pesantsi/CustomPcbs/TooManyKeys/Diagrams/Bonjour.docx

Bonjour,

Je me fais un petit projet d'un keyboard et j'aimerais faire couper la plaque du dessus qui contient les touches, avez-vous différents métaux?

J'aimerais bien hot rolled steel 1.5mm ou un équivalent pour son poids et sa solidité.

Merci beaucoup

Hi,

I've created a custom keyboard prototype.

I would like the key plate to be laser cut from hot rolled mild steel of 1.5mm thickness or any other dark, heavy strong metal.

This is a prototype; it could end up having more orders.

Thanks
