pesantsi/CustomPcbs/TooManyKeys/Diagrams/Led Layout routing.png

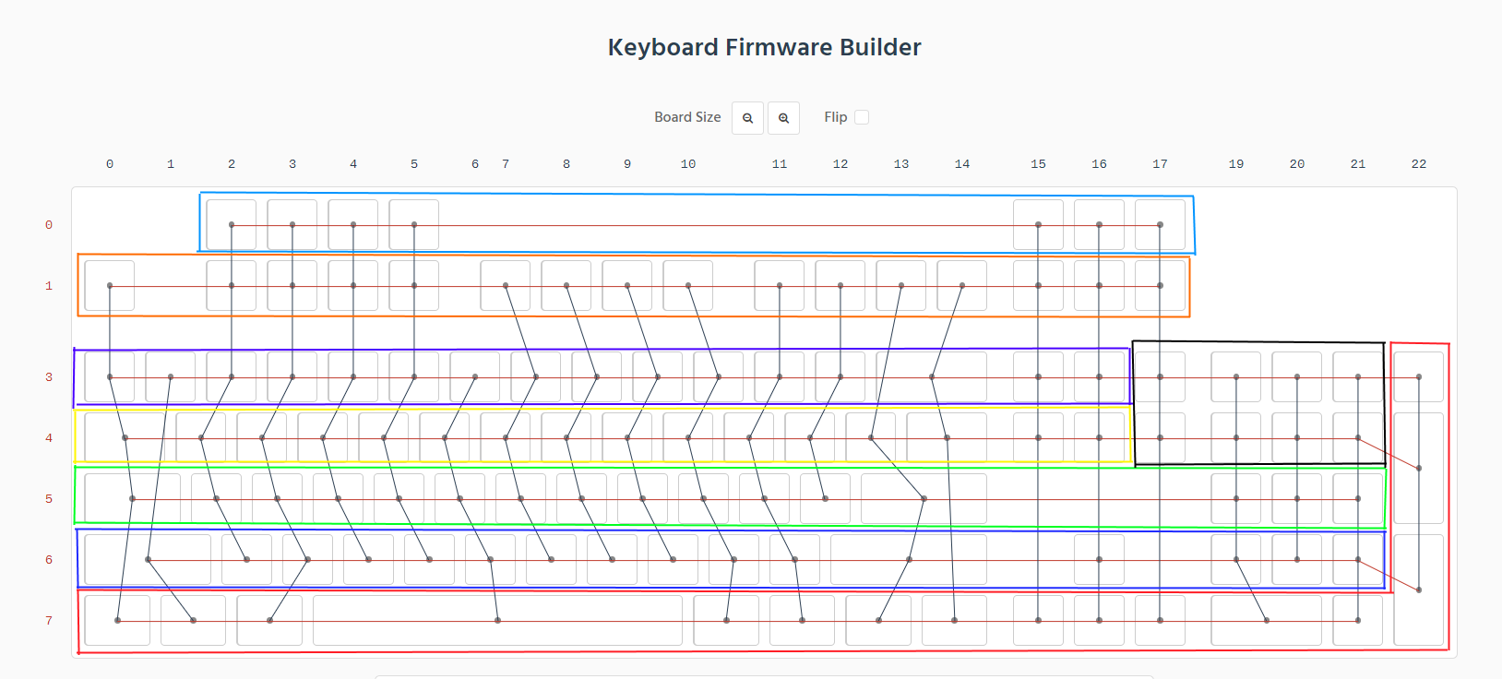
TooManyKeys/Diagrams/Led Layout routing.png
