pesantsi/CustomPcbs/TooManyKeys/KiCad/Resources/Pics/1054418752008t.jpg

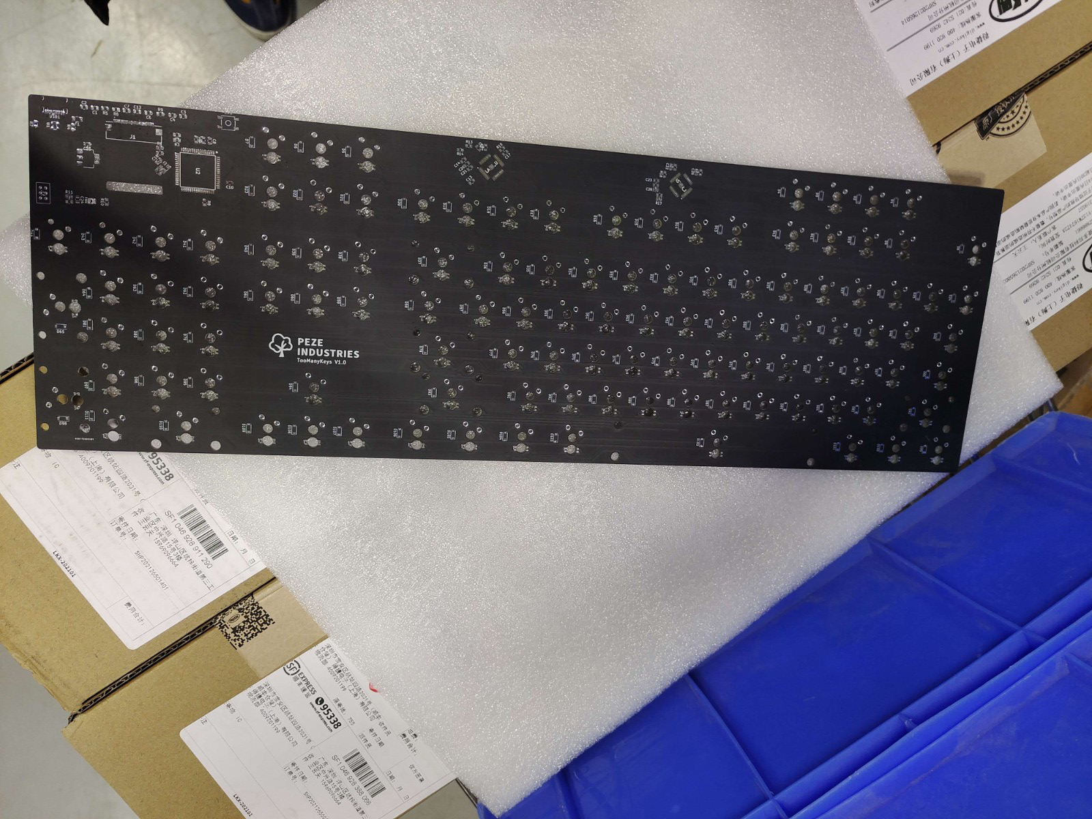
TooManyKeys/KiCad/Resources/Pics/1054418752008t.jpg
