pesantsi/CustomPcbs/TooManyKeys/KiCad/Resources/Pics/1054459162442t.jpg

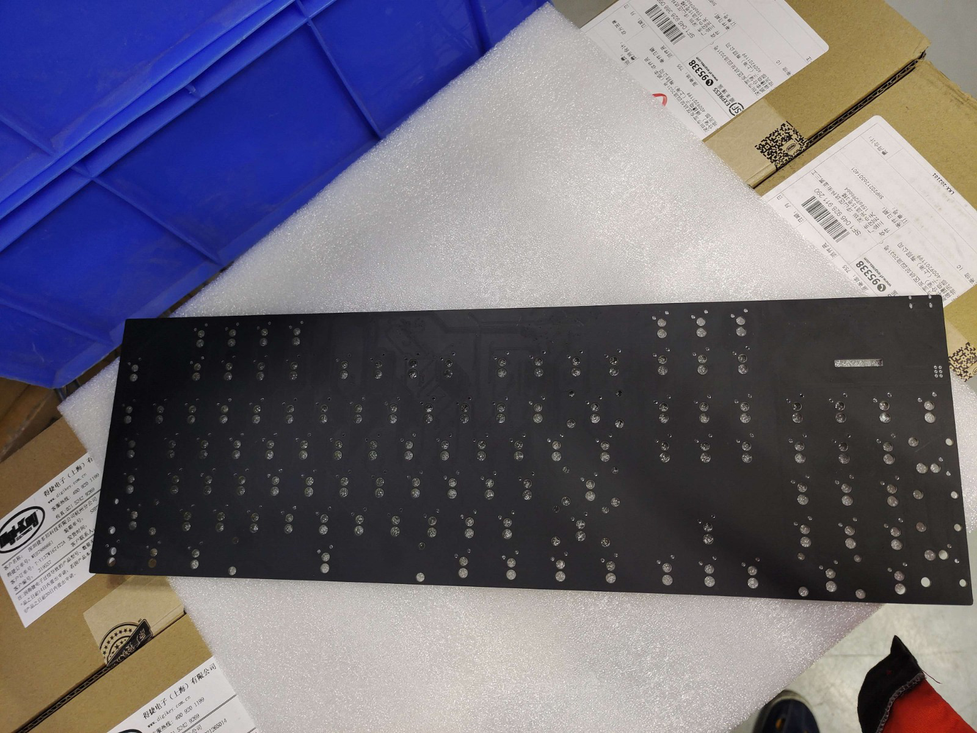
TooManyKeys/KiCad/Resources/Pics/1054459162442t.jpg
