pesantsi/CustomPcbs/TooManyKeys/KiCad/Resources/duckypad_v2_bom.xlsx

Qty | Value | Device | Parts
4 | 1uF | 0805 Capacitor | C3, C4, C6, C28
3 | 2.2uF | 0805 Capacitor | C5, C7, C8
4 | 5.1K | 0805 Resistor | R1, R7, R8, R9
4 | 10K | 0805 Resistor | R2, R4, R5, R17
1 | 47uF | 1210 Tantalum Capacitor | C27
1 |  | 74LVC1G08 | IC3
20 | 100nF | 0805 Capacitor | C1, C2, C9, C10, C11, C12, C13, C14, C15, C16, C17, C18, C19, C20, C21, C22, C23, C24, C25, C29
4 |  | Tactile Switch | SW1, SW2, SW3, SW4
1 | 560K | 0805 Resistor | R3
15 |  | CherryMX-style Key Switch | S1, S2, S3, S4, S5, S6, S7, S8, S9, S10, S11, S12, S13, S14, S15
1 | 3.3V | 1117 Regulator | IC2
1 |  | STM32F072C8T6 | IC1
1 |  | MicroSD Sard Holder | SD1
1 |  | 30 pin FPC Connecter for OLED, Upper Contact | U1
1 |  | USB-C Connector 16Pin | U2
15 |  | SK6812 RGB LED | LED1, LED2, LED3, LED4, LED5, LED6, LED7, LED8, LED9, LED10, LED11, LED12, LED13, LED14, LED15
