pesantsi/CustomPcbs/TooManyKeys/Diagrams/Updated T-1N2W367723A-W367723AS1N1-1sets-TooManyKeys2.html 2021-2-5.xlsx

C:\Git\CustomPcbs\TooManyKeys\KiCad\TooManyKeys.sch
2021-02-01 09:52
Eeschema (5.1.9)-1
Component Count:281
Ref | Qnty | Value | Part | Footprint | Description | Vendor | Unit Price 5sets | Total Price | PCBWay Comments
C1, C2, C3, C5, C8, C12 | 6 | 1uF | Device:C_Small | Capacitor_SMD:C_0805_2012Metric | Unpolarized capacitor, small symbol |  | $0.052 | $1.575 | 1UF 50V 0805
C4, C6, C7 | 3 | 2.2uF | Device:C_Small | Capacitor_SMD:C_0805_2012Metric | Unpolarized capacitor, small symbol |  | $0.105 | $1.575 | 2.2UF 6.3V 0805
C9, C10, C11, C13, C16, C20, C22, C26, C29 | 9 | 0.1uF | Device:C_Small | Capacitor_SMD:C_0805_2012Metric | Unpolarized capacitor, small symbol |  | $0.052 | $2.363 | 0.1UF 50V 0805
C14, C17, C19, C21, C23, C27, C28, C30 | 8 | 0.47uF | Device:C_Small | Capacitor_SMD:C_0805_2012Metric | Unpolarized capacitor, small symbol |  | $0.105 | $4.200 | 0.47UF 16V 0805
C15, C18 | 2 | 22pF | Device:C_Small | Capacitor_SMD:C_0805_2012Metric | Unpolarized capacitor, small symbol |  | $0.052 | $0.525 | 22PF 50V 0805
C24 | 1 | 10uF | Device:C_Small | Capacitor_SMD:C_0805_2012Metric | Unpolarized capacitor, small symbol |  | $0.210 | $1.050 | 10UF 6.3V 0805
C25 | 1 | 22uF | Device:C_Small | Capacitor_SMD:C_0805_2012Metric | Unpolarized capacitor, small symbol |  | $0.210 | $1.050 | 22UF 6.3V 0805
D1, D2, D3, D4, D5, D6, D7, D8, D9, D10, D11, D12, D13, D14, D15, D16, D17, D18, D19, D20, D21, D22, D23, D24, D25, D26, D27, D28, D29, D30, D31, D32, D33, D34, D35, D36, D37, D38, D39, D40, D41, D42, D43, D44, D45, D46, D47, D48, D49, D50, D51, D52, D53, D54, D55, D56, D57, D58, D59, D60, D61, D62, D63, D64, D65, D66, D67, D68, D69, D70, D71, D72, D73, D74, D75, D76, D77, D78, D79, D80, D81, D82, D83, D84, D85, D86, D87, D88, D89, D90, D91, D92, D93, D94, D95, D96, D97, D98, D99, D100, D101, D102, D103, D104, D105, D106, D107, D108, D109, D110, D111 | 111 | SOD-123 | Device:D_Small | Diode_SMD:D_SOD-123 | Diode, small symbol |  | $0.105 | $58.275 | 1N4148W SOD123 | 1N4148W-TP | https://www.mccsemi.com/pdf/Products/1N4148W(SOD123).pdf
F1 | 1 | 1A | Device:Polyfuse | Fuse:Fuse_1206_3216Metric | Resettable fuse, polymeric positive temperature coefficient |  | $0.420 | $2.100 | 0ZCJ0100FF2E 7-10WORK DAYS | 0ZCJ0100FF2E | https://www.mouser.ca/datasheet/2/643/ds_CP_0zcj_series-1664160.pdf
J1 | 1 | 54104-3031 | SamacSys_Parts:505110-3091 | SamacSys_Parts:0541043033 | CONN FFC TOP 30POS 0.50MM R/A | https://www.molex.com/pdm_docs/sd/541043031_sd.pdf | $2.940 | $14.700 | 5-7work days
LED1, LED2, LED3, LED4, LED5, LED6, LED7, LED8, LED9, LED10, LED11, LED12, LED13, LED14, LED15, LED16, LED17, LED18, LED19, LED20, LED21, LED22, LED23, LED24, LED25, LED26, LED27, LED28, LED29, LED30, LED31, LED32, LED33, LED34, LED35, LED36, LED37, LED38, LED39, LED40, LED41, LED42, LED43, LED44, LED45, LED46, LED47, LED48, LED49, LED50, LED51, LED52, LED53, LED54, LED55, LED56, LED57, LED58, LED59, LED60, LED61, LED62, LED63, LED64, LED65, LED66, LED67, LED68, LED69, LED70, LED71, LED72, LED73, LED74, LED75, LED76, LED77, LED78, LED79, LED80, LED81, LED82, LED83, LED84, LED85, LED86, LED87, LED88, LED89, LED90, LED91, LED92, LED93, LED94, LED95, LED96, LED97, LED98, LED99, LED100, LED101, LED102, LED103, LED104, LED105, LED106, LED107, LED108, LED109, LED110, LED111 | 111 | QBLP677R-RGB | SamacSys_Parts:QBLP677R-RGB | SamacSys_Parts:QBLP677R-RGB |  | http://www.qt-brightek.com/datasheet/QBLP677R-RGB.pdf | $0.578 | $320.513 | 5-7work days
MASTER_U1, SLAVE_U1 | 2 | IS31FL3733-TQ | Driver_LED:IS31FL3733-TQ | SamacSys_Parts:QFP50P900X900X120-49N | 12x16 LED matrix driver with 8-bit PWM and breathing, TQFP-48 | http://www.issi.com/WW/pdf/IS31FL3733.pdf | $3.675 | $36.750 | We will supply IS31FL3733-TQLS4 5-7work days | OK
R1, R8, R13, R16 | 4 | 10k | Device:R_Small | Resistor_SMD:R_0805_2012Metric | Resistor, small symbol |  | $0.052 | $1.050
R2, R3 | 2 | 22 | Device:R_Small | Resistor_SMD:R_0805_2012Metric | Resistor, small symbol |  | $0.052 | $0.525 | 22R
R4, R7 | 2 | 5.1k | Device:R_Small | Resistor_SMD:R_0805_2012Metric | Resistor, small symbol |  | $0.052 | $0.525
R5, R6 | 2 | 2.2k | Device:R_Small | Resistor_SMD:R_0805_2012Metric | Resistor, small symbol |  | $0.052 | $0.525
R9 | 1 | 560K | Device:R_Small | Resistor_SMD:R_0805_2012Metric | Resistor, small symbol |  | $0.052 | $0.263
R10 | 1 | 200k | Device:R_Small | Resistor_SMD:R_0805_2012Metric | Resistor, small symbol |  | $0.052 | $0.263
R11, R12 | 2 | 4.7k | Device:R_Small | Resistor_SMD:R_0805_2012Metric | Resistor, small symbol |  | $0.052 | $0.525
R14, R17 | 2 | 100k | Device:R_Small | Resistor_SMD:R_0805_2012Metric | Resistor, small symbol |  | $0.052 | $0.525
R15, R18 | 2 | 20k | Device:R_Small | Resistor_SMD:R_0805_2012Metric | Resistor, small symbol |  | $0.052 | $0.525
SW1 | 1 | SW_Push | Switch:SW_Push | random-keyboard-parts:SKQG-1155865 | Push button switch, generic, two pins | https://media.digikey.com/pdf/Data%20Sheets/C&K/RS-187R05-DS%20MT_RT.pdf | $0.840 | $4.200 | We will supply RS-187R05A2-DSMTRT ok? | OK
U1 | 1 | PRTR5V0U2X | random-keyboard-parts:PRTR5V0U2X | random-keyboard-parts:SOT143B |  | https://assets.nexperia.com/documents/data-sheet/PRTR5V0U2X.pdf | $0.315 | $1.575
U2 | 1 | AT90USB1286-AU | MCU_Microchip_AVR:AT90USB1286-AU | SamacSys_Parts:QFP80P1600X1600X120-64N | 16MHz, 128kB Flash, 8kB SRAM, 4kB EEPROM, USB 2.0, TQFP-64 | http://ww1.microchip.com/downloads/en/DeviceDoc/7593S.pdf | $10.185 | $50.925 | 5-7work days
U3 | 1 | PCA9306 | Interface:PCA9306 (PCA9306DQER) | SamacSys_Parts:SOP50P310X90-8N | Dual bidirectional I2C Bus and SMBus voltage level translator | https://www.ti.com/lit/ds/symlink/pca9306.pdf?HQS=dis-dk-null-digikeymode-dsf-pf-null-wwe&ts=1612196481852 | $0.840 | $4.200 | We will supply PCA9306DQER | OK | PCA9306TDCURQ1
U4 | 1 | AZ1117CH-3.3TRG1 | Regulator_Linear:AP1117-33 | Package_TO_SOT_SMD:SOT-223-3_TabPin2 | 1A Low Dropout regulator, positive, 3.3V fixed output, SOT-223 | https://www.diodes.com/assets/Datasheets/AZ1117C.pdf | $0.315 | $1.575
USB1 | 1 | HRO-TYPE-C-31-M-12 | TooManyKeys-rescue:HRO-TYPE-C-31-M-12-Type-C | Type-C:HRO-TYPE-C-31-M-12 |  | https://datasheet.lcsc.com/szlcsc/1811131825_Korean-Hroparts-Elec-TYPE-C-31-M-12_C165948.pdf | $1.050 | $5.250 | We will supply TYPE-C-31-M-12 | OK
Y1 | 1 | 16MHz | Device:Crystal_GND24_Small | Crystal:Crystal_SMD_3225-4Pin_3.2x2.5mm | Four pin crystal, GND on pins 2 and 4, small symbol | https://media.digikey.com/pdf/Data%20Sheets/AVX%20PDFs/CX3225SB16000D0GZJC1_Spec.pdf | $1.050 | $5.250 | NX3225SA-16.000M-STD-CSR-1 5-7WORK DAYS | NX3225SA-16.000M-STD-CSR-1 | https://media.digikey.com/pdf/Data%20Sheets/NDK%20PDFs/NX3225SA.pdf
 |  |  |  |  |  |  |  | $522.375
