pesantsi/CustomPcbs/TooManyKeys/4840ab9af1085f85478faeb8f759408f03c61fd2_switch.dxf

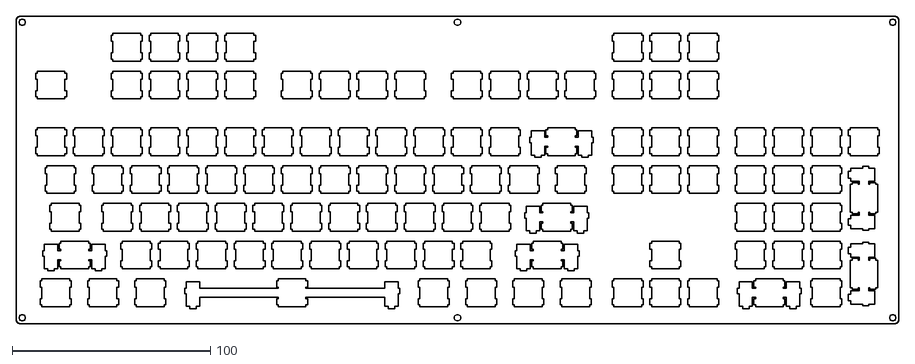
[picture p11: CAD file, 2021-01-27]
TooManyKeys/4840ab9af1085f85478faeb8f759408f03c61fd2_switch.dxf
444.6 x 154.9
