pesantsi/CustomPcbs/TooManyKeys/Diagrams/board_switch_v3.dxf

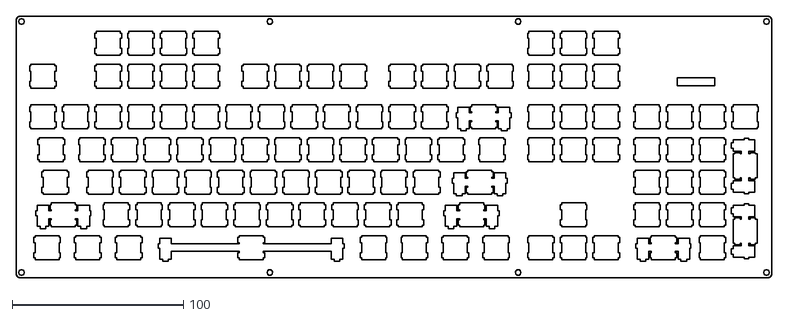
[picture p12: CAD file, 2021-02-05]
TooManyKeys/Diagrams/board_switch_v3.dxf
440.6 x 152.4
