pesantsi/CustomPcbs/TooManyKeys/Diagrams/4840ab9af1085f85478faeb8f759408f03c61fd2_switch_V2.dxf

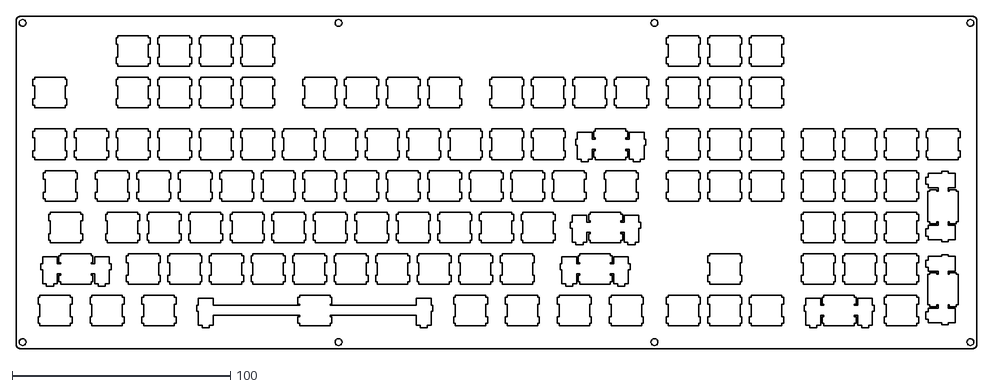
[picture p13: CAD file, 2021-02-05]
TooManyKeys/Diagrams/4840ab9af1085f85478faeb8f759408f03c61fd2_switch_V2.dxf
440.6 x 152.4
