pesantsi/CustomPcbs/TooManyKeys/Diagrams/board_switch_R14.dxf

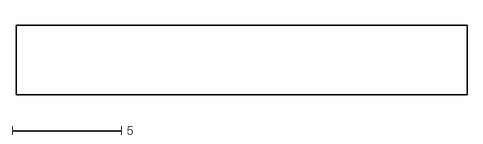
[picture p14: CAD file, 2021-02-01]
TooManyKeys/Diagrams/board_switch_R14.dxf
20.6 x 3.17
