pesantsi/CustomPcbs/TooManyKeys/Diagrams/board_switch_v2.dxf

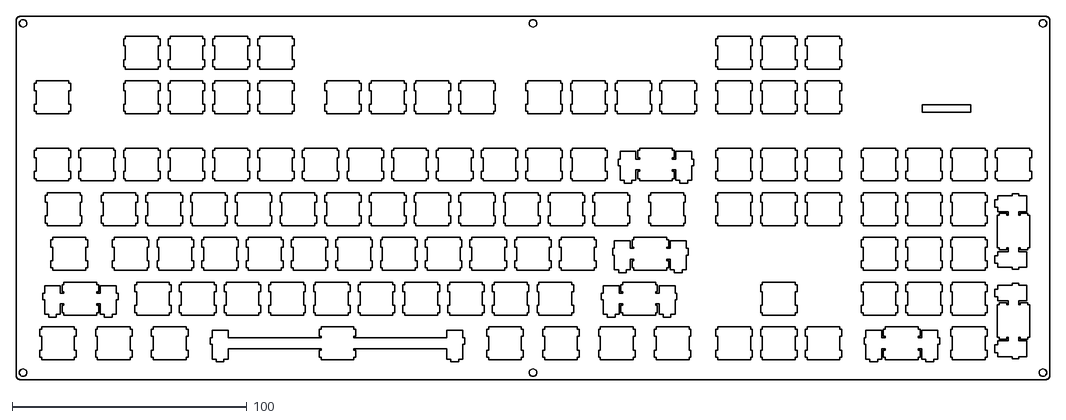
[picture p15: CAD file, 2021-02-02, an earlier design]
TooManyKeys/Diagrams/board_switch_v2.dxf
440.6 x 154.9
