pesantsi/CustomPcbs/TooManyKeys/Diagrams/4840ab9af1085f85478faeb8f759408f03c61fd2_switch.dxf

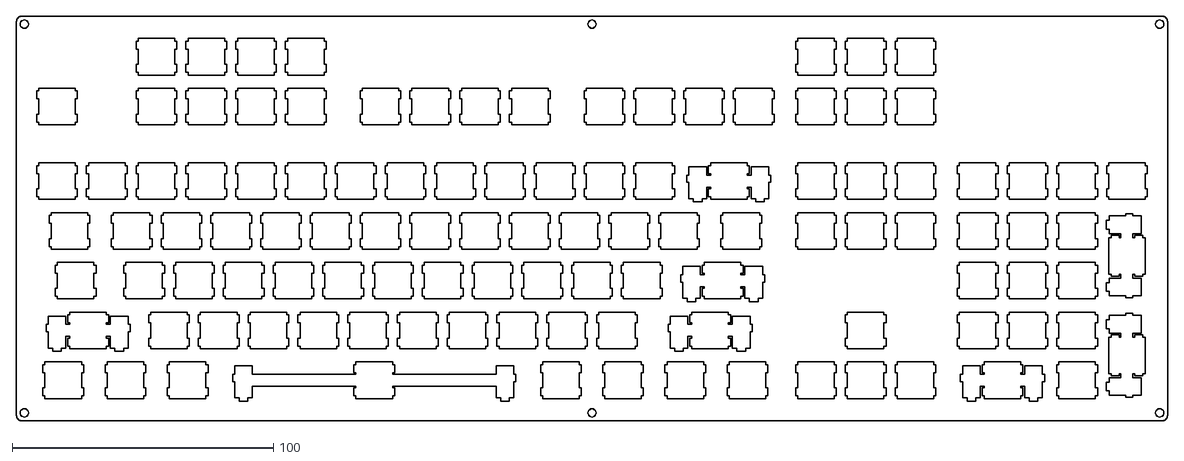
[picture p16: CAD file, 2021-01-28, an earlier design]
TooManyKeys/Diagrams/4840ab9af1085f85478faeb8f759408f03c61fd2_switch.dxf
440.6 x 154.9
