pesantsi/CustomPcbs/TooManyKeys/Diagrams/board_switch.dxf

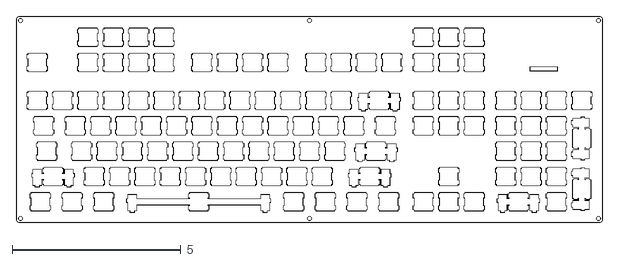
[picture p17: CAD file, 2021-01-28, an earlier design]
TooManyKeys/Diagrams/board_switch.dxf
17.4 x 6.10
