pesantsi/CustomPcbs/TooManyKeys/KiCad/Resources/Schematic Review to Micropcb repair.docx

# Master_U1 LED Driver

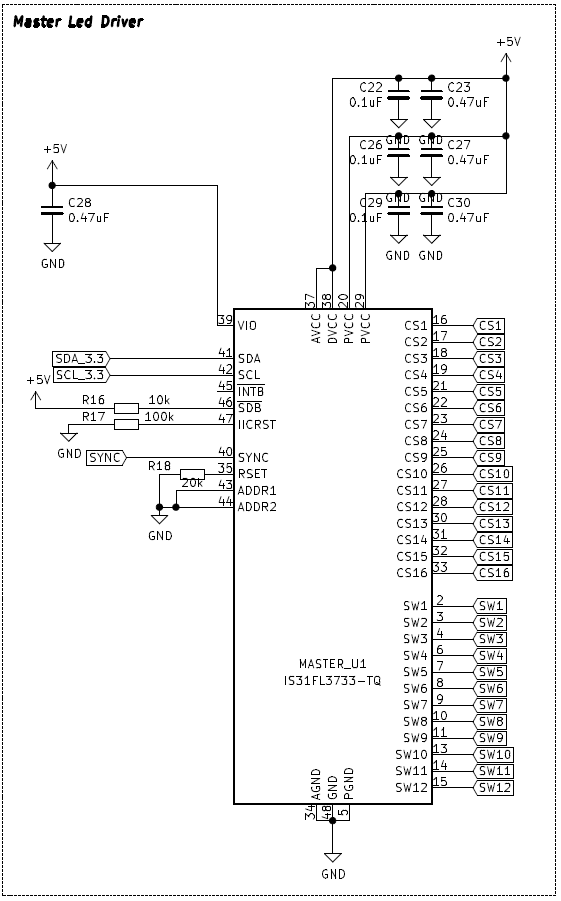
[picture p19: figure]

R16 should be 100k

# Slave_U1 LED Driver

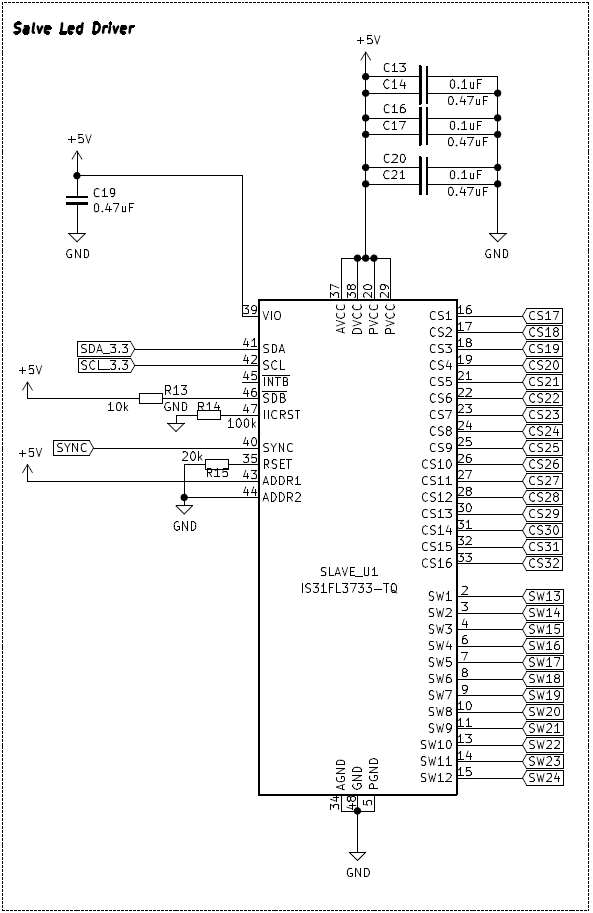
[picture p20: figure]

R13 should be 100k

# OLED Driver

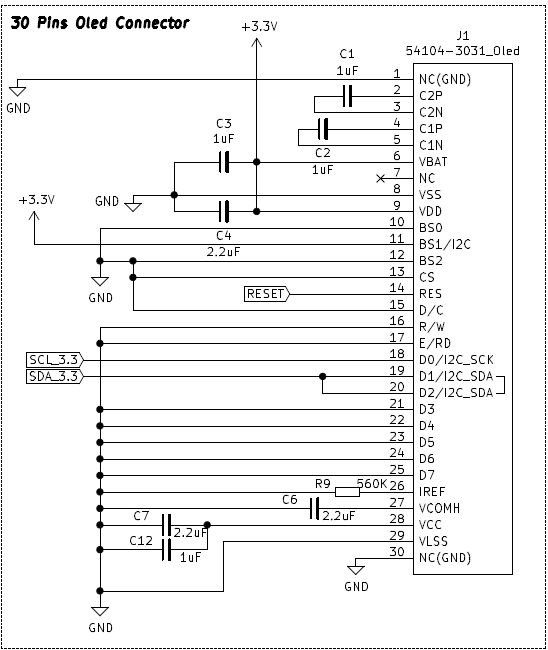
[picture p21: figure]

Connect the NC (pin 7) to GND

# I2C Level Shifter

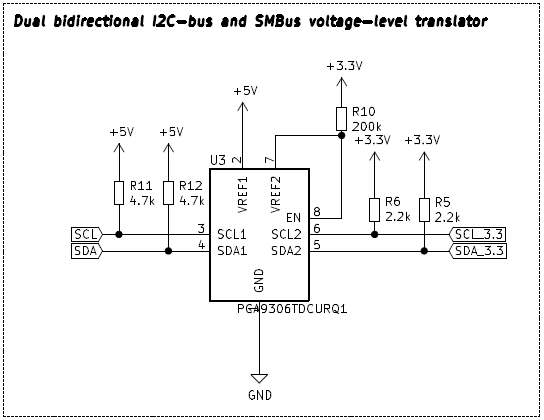
[picture p22: figure]

Swap +5V and +3.3V for all signals, this may be on breadboard.

Should look like this

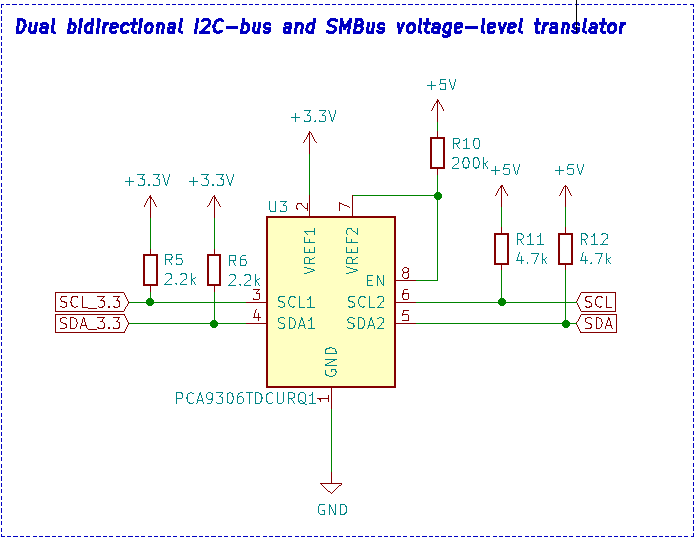
[picture p23: figure]

# I2C Connections

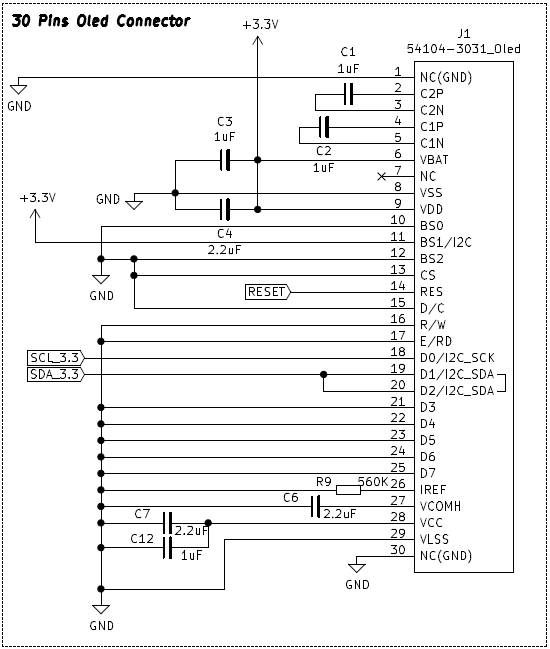
[picture p24: figure]

Connect pin 18 to new voltage-level translator SCL_3.3.
Connect pin 19 and pin 20 to new voltage-level translator SDA_3.3.

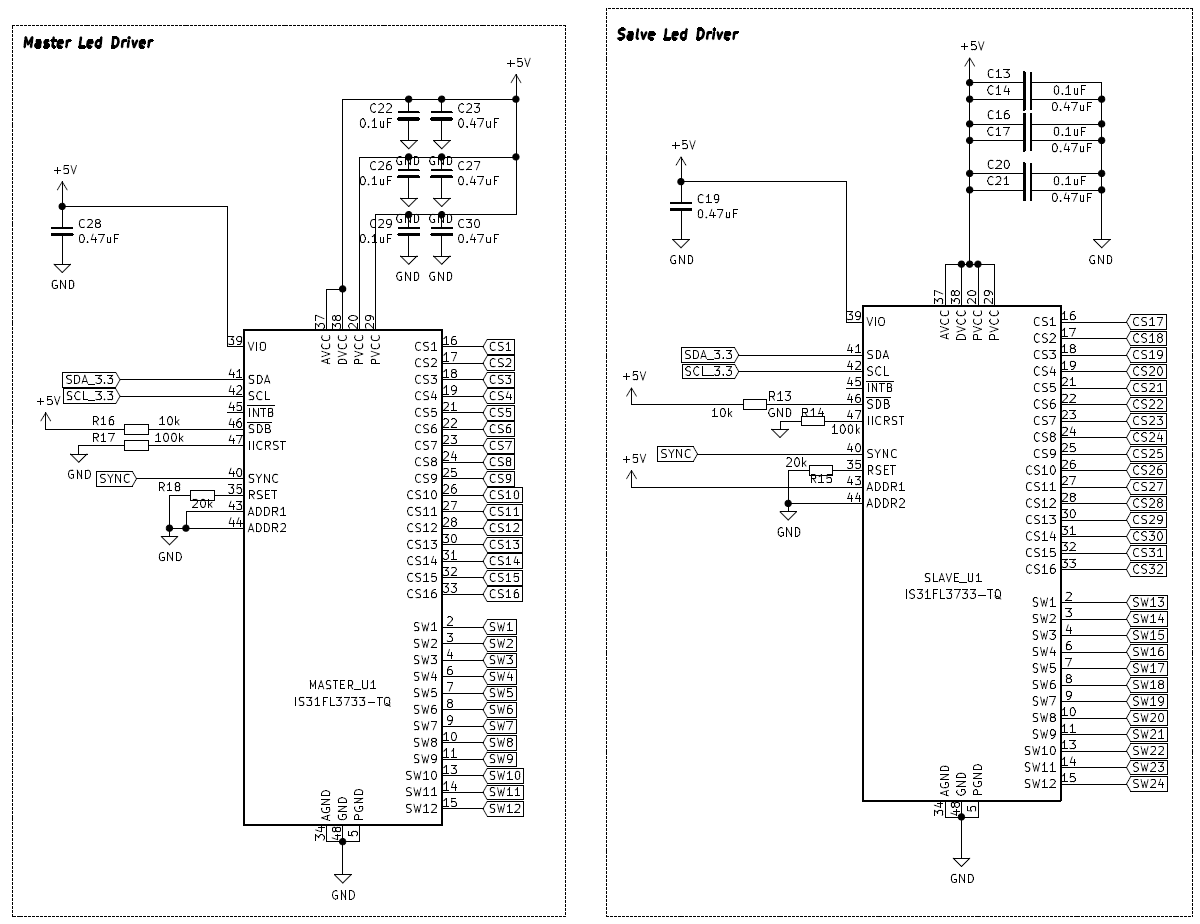
[picture p25: figure]

Connect pin 41 on both Master and Slave together to new voltage-level translator SDA.
Connect pin 42 on both Master and Slave together to new voltage-level translator SCL.
