pesantsi/CustomPcbs/ProtoTooManyKeys/schematic.pdf

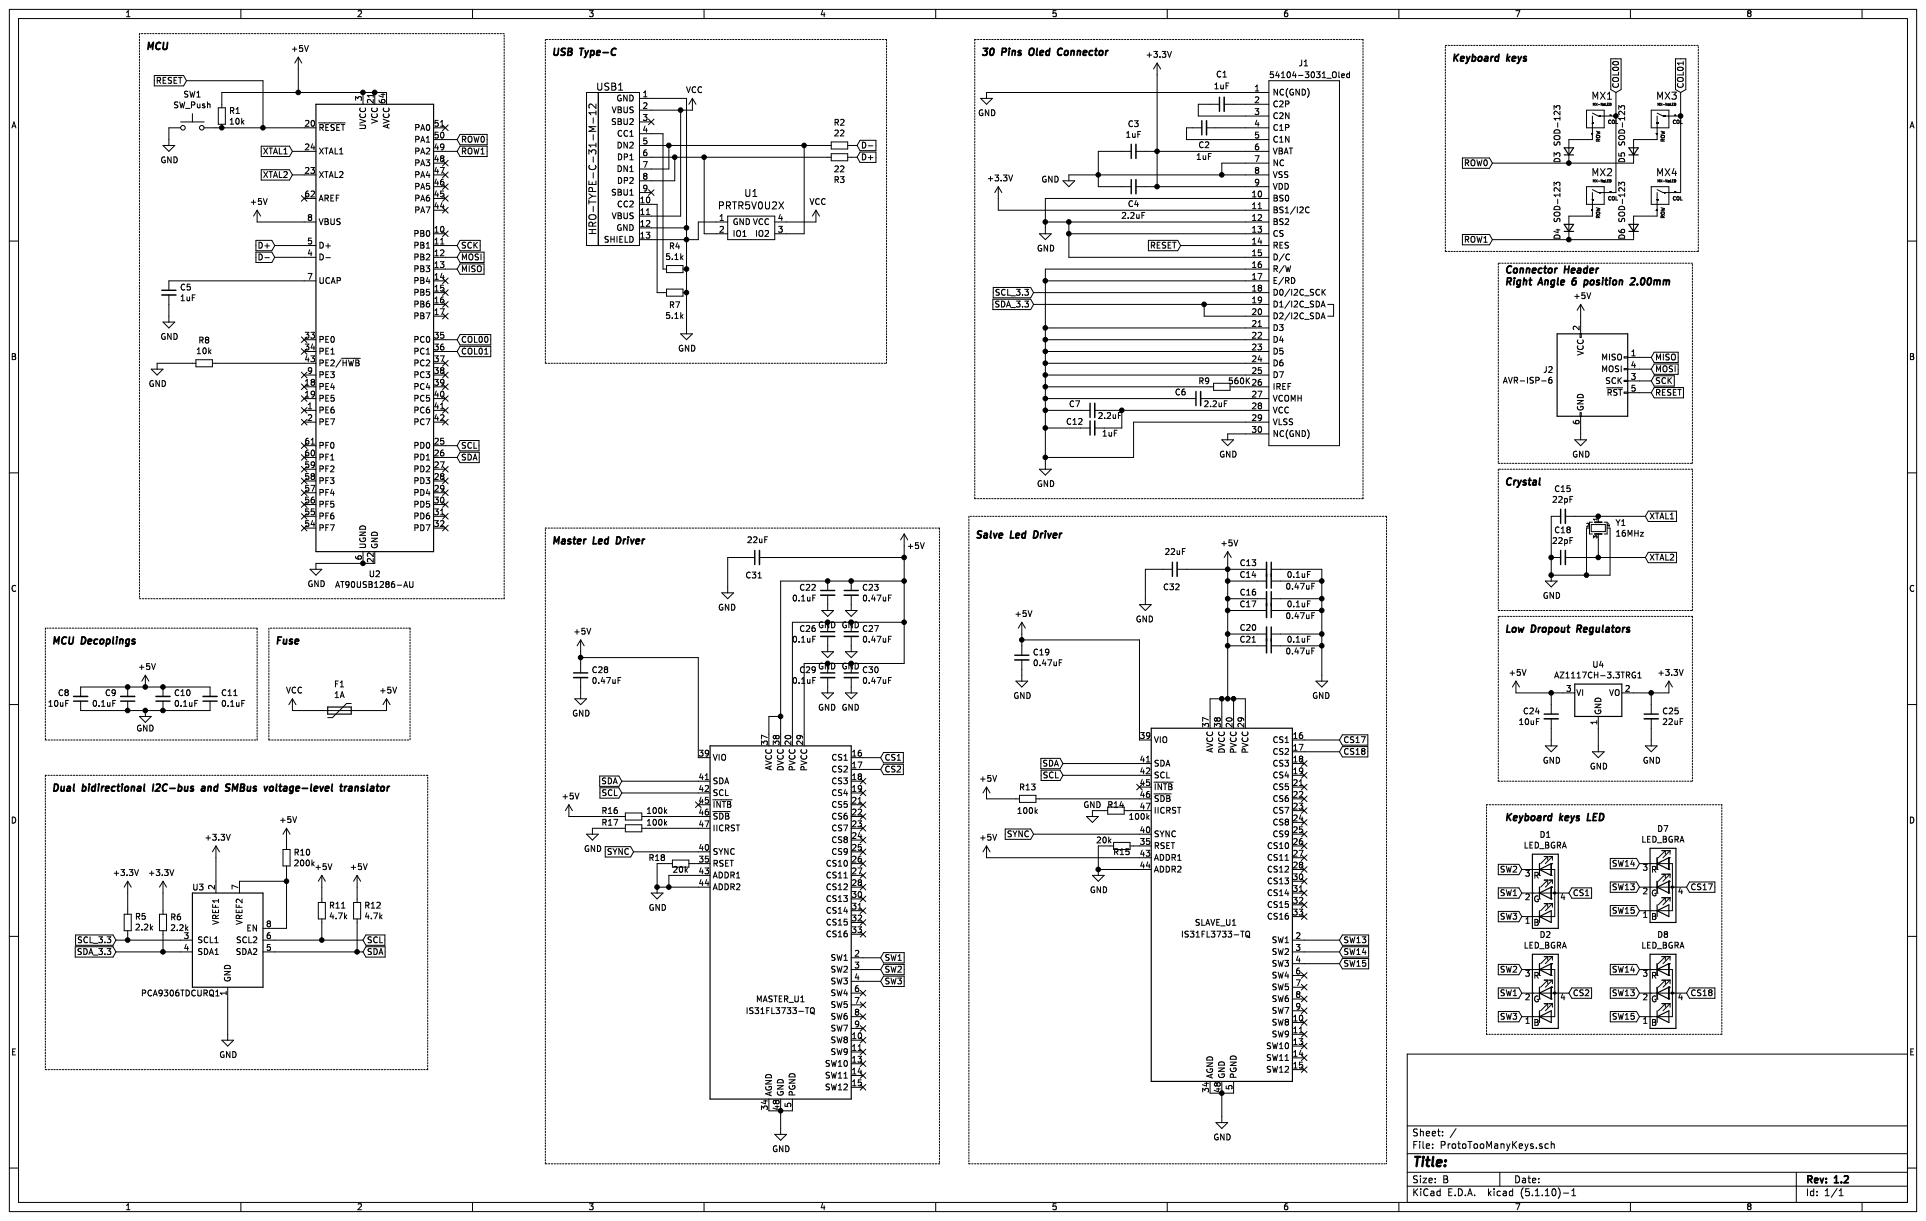
[picture p26: page 1]
