pesantsi/CustomPcbs/ProtoTooManyKeys/ProtoTooManyKeys.kicad_pcb

## KiCad design ProtoTooManyKeys/ProtoTooManyKeys.kicad_pcb (2021-07-22)

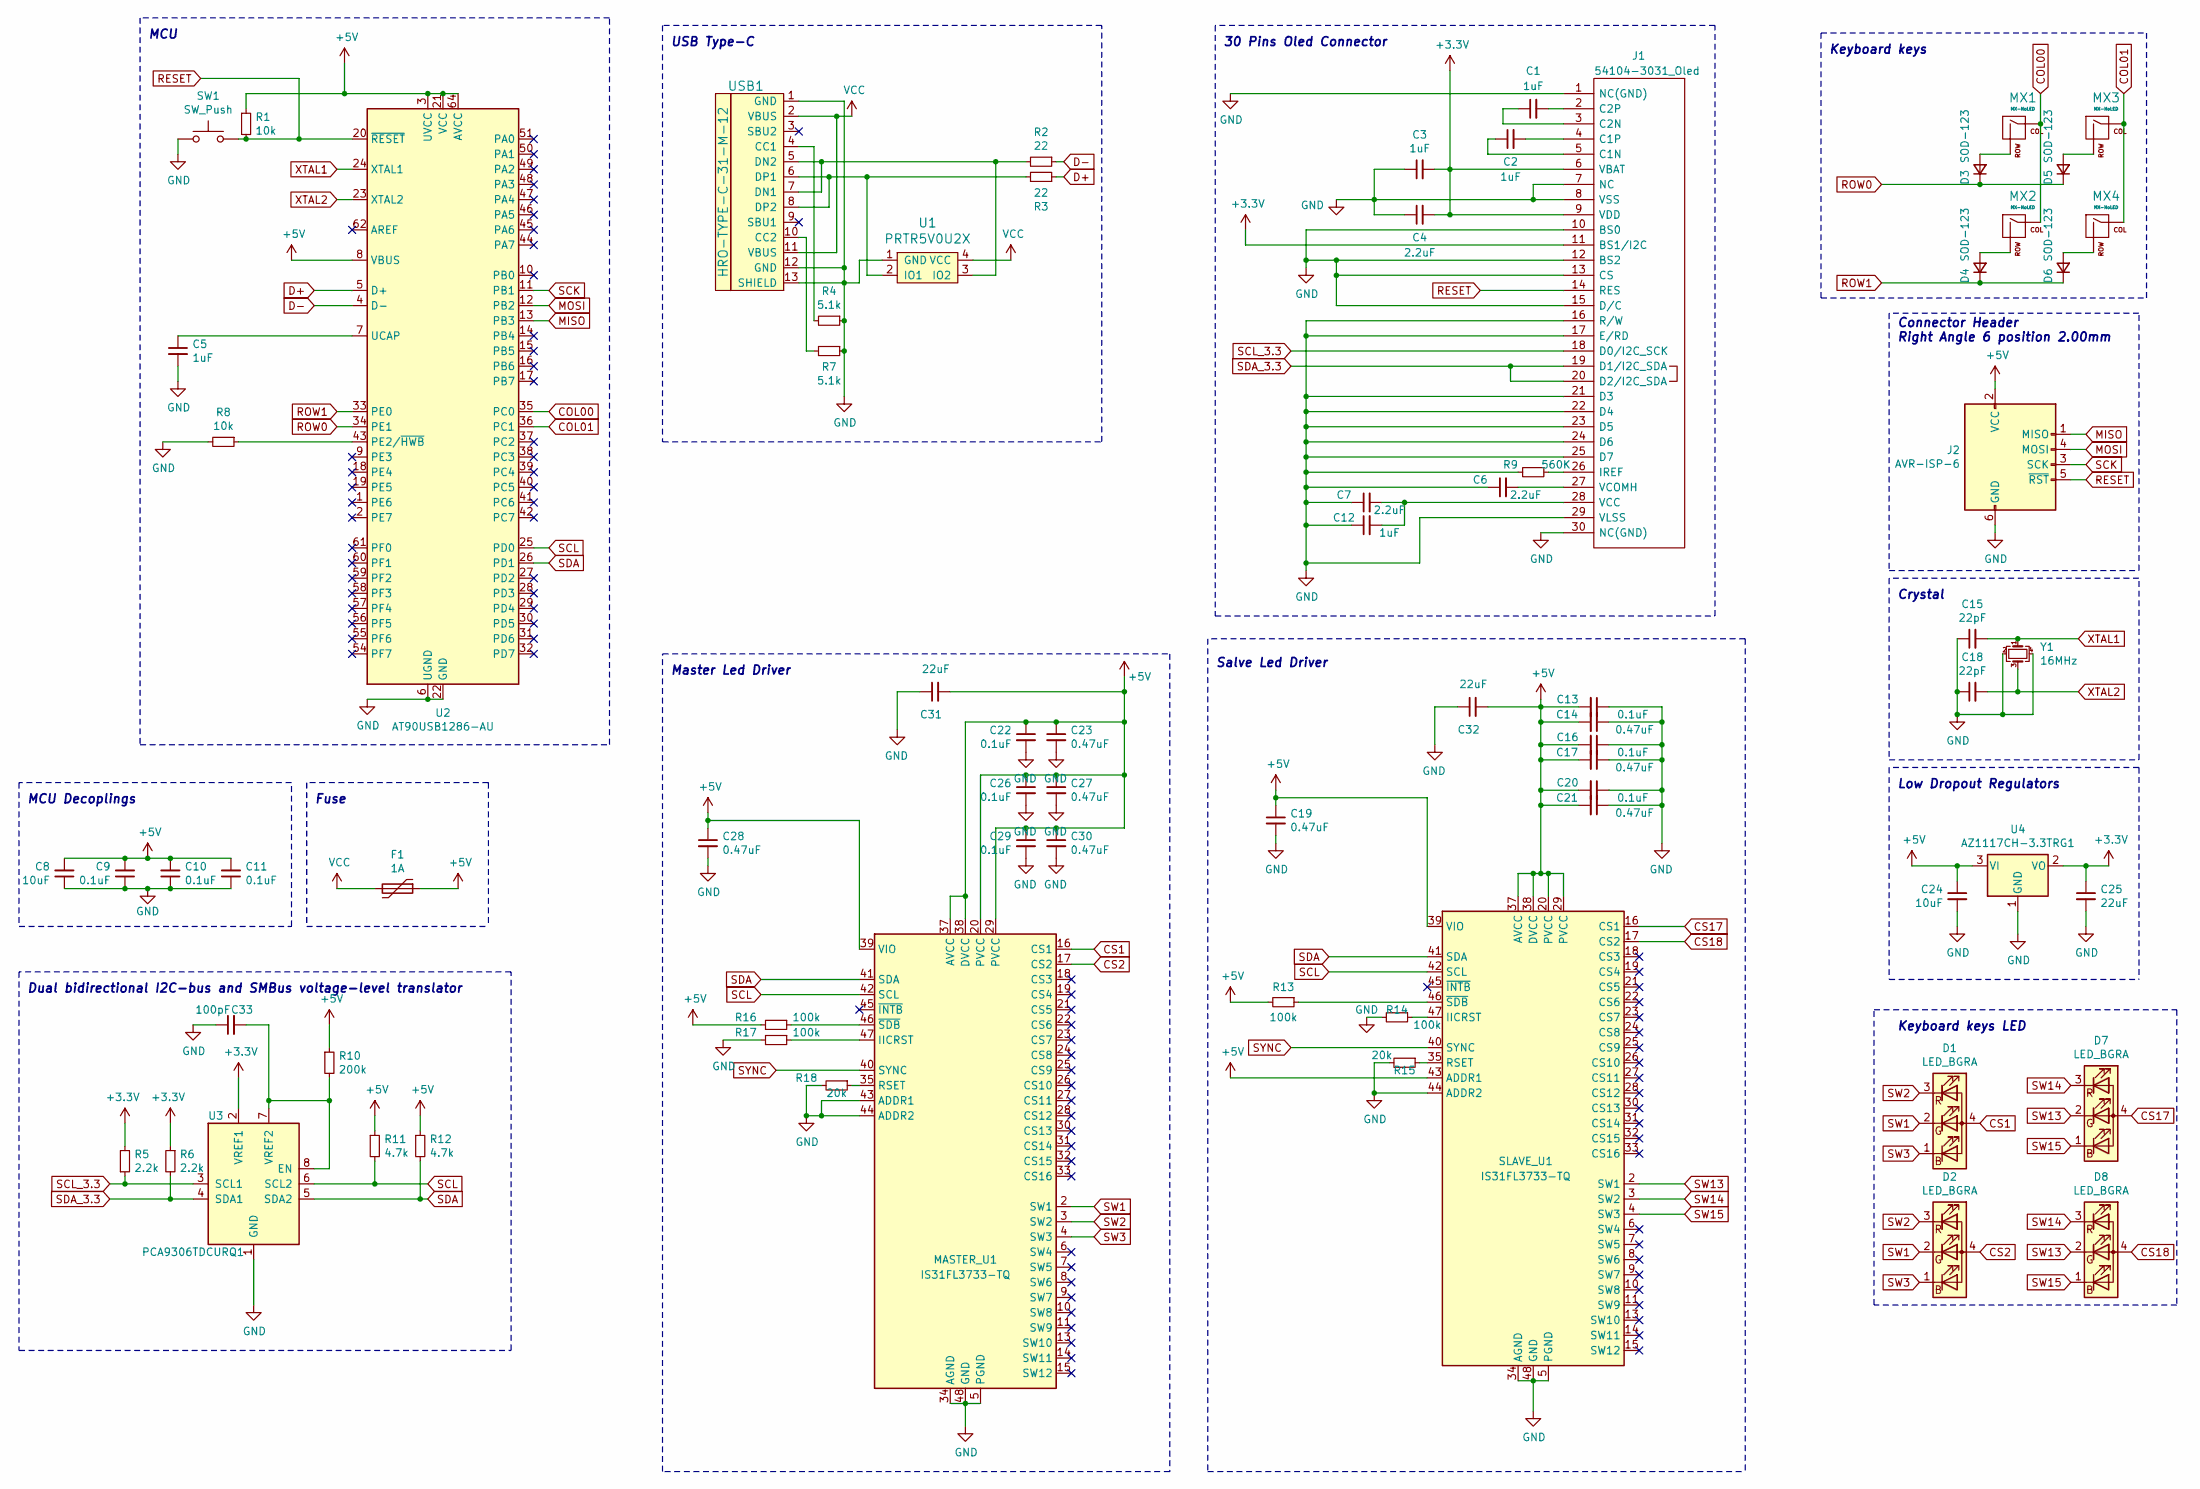
[picture p27: schematic ProtoTooManyKeys.sch]

Parts:
C1, C2, C3, C5, C12: 1uF; C_0805_2012Metric
C4, C6, C7: 2.2uF; C_0805_2012Metric
C8, C24: 10uF; C_0805_2012Metric
C9, C10, C11, C13, C16, C20, C22, C26, C29: 0.1uF; C_0805_2012Metric
C14, C17, C19, C21, C23, C27, C28, C30: 0.47uF; C_0805_2012Metric
C15, C18: 22pF; C_0805_2012Metric
C25, C31, C32: 22uF; C_0805_2012Metric
C33: 100pF; C_0805_2012Metric
D1, D2, D7, D8: LED_BGRA; QBLP677R-RGB
D3, D4, D5, D6: SOD-123; D_SOD-123
F1: 1A; Fuse_1206_3216Metric
J1: 54104-3031_Oled; 5051103091; Mouser Part Number 538-505110-3091
J2: AVR-ISP-6; SWR204NRTND03STGA
MASTER_U1: IS31FL3733-TQ; IS31FL3733-TQLS4
MX1, MX2, MX3, MX4: MX-NoLED; MXOnly-1U-NoLED_3Pins
R1, R8: 10k; R_0805_2012Metric
R2, R3: 22; R_0805_2012Metric
R4, R7: 5.1k; R_0805_2012Metric
R5, R6: 2.2k; R_0805_2012Metric
R9: 560K; R_0805_2012Metric
R10: 200k; R_0805_2012Metric
R11, R12: 4.7k; R_0805_2012Metric
R13, R14, R16, R17: 100k; R_0805_2012Metric
R15, R18: 20k; R_0805_2012Metric
SLAVE_U1: IS31FL3733-TQ; IS31FL3733-TQLS4
SW1: SW_Push; SKQG-1155865
U1: PRTR5V0U2X; SOT143B
U2: AT90USB1286-AU
U3: PCA9306TDCURQ1
U4: AZ1117CH-3.3TRG1; SOT-223-3_TabPin2
USB1: HRO-TYPE-C-31-M-12
Y1: 16MHz; Crystal_SMD_3225-4Pin_3.2x2.5mm

Connections:
+3V3: C3.2, C4.2, C25.1, J1.6 (VBAT), J1.9 (VDD), J1.11 (BS1/I2C), R5.2, R6.1, U3.2 (VREF1), U4.2 (VO)
+5V: C8.2, C9.2, C10.2, C11.2, C13.2, C14.2, C16.2, C17.2, C19.1, C20.2, C21.2, C22.1, C23.1, C24.1, C26.1, C27.1, C28.1, C29.1, C30.1, C31.2, C32.2, F1.1, J2.2 (VCC), MASTER_U1.20 (PVCC), MASTER_U1.29 (PVCC), MASTER_U1.37 (AVCC), MASTER_U1.38 (DVCC), MASTER_U1.39 (VIO), R1.1, R10.1, R11.1, R12.1, R13.2, R16.2, SLAVE_U1.20 (PVCC), SLAVE_U1.29 (PVCC), SLAVE_U1.37 (AVCC), SLAVE_U1.38 (DVCC), SLAVE_U1.39 (VIO), SLAVE_U1.43 (ADDR1), U2.3 (UVCC), U2.8 (VBUS), U2.21 (VCC), U2.52 (VCC), U2.64 (AVCC), U4.3 (VI)
COL00: MX1.1 (COL), MX2.1 (COL), U2.35 (PC0)
COL01: MX3.1 (COL), MX4.1 (COL), U2.36 (PC1)
CS1: D1.4 (A), MASTER_U1.16 (CS1)
CS2: D2.4 (A), MASTER_U1.17 (CS2)
CS17: D7.4 (A), SLAVE_U1.16 (CS1)
CS18: D8.4 (A), SLAVE_U1.17 (CS2)
D+: R3.1, U2.5 (D+)
D-: R2.1, U2.4 (D-)
GND: C3.1, C4.1, C5.2, C6.1, C7.1, C8.1, C9.1, C10.1, C11.1, C12.1, C13.1, C14.1, C15.1, C16.1, C17.1, C18.1, C19.2, C20.1, C21.1, C22.2, C23.2, C24.2, C25.2, C26.2, C27.2, C28.2, C29.2, C30.2, C31.1, C32.1, C33.1, J1.1 (NC(GND)), J1.7 (NC), J1.8 (VSS), J1.10 (BS0), J1.12 (BS2), J1.13 (CS), J1.15 (D/C), J1.16 (R/W), J1.17 (E/RD), J1.21 (D3), J1.22 (D4), J1.23 (D5), J1.24 (D6), J1.25 (D7), J1.29 (VLSS), J1.30 (NC(GND)), J2.6 (GND), MASTER_U1.5 (PGND), MASTER_U1.12 (PGND), MASTER_U1.34 (AGND), MASTER_U1.43 (ADDR1), MASTER_U1.44 (ADDR2), MASTER_U1.48 (GND), MASTER_U1.49 (GND), R4.1, R7.1, R8.2, R9.2, R14.2, R15.2, R17.2, R18.2, SLAVE_U1.5 (PGND), SLAVE_U1.12 (PGND), SLAVE_U1.34 (AGND), SLAVE_U1.44 (ADDR2), SLAVE_U1.48 (GND), SLAVE_U1.49 (GND), SW1.1, U1.1 (GND), U2.6 (UGND), U2.22 (GND), U2.53 (GND), U2.63 (GND), U3.1 (GND), U4.1 (GND), USB1.1 (GND), USB1.12 (GND), USB1.13 (SHIELD), Y1.2, Y1.4
MISO: J2.1 (MISO), U2.13 (PB3)
MOSI: J2.4 (MOSI), U2.12 (PB2)
unnamed: C1.1, J1.3 (C2N)
unnamed: C1.2, J1.2 (C2P)
unnamed: C2.1, J1.5 (C1N)
unnamed: C2.2, J1.4 (C1P)
unnamed: C5.1, U2.7 (UCAP)
unnamed: C6.2, J1.27 (VCOMH)
unnamed: C7.2, C12.2, J1.28 (VCC)
unnamed: C33.2, R10.2, U3.7 (VREF2), U3.8 (EN)
unnamed: D3.2 (A), MX1.2 (ROW)
unnamed: D4.2 (A), MX2.2 (ROW)
unnamed: D5.2 (A), MX3.2 (ROW)
unnamed: D6.2 (A), MX4.2 (ROW)
unnamed: J1.26 (IREF), R9.1
unnamed: MASTER_U1.35 (RSET), R18.1
unnamed: MASTER_U1.46 (~SDB), R16.1
unnamed: MASTER_U1.47 (IICRST), R17.1
unnamed: R2.2, U1.3 (IO2), USB1.5 (DN2), USB1.7 (DN1)
unnamed: R3.2, U1.2 (IO1), USB1.6 (DP1), USB1.8 (DP2)
unnamed: R4.2, USB1.4 (CC1)
unnamed: R7.2, USB1.10 (CC2)
unnamed: R8.1, U2.43 (PE2/~HWB)
unnamed: R13.1, SLAVE_U1.46 (~SDB)
unnamed: R14.1, SLAVE_U1.47 (IICRST)
unnamed: R15.1, SLAVE_U1.35 (RSET)
RESET: J1.14 (RES), J2.5 (~RST), R1.2, SW1.2, U2.20 (~RESET)
ROW0: D3.1 (K), D5.1 (K), U2.34 (PE1)
ROW1: D4.1 (K), D6.1 (K), U2.33 (PE0)
SCK: J2.3 (SCK), U2.11 (PB1)
SCL: MASTER_U1.42 (SCL), R11.2, SLAVE_U1.42 (SCL), U2.25 (PD0), U3.6 (SCL2)
SCL_3.3: J1.18 (D0/I2C_SCK), R5.1, U3.3 (SCL1)
SDA: MASTER_U1.41 (SDA), R12.2, SLAVE_U1.41 (SDA), U2.26 (PD1), U3.5 (SDA2)
SDA_3.3: J1.19 (D1/I2C_SDA), J1.20 (D2/I2C_SDA), R6.2, U3.4 (SDA1)
SW1: D1.2 (GK), D2.2 (GK), MASTER_U1.2 (SW1)
SW2: D1.3 (RK), D2.3 (RK), MASTER_U1.3 (SW2)
SW3: D1.1 (BK), D2.1 (BK), MASTER_U1.4 (SW3)
SW13: D7.2 (GK), D8.2 (GK), SLAVE_U1.2 (SW1)
SW14: D7.3 (RK), D8.3 (RK), SLAVE_U1.3 (SW2)
SW15: D7.1 (BK), D8.1 (BK), SLAVE_U1.4 (SW3)
SYNC: MASTER_U1.40 (SYNC), SLAVE_U1.40 (SYNC)
VCC: F1.2, U1.4 (VCC), USB1.2 (VBUS), USB1.11 (VBUS)
XTAL1: C15.2, U2.24 (XTAL1), Y1.1
XTAL2: C18.2, U2.23 (XTAL2), Y1.3

Notes on the sheet:
Dual bidirectional I2C-bus and SMBus voltage-level translator
Low Dropout Regulators
Crystal
MCU Decoplings
Fuse
Connector Header Right Angle 6 position 2.00mm
Master Led Driver
Salve Led Driver
30 Pins Oled Connector
USB Type-C
MCU
Keyboard keys
Keyboard keys LED

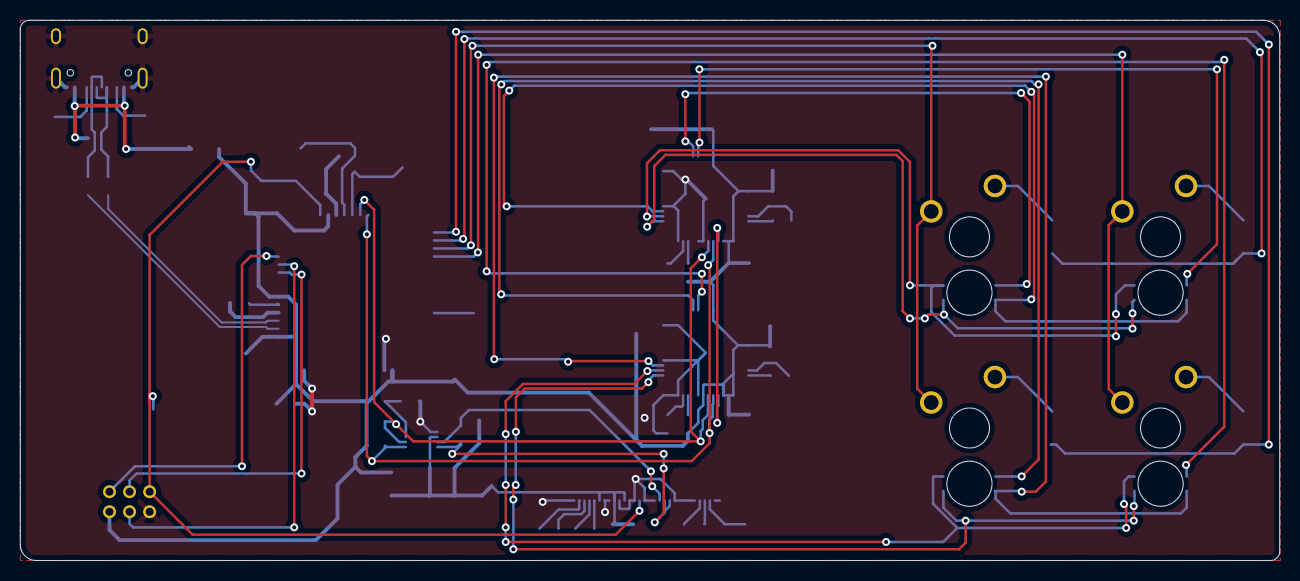
[picture p28: board ProtoTooManyKeys.kicad_pcb from above]

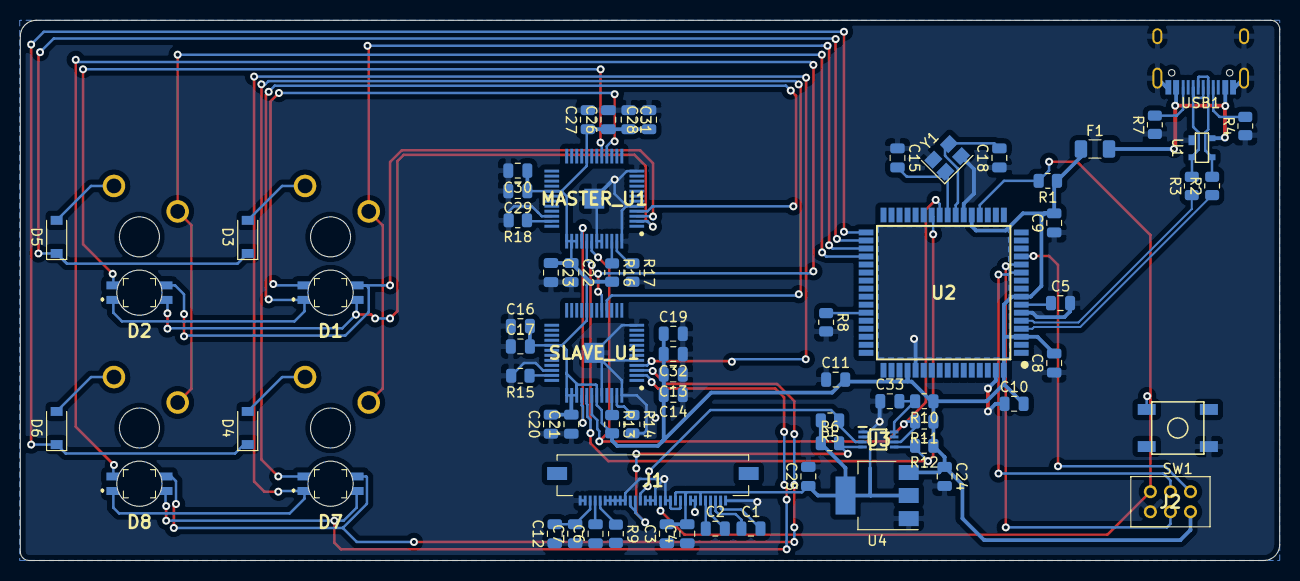
[picture p29: board ProtoTooManyKeys.kicad_pcb from below]

Board: 2 copper layers, 125.5 x 53.8 mm, 75 parts (71 on the bottom side), 55 nets.
