pesantsi/CustomPcbs/TooManyKeys/KiCad/TooManyKeys.kicad_pcb

## KiCad design TooManyKeys/KiCad/TooManyKeys.kicad_pcb (2021-05-20)

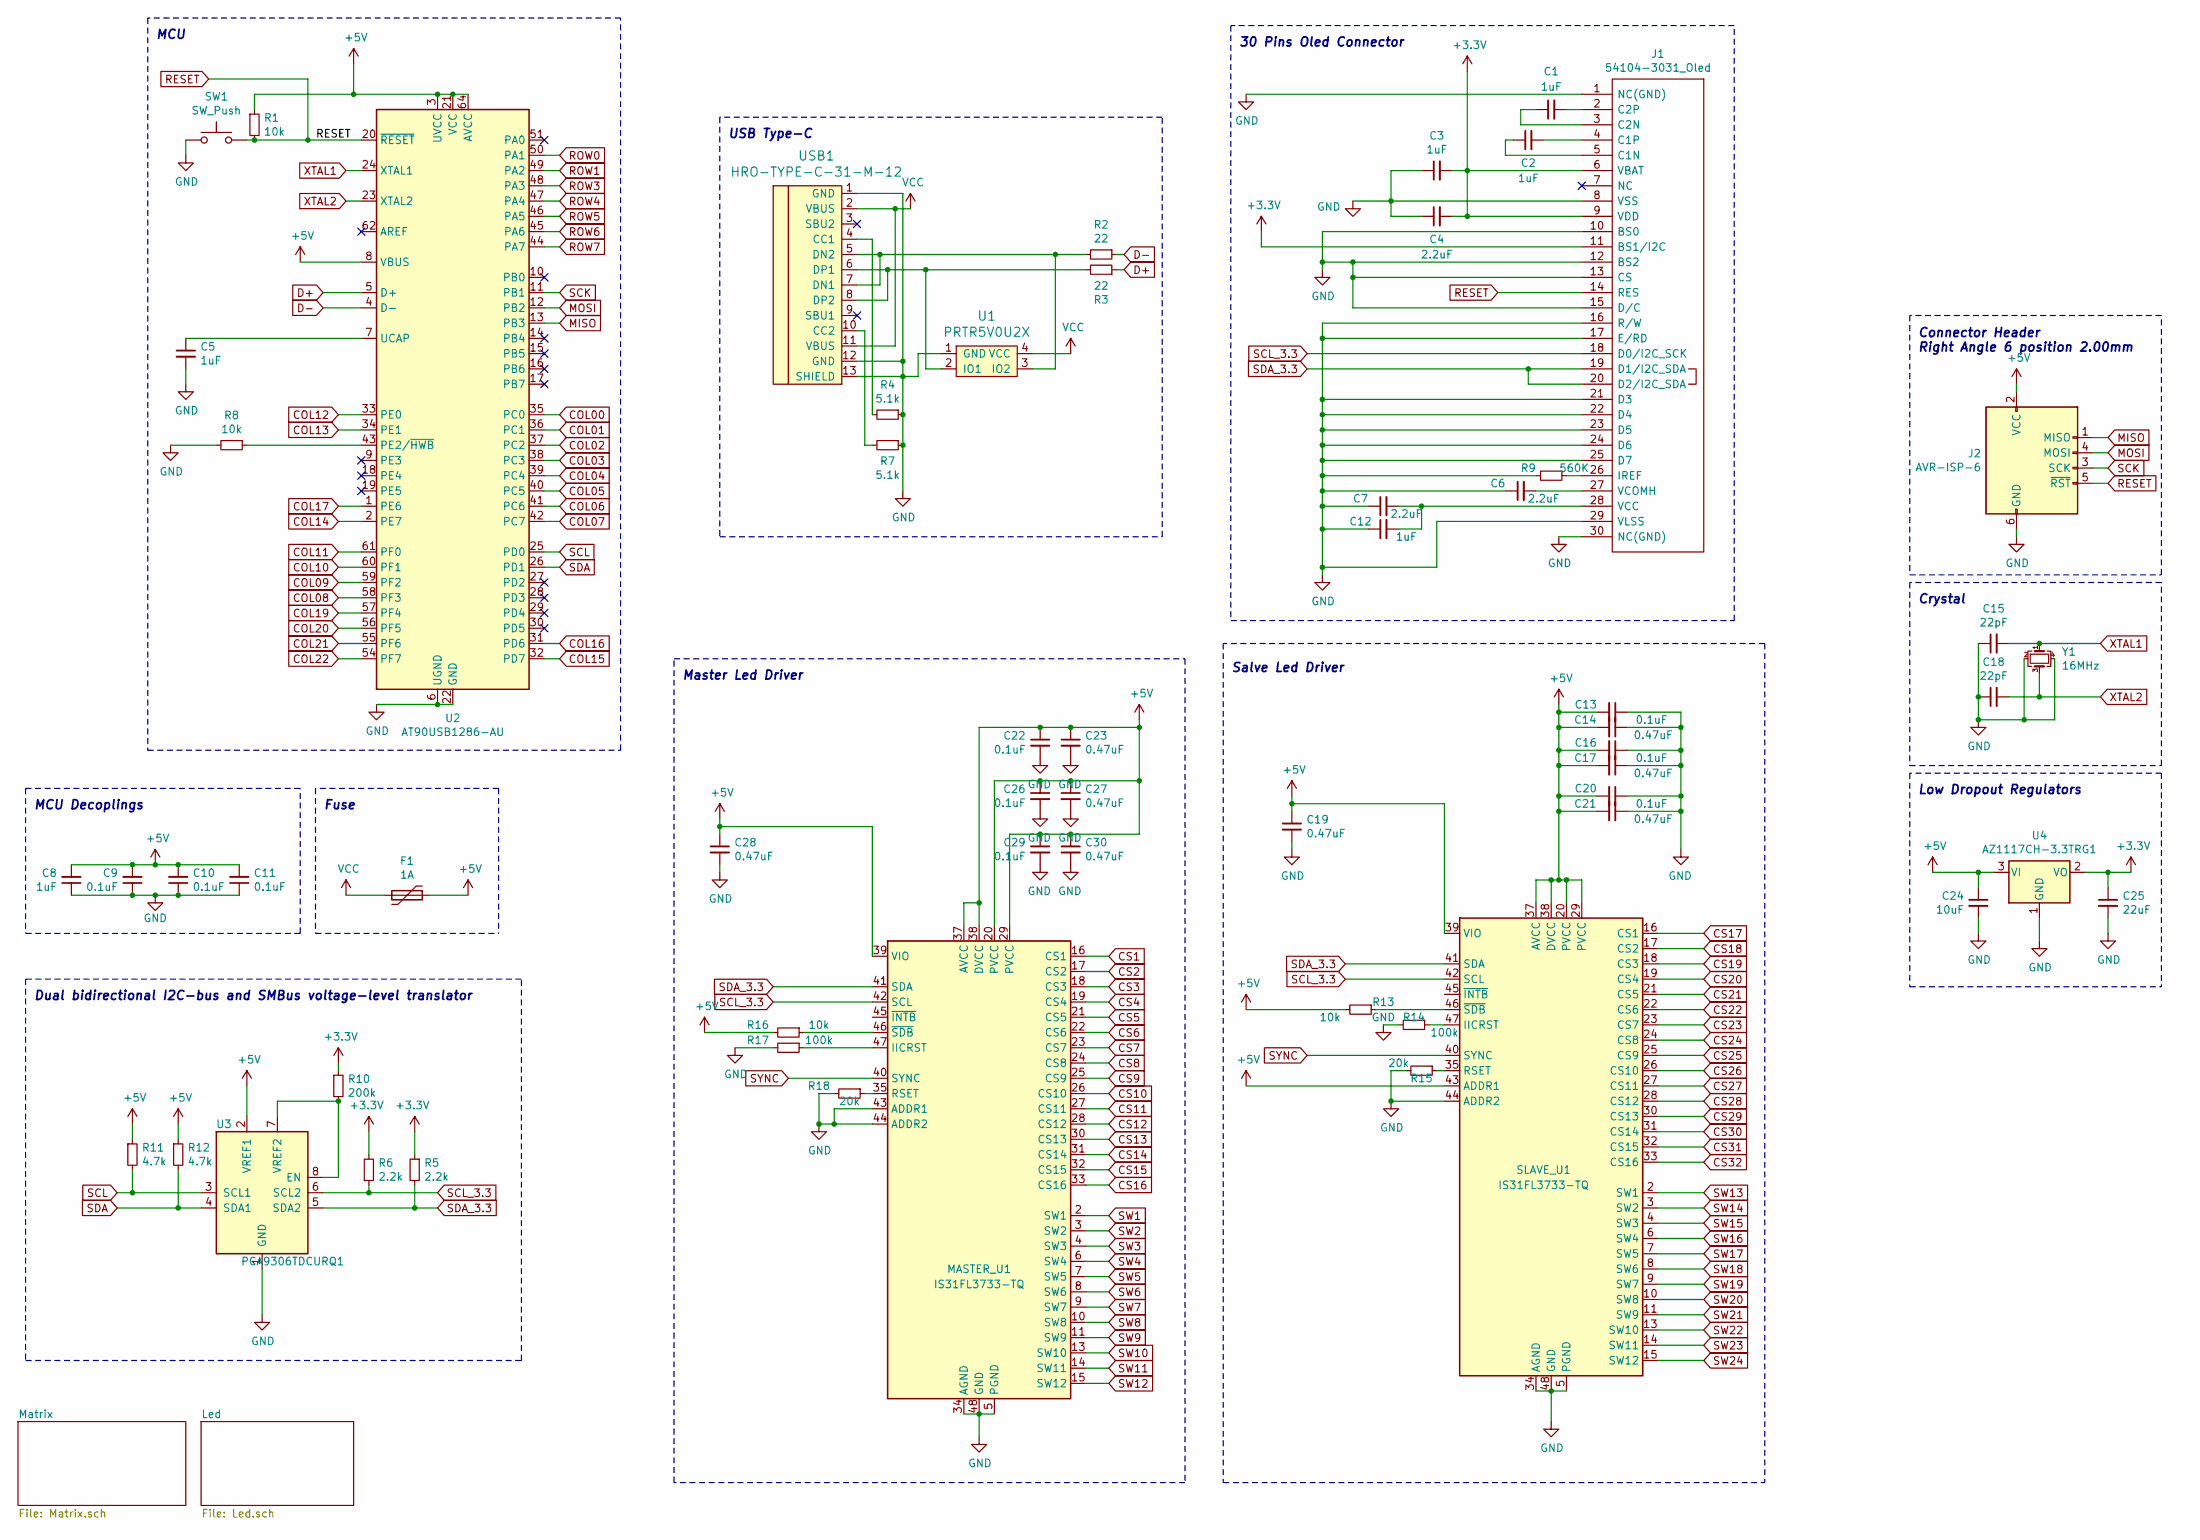
[picture p30: schematic TooManyKeys.sch]

Parts:
C1, C2, C3, C5, C8, C12: 1uF; C_0805_2012Metric
C4, C6, C7: 2.2uF; C_0805_2012Metric
C9, C10, C11, C13, C16, C20, C22, C26, C29: 0.1uF; C_0805_2012Metric
C14, C17, C19, C21, C23, C27, C28, C30: 0.47uF; C_0805_2012Metric
C15, C18: 22pF; C_0805_2012Metric
C24: 10uF; C_0805_2012Metric
C25: 22uF; C_0805_2012Metric
F1: 1A; Fuse_1206_3216Metric
J1: 54104-3031_Oled; 0541043033; Mouser Part Number 538-505110-3091
J2: AVR-ISP-6; SWR204NRTND03STGA
MASTER_U1: IS31FL3733-TQ; QFP50P900X900X120-49N
R1, R8, R13, R16: 10k; R_0805_2012Metric
R2, R3: 22; R_0805_2012Metric
R4, R7: 5.1k; R_0805_2012Metric
R5, R6: 2.2k; R_0805_2012Metric
R9: 560K; R_0805_2012Metric
R10: 200k; R_0805_2012Metric
R11, R12: 4.7k; R_0805_2012Metric
R14, R17: 100k; R_0805_2012Metric
R15, R18: 20k; R_0805_2012Metric
SLAVE_U1: IS31FL3733-TQ; QFP50P900X900X120-49N
SW1: SW_Push; SKQG-1155865
U1: PRTR5V0U2X; SOT143B
U2: AT90USB1286-AU; QFP80P1600X1600X120-64N
U3: PCA9306TDCURQ1; SOP50P310X90-8N
U4: AZ1117CH-3.3TRG1; SOT-223-3_TabPin2
USB1: HRO-TYPE-C-31-M-12
Y1: 16MHz; Crystal_SMD_3225-4Pin_3.2x2.5mm

Connections:
+3V3: C3.2, C4.2, C25.1, J1.6 (VBAT), J1.9 (VDD), J1.11 (BS1/I2C), R5.1, R6.2, R10.1, U4.2 (VO)
+5V: C8.2, C9.2, C10.2, C11.2, C13.2, C14.2, C16.2, C17.2, C19.1, C20.2, C21.2, C22.1, C23.1, C24.1, C26.1, C27.1, C28.1, C29.1, C30.1, F1.1, J2.2 (VCC), MASTER_U1.20 (PVCC), MASTER_U1.29 (PVCC), MASTER_U1.37 (AVCC), MASTER_U1.38 (DVCC), MASTER_U1.39 (VIO), R1.1, R11.1, R12.1, R13.2, R16.2, SLAVE_U1.20 (PVCC), SLAVE_U1.29 (PVCC), SLAVE_U1.37 (AVCC), SLAVE_U1.38 (DVCC), SLAVE_U1.39 (VIO), SLAVE_U1.43 (ADDR1), U2.3 (UVCC), U2.8 (VBUS), U2.21 (VCC), U2.52 (VCC), U2.64 (AVCC), U3.2 (VREF1), U4.3 (VI)
COL00: U2.35 (PC0); also elsewhere on the board
COL01: U2.36 (PC1); also elsewhere on the board
COL02: U2.37 (PC2); also elsewhere on the board
COL03: U2.38 (PC3); also elsewhere on the board
COL04: U2.39 (PC4); also elsewhere on the board
COL05: U2.40 (PC5); also elsewhere on the board
COL06: U2.41 (PC6); also elsewhere on the board
COL07: U2.42 (PC7); also elsewhere on the board
COL08: U2.58 (PF3); also elsewhere on the board
COL09: U2.59 (PF2); also elsewhere on the board
COL10: U2.60 (PF1); also elsewhere on the board
COL11: U2.61 (PF0); also elsewhere on the board
COL12: U2.33 (PE0); also elsewhere on the board
COL13: U2.34 (PE1); also elsewhere on the board
COL14: U2.2 (PE7); also elsewhere on the board
COL15: U2.32 (PD7); also elsewhere on the board
COL16: U2.31 (PD6); also elsewhere on the board
COL17: U2.1 (PE6); also elsewhere on the board
COL19: U2.57 (PF4); also elsewhere on the board
COL20: U2.56 (PF5); also elsewhere on the board
COL21: U2.55 (PF6); also elsewhere on the board
COL22: U2.54 (PF7); also elsewhere on the board
CS1: MASTER_U1.16 (CS1); also elsewhere on the board
CS2: MASTER_U1.17 (CS2); also elsewhere on the board
CS3: MASTER_U1.18 (CS3); also elsewhere on the board
CS4: MASTER_U1.19 (CS4); also elsewhere on the board
CS5: MASTER_U1.21 (CS5); also elsewhere on the board
CS6: MASTER_U1.22 (CS6); also elsewhere on the board
CS7: MASTER_U1.23 (CS7); also elsewhere on the board
CS8: MASTER_U1.24 (CS8); also elsewhere on the board
CS9: MASTER_U1.25 (CS9); also elsewhere on the board
CS10: MASTER_U1.26 (CS10); also elsewhere on the board
CS11: MASTER_U1.27 (CS11); also elsewhere on the board
CS12: MASTER_U1.28 (CS12); also elsewhere on the board
CS13: MASTER_U1.30 (CS13); also elsewhere on the board
CS14: MASTER_U1.31 (CS14); also elsewhere on the board
CS15: MASTER_U1.32 (CS15); also elsewhere on the board
CS16: MASTER_U1.33 (CS16); also elsewhere on the board
CS17: SLAVE_U1.16 (CS1); also elsewhere on the board
CS18: SLAVE_U1.17 (CS2); also elsewhere on the board
CS19: SLAVE_U1.18 (CS3); also elsewhere on the board
CS20: SLAVE_U1.19 (CS4); also elsewhere on the board
CS21: SLAVE_U1.21 (CS5); also elsewhere on the board
CS22: SLAVE_U1.22 (CS6); also elsewhere on the board
CS23: SLAVE_U1.23 (CS7); also elsewhere on the board
CS24: SLAVE_U1.24 (CS8); also elsewhere on the board
CS25: SLAVE_U1.25 (CS9); also elsewhere on the board
CS26: SLAVE_U1.26 (CS10); also elsewhere on the board
CS27: SLAVE_U1.27 (CS11); also elsewhere on the board
CS28: SLAVE_U1.28 (CS12); also elsewhere on the board
CS29: SLAVE_U1.30 (CS13); also elsewhere on the board
CS30: SLAVE_U1.31 (CS14); also elsewhere on the board
CS31: SLAVE_U1.32 (CS15); also elsewhere on the board
CS32: SLAVE_U1.33 (CS16); also elsewhere on the board
D+: R3.1, U2.5 (D+)
D-: R2.1, U2.4 (D-)
GND: C3.1, C4.1, C5.2, C6.1, C7.1, C8.1, C9.1, C10.1, C11.1, C12.1, C13.1, C14.1, C15.1, C16.1, C17.1, C18.1, C19.2, C20.1, C21.1, C22.2, C23.2, C24.2, C25.2, C26.2, C27.2, C28.2, C29.2, C30.2, J1.1 (NC(GND)), J1.8 (VSS), J1.10 (BS0), J1.12 (BS2), J1.13 (CS), J1.15 (D/C), J1.16 (R/W), J1.17 (E/RD), J1.21 (D3), J1.22 (D4), J1.23 (D5), J1.24 (D6), J1.25 (D7), J1.29 (VLSS), J1.30 (NC(GND)), J2.6 (GND), MASTER_U1.5 (PGND), MASTER_U1.12 (PGND), MASTER_U1.34 (AGND), MASTER_U1.43 (ADDR1), MASTER_U1.44 (ADDR2), MASTER_U1.48 (GND), MASTER_U1.49 (GND), R4.1, R7.1, R8.2, R9.2, R14.2, R15.2, R17.2, R18.2, SLAVE_U1.5 (PGND), SLAVE_U1.12 (PGND), SLAVE_U1.34 (AGND), SLAVE_U1.44 (ADDR2), SLAVE_U1.48 (GND), SLAVE_U1.49 (GND), SW1.1, U1.1 (GND), U2.6 (UGND), U2.22 (GND), U2.53 (GND), U2.63 (GND), U3.1 (GND), U4.1 (GND), USB1.1 (GND), USB1.12 (GND), USB1.13 (SHIELD), Y1.2, Y1.4
MISO: J2.1 (MISO), U2.13 (PB3)
MOSI: J2.4 (MOSI), U2.12 (PB2)
unnamed: C1.1, J1.3 (C2N)
unnamed: C1.2, J1.2 (C2P)
unnamed: C2.1, J1.5 (C1N)
unnamed: C2.2, J1.4 (C1P)
unnamed: C5.1, U2.7 (UCAP)
unnamed: C6.2, J1.27 (VCOMH)
unnamed: C7.2, C12.2, J1.28 (VCC)
unnamed: J1.26 (IREF), R9.1
unnamed: MASTER_U1.35 (RSET), R18.1
unnamed: MASTER_U1.46 (~SDB), R16.1
unnamed: MASTER_U1.47 (IICRST), R17.1
unnamed: R2.2, U1.3 (IO2), USB1.5 (DN2), USB1.7 (DN1)
unnamed: R3.2, U1.2 (IO1), USB1.6 (DP1), USB1.8 (DP2)
unnamed: R4.2, USB1.4 (CC1)
unnamed: R7.2, USB1.10 (CC2)
unnamed: R8.1, U2.43 (PE2/~HWB)
unnamed: R10.2, U3.7 (VREF2), U3.8 (EN)
unnamed: R13.1, SLAVE_U1.46 (~SDB)
unnamed: R14.1, SLAVE_U1.47 (IICRST)
unnamed: R15.1, SLAVE_U1.35 (RSET)
RESET: J1.14 (RES), J2.5 (~RST), R1.2, SW1.2, U2.20 (~RESET)
ROW0: U2.50 (PA1); also elsewhere on the board
ROW1: U2.49 (PA2); also elsewhere on the board
ROW3: U2.48 (PA3); also elsewhere on the board
ROW4: U2.47 (PA4); also elsewhere on the board
ROW5: U2.46 (PA5); also elsewhere on the board
ROW6: U2.45 (PA6); also elsewhere on the board
ROW7: U2.44 (PA7); also elsewhere on the board
SCK: J2.3 (SCK), U2.11 (PB1)
SCL: R11.2, U2.25 (PD0), U3.3 (SCL1)
SCL_3.3: J1.18 (D0/I2C_SCK), MASTER_U1.42 (SCL), R6.1, SLAVE_U1.42 (SCL), U3.6 (SCL2)
SDA: R12.2, U2.26 (PD1), U3.4 (SDA1)
SDA_3.3: J1.19 (D1/I2C_SDA), J1.20 (D2/I2C_SDA), MASTER_U1.41 (SDA), R5.2, SLAVE_U1.41 (SDA), U3.5 (SDA2)
SW1: MASTER_U1.2 (SW1); also elsewhere on the board
SW2: MASTER_U1.3 (SW2); also elsewhere on the board
SW3: MASTER_U1.4 (SW3); also elsewhere on the board
SW4: MASTER_U1.6 (SW4); also elsewhere on the board
SW5: MASTER_U1.7 (SW5); also elsewhere on the board
SW6: MASTER_U1.8 (SW6); also elsewhere on the board
SW7: MASTER_U1.9 (SW7); also elsewhere on the board
SW8: MASTER_U1.10 (SW8); also elsewhere on the board
SW9: MASTER_U1.11 (SW9); also elsewhere on the board
SW10: MASTER_U1.13 (SW10); also elsewhere on the board
SW11: MASTER_U1.14 (SW11); also elsewhere on the board
SW12: MASTER_U1.15 (SW12); also elsewhere on the board
SW13: SLAVE_U1.2 (SW1); also elsewhere on the board
SW14: SLAVE_U1.3 (SW2); also elsewhere on the board
SW15: SLAVE_U1.4 (SW3); also elsewhere on the board
SW16: SLAVE_U1.6 (SW4); also elsewhere on the board
SW17: SLAVE_U1.7 (SW5); also elsewhere on the board
SW18: SLAVE_U1.8 (SW6); also elsewhere on the board
SW19: SLAVE_U1.9 (SW7); also elsewhere on the board
SW20: SLAVE_U1.10 (SW8); also elsewhere on the board
SW21: SLAVE_U1.11 (SW9); also elsewhere on the board
SW22: SLAVE_U1.13 (SW10); also elsewhere on the board
SW23: SLAVE_U1.14 (SW11); also elsewhere on the board
SW24: SLAVE_U1.15 (SW12); also elsewhere on the board
SYNC: MASTER_U1.40 (SYNC), SLAVE_U1.40 (SYNC)
VCC: F1.2, U1.4 (VCC), USB1.2 (VBUS), USB1.11 (VBUS)
XTAL1: C15.2, U2.24 (XTAL1), Y1.1
XTAL2: C18.2, U2.23 (XTAL2), Y1.3

Notes on the sheet:
Dual bidirectional I2C-bus and SMBus voltage-level translator
Low Dropout Regulators
Crystal
MCU Decoplings
Fuse
Connector Header Right Angle 6 position 2.00mm
Master Led Driver
Salve Led Driver
30 Pins Oled Connector
USB Type-C
MCU
