pesantsi/CustomPcbs/TooManyKeys/KiCad/TooManyKeys.kicad_pcb

## KiCad design TooManyKeys/KiCad/TooManyKeys.kicad_pcb (continued)

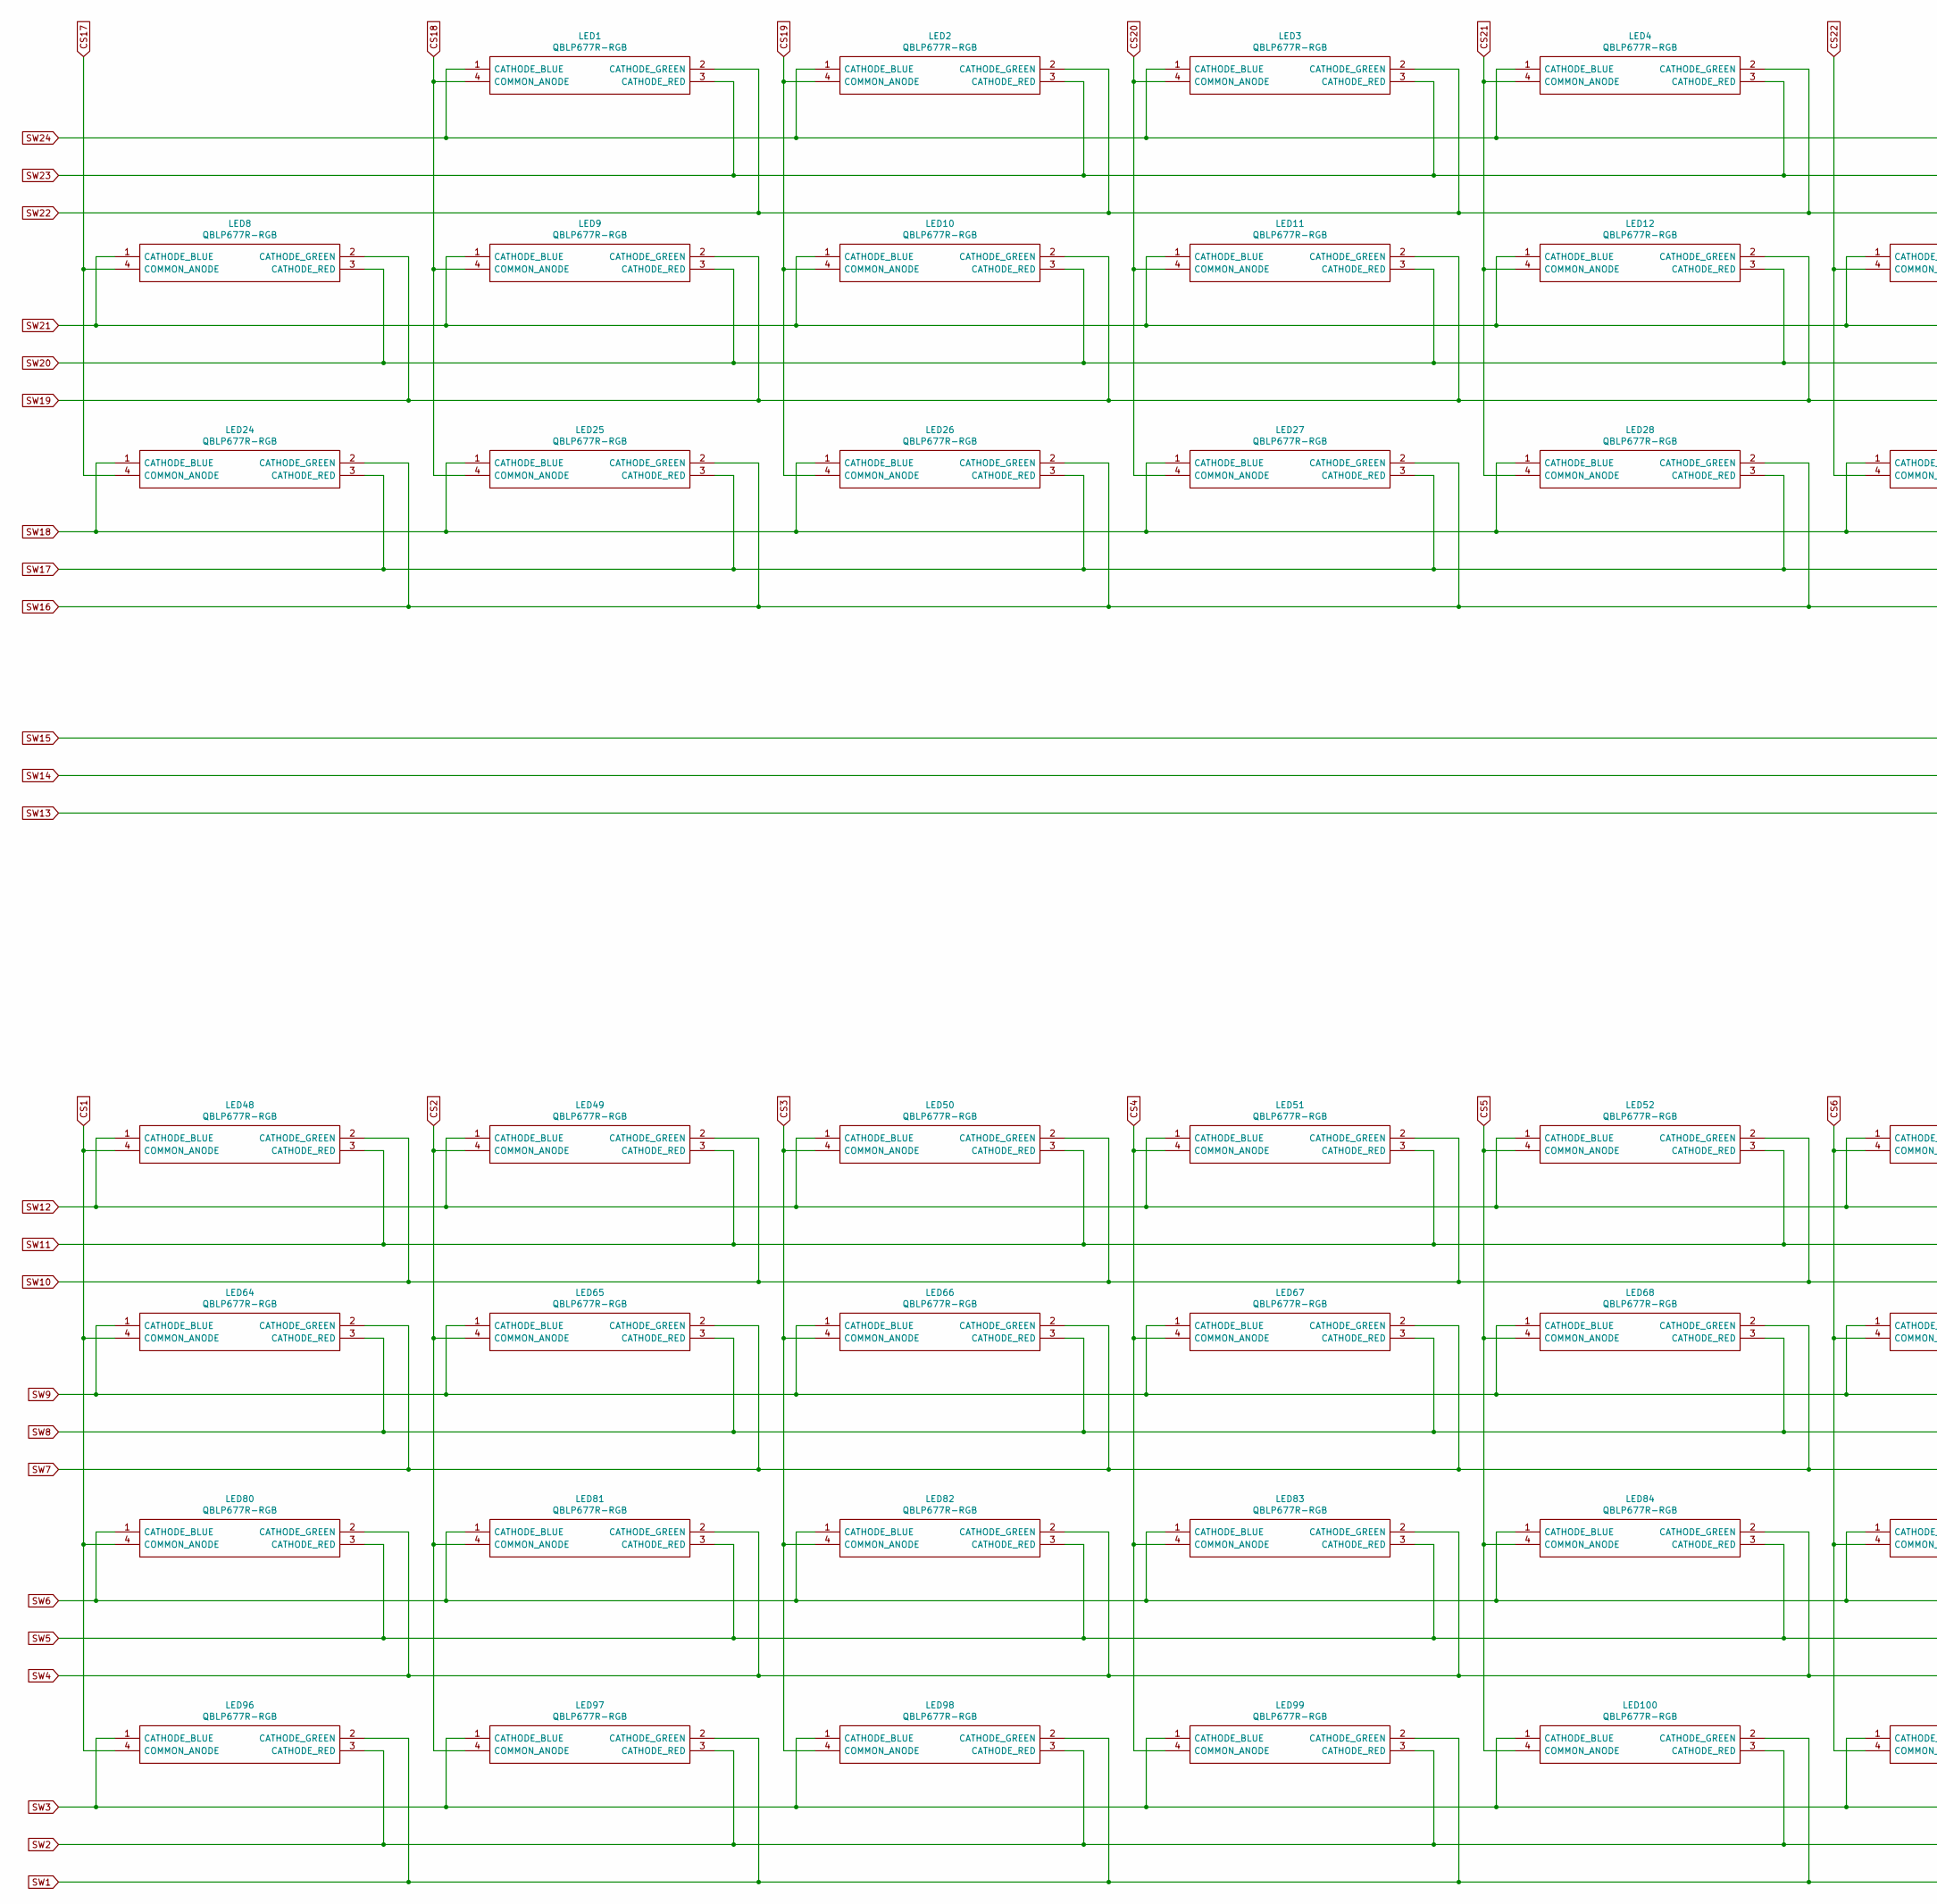
[picture p31: schematic Led.sch, part in row 1, column 1]

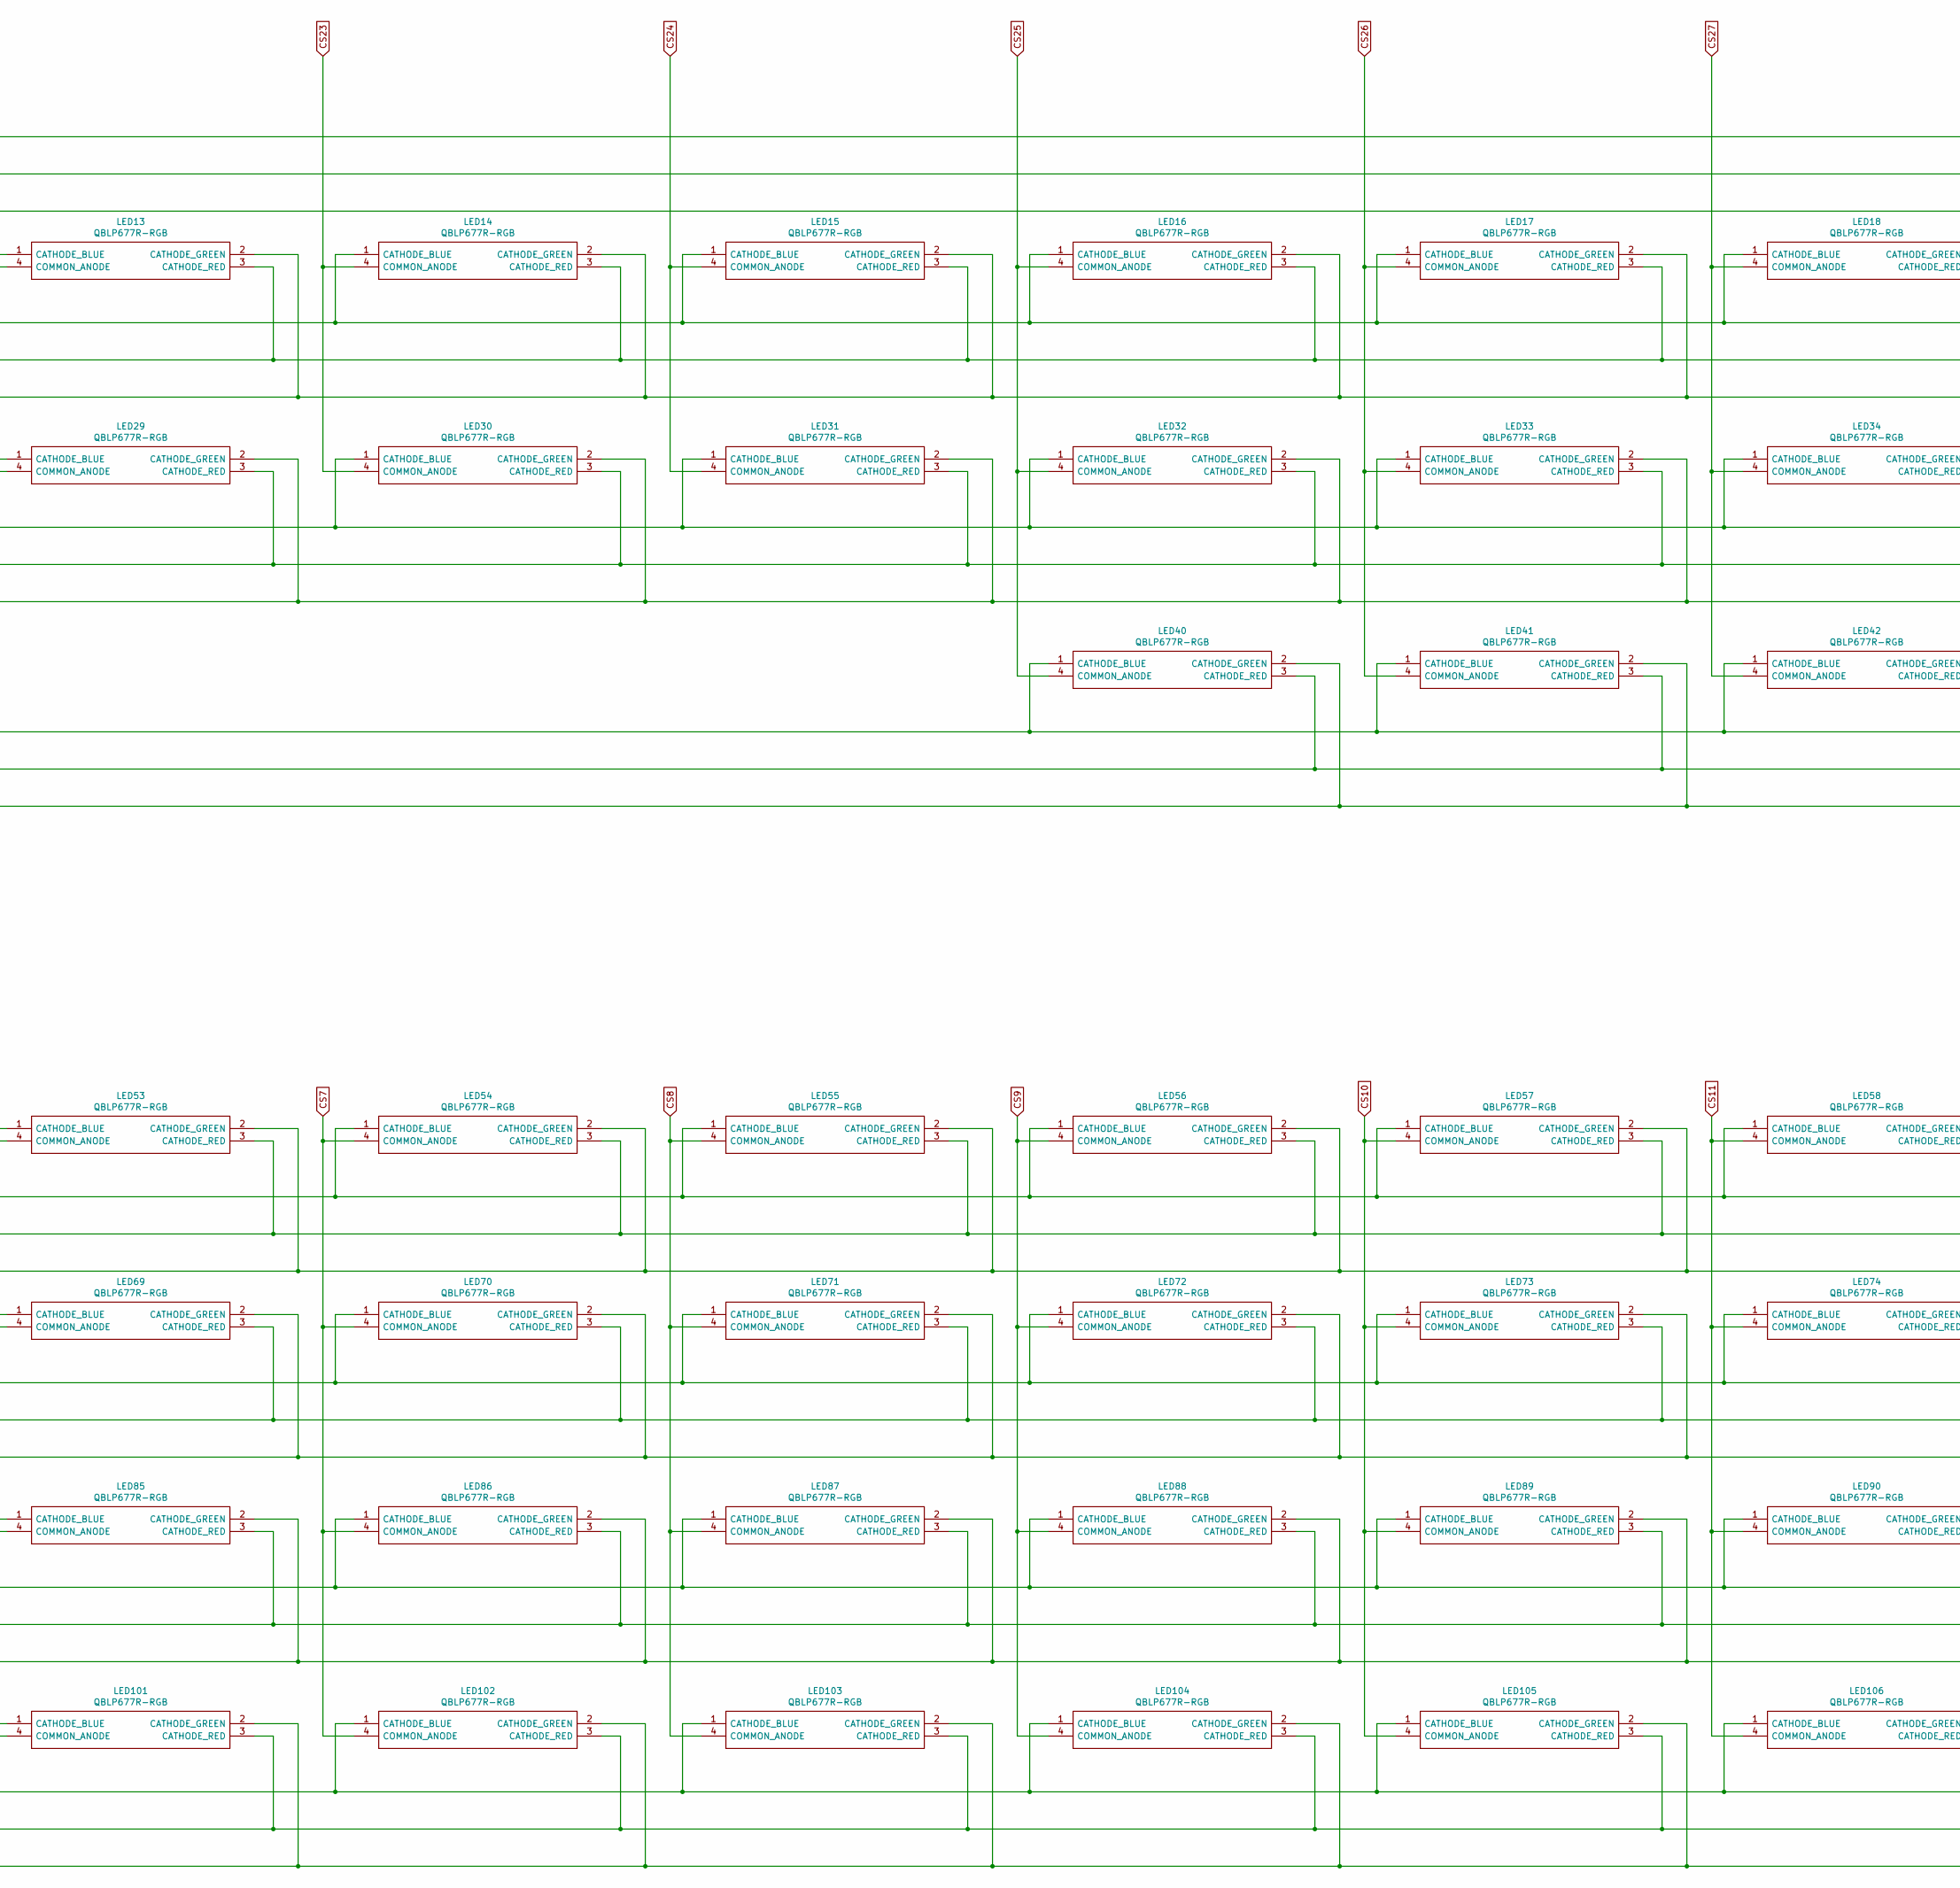
[picture p32: schematic Led.sch, part in row 1, column 2]

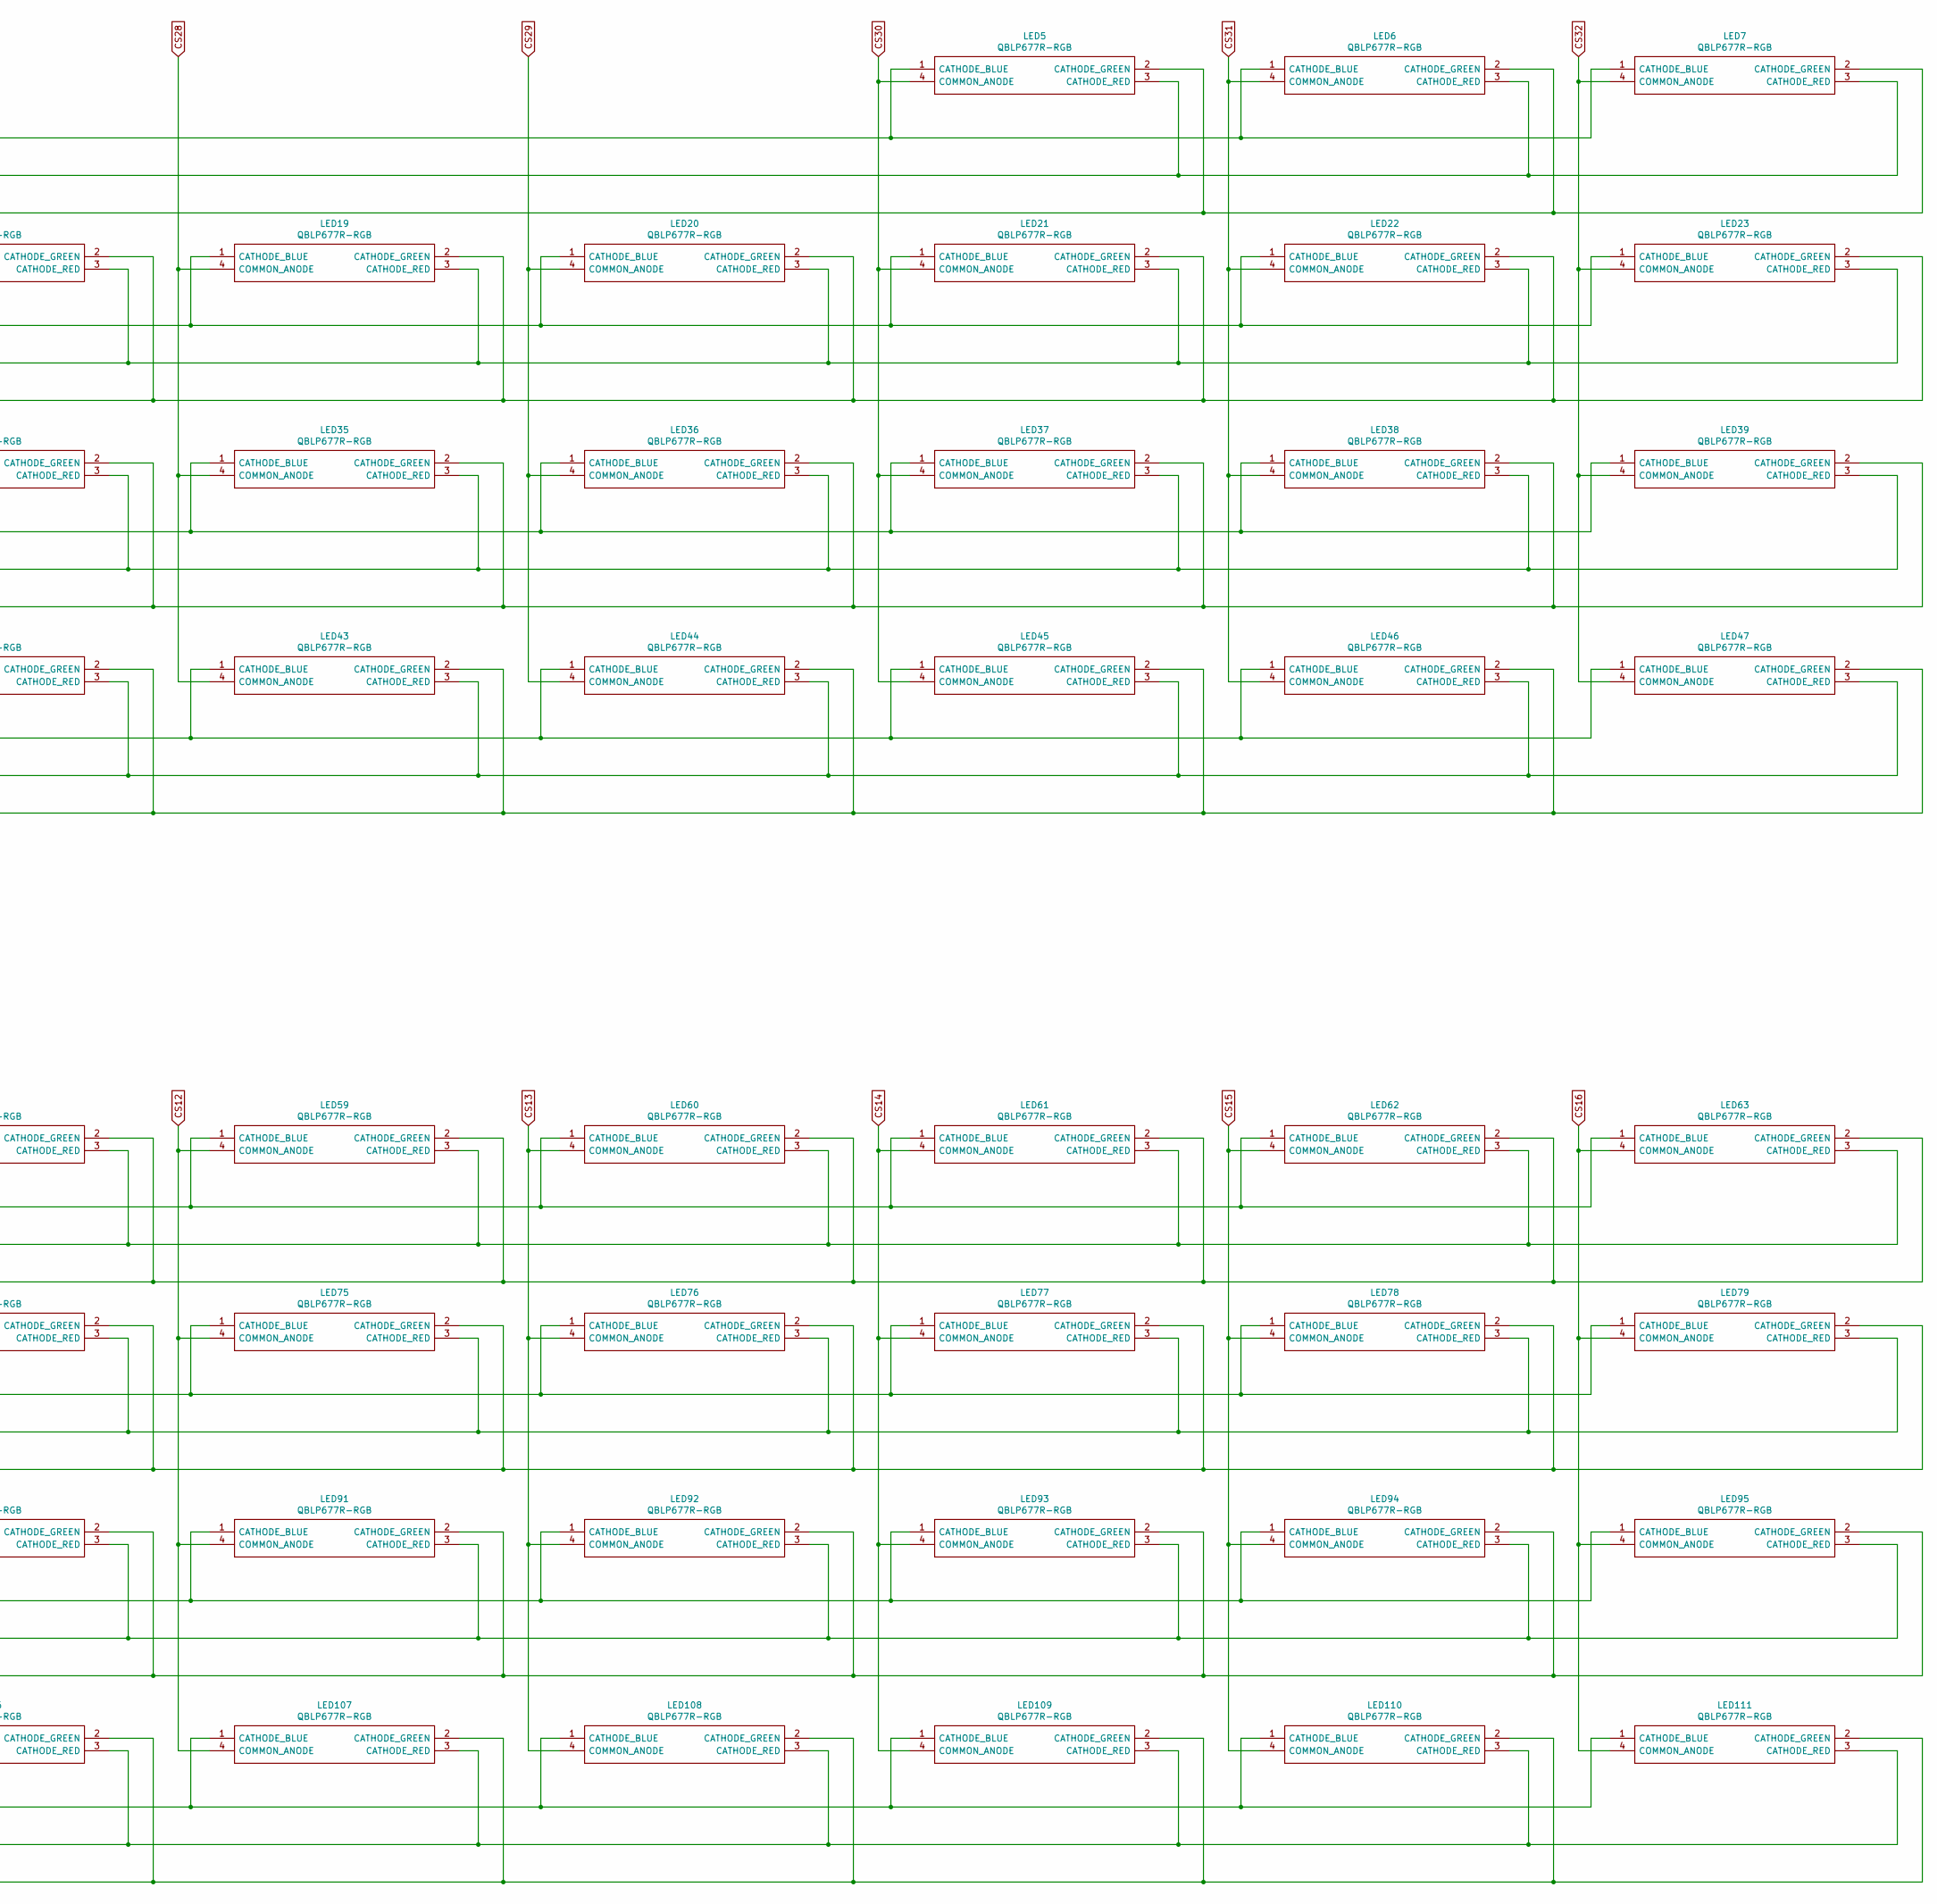
[picture p33: schematic Led.sch, part in row 1, column 3]

Parts:
LED1, LED2, LED3, LED4, LED5, LED6, LED7, LED8, LED9, LED10, LED11, LED12, LED13, LED14, LED15, LED16, LED17, LED18, LED19, LED20, LED21, LED22, LED23, LED24, LED25, LED26, LED27, LED28, LED29, LED30, LED31, LED32, LED33, LED34, LED35, LED36, LED37, LED38, LED39, LED40, LED41, LED42, LED43, LED44, LED45, LED46, LED47, LED48, LED49, LED50, LED51, LED52, LED53, LED54, LED55, LED56, LED57, LED58, LED59, LED60, LED61, LED62, LED63, LED64, LED65, LED66, LED67, LED68, LED69, LED70, LED71, LED72, LED73, LED74, LED75, LED76, LED77, LED78, LED79, LED80, LED81, LED82, LED83, LED84, LED85, LED86, LED87, LED88, LED89, LED90, LED91, LED92, LED93, LED94, LED95, LED96, LED97, LED98, LED99, LED100, LED101, LED102, LED103, LED104, LED105, LED106, LED107, LED108, LED109, LED110, LED111: QBLP677R-RGB; Manufacturer_Part_Number QBLP677R-RGB

Connections:
CS1: LED48.4 (COMMON_ANODE), LED64.4 (COMMON_ANODE), LED80.4 (COMMON_ANODE), LED96.4 (COMMON_ANODE); also elsewhere on the board
CS2: LED49.4 (COMMON_ANODE), LED65.4 (COMMON_ANODE), LED81.4 (COMMON_ANODE), LED97.4 (COMMON_ANODE); also elsewhere on the board
CS3: LED50.4 (COMMON_ANODE), LED66.4 (COMMON_ANODE), LED82.4 (COMMON_ANODE), LED98.4 (COMMON_ANODE); also elsewhere on the board
CS4: LED51.4 (COMMON_ANODE), LED67.4 (COMMON_ANODE), LED83.4 (COMMON_ANODE), LED99.4 (COMMON_ANODE); also elsewhere on the board
CS5: LED52.4 (COMMON_ANODE), LED68.4 (COMMON_ANODE), LED84.4 (COMMON_ANODE), LED100.4 (COMMON_ANODE); also elsewhere on the board
CS6: LED53.4 (COMMON_ANODE), LED69.4 (COMMON_ANODE), LED85.4 (COMMON_ANODE), LED101.4 (COMMON_ANODE); also elsewhere on the board
CS7: LED54.4 (COMMON_ANODE), LED70.4 (COMMON_ANODE), LED86.4 (COMMON_ANODE), LED102.4 (COMMON_ANODE); also elsewhere on the board
CS8: LED55.4 (COMMON_ANODE), LED71.4 (COMMON_ANODE), LED87.4 (COMMON_ANODE), LED103.4 (COMMON_ANODE); also elsewhere on the board
CS9: LED56.4 (COMMON_ANODE), LED72.4 (COMMON_ANODE), LED88.4 (COMMON_ANODE), LED104.4 (COMMON_ANODE); also elsewhere on the board
CS10: LED57.4 (COMMON_ANODE), LED73.4 (COMMON_ANODE), LED89.4 (COMMON_ANODE), LED105.4 (COMMON_ANODE); also elsewhere on the board
CS11: LED58.4 (COMMON_ANODE), LED74.4 (COMMON_ANODE), LED90.4 (COMMON_ANODE), LED106.4 (COMMON_ANODE); also elsewhere on the board
CS12: LED59.4 (COMMON_ANODE), LED75.4 (COMMON_ANODE), LED91.4 (COMMON_ANODE), LED107.4 (COMMON_ANODE); also elsewhere on the board
CS13: LED60.4 (COMMON_ANODE), LED76.4 (COMMON_ANODE), LED92.4 (COMMON_ANODE), LED108.4 (COMMON_ANODE); also elsewhere on the board
CS14: LED61.4 (COMMON_ANODE), LED77.4 (COMMON_ANODE), LED93.4 (COMMON_ANODE), LED109.4 (COMMON_ANODE); also elsewhere on the board
CS15: LED62.4 (COMMON_ANODE), LED78.4 (COMMON_ANODE), LED94.4 (COMMON_ANODE), LED110.4 (COMMON_ANODE); also elsewhere on the board
CS16: LED63.4 (COMMON_ANODE), LED79.4 (COMMON_ANODE), LED95.4 (COMMON_ANODE), LED111.4 (COMMON_ANODE); also elsewhere on the board
CS17: LED8.4 (COMMON_ANODE), LED24.4 (COMMON_ANODE); also elsewhere on the board
CS18: LED1.4 (COMMON_ANODE), LED9.4 (COMMON_ANODE), LED25.4 (COMMON_ANODE); also elsewhere on the board
CS19: LED2.4 (COMMON_ANODE), LED10.4 (COMMON_ANODE), LED26.4 (COMMON_ANODE); also elsewhere on the board
CS20: LED3.4 (COMMON_ANODE), LED11.4 (COMMON_ANODE), LED27.4 (COMMON_ANODE); also elsewhere on the board
CS21: LED4.4 (COMMON_ANODE), LED12.4 (COMMON_ANODE), LED28.4 (COMMON_ANODE); also elsewhere on the board
CS22: LED13.4 (COMMON_ANODE), LED29.4 (COMMON_ANODE); also elsewhere on the board
CS23: LED14.4 (COMMON_ANODE), LED30.4 (COMMON_ANODE); also elsewhere on the board
CS24: LED15.4 (COMMON_ANODE), LED31.4 (COMMON_ANODE); also elsewhere on the board
CS25: LED16.4 (COMMON_ANODE), LED32.4 (COMMON_ANODE), LED40.4 (COMMON_ANODE); also elsewhere on the board
CS26: LED17.4 (COMMON_ANODE), LED33.4 (COMMON_ANODE), LED41.4 (COMMON_ANODE); also elsewhere on the board
CS27: LED18.4 (COMMON_ANODE), LED34.4 (COMMON_ANODE), LED42.4 (COMMON_ANODE); also elsewhere on the board
CS28: LED19.4 (COMMON_ANODE), LED35.4 (COMMON_ANODE), LED43.4 (COMMON_ANODE); also elsewhere on the board
CS29: LED20.4 (COMMON_ANODE), LED36.4 (COMMON_ANODE), LED44.4 (COMMON_ANODE); also elsewhere on the board
CS30: LED5.4 (COMMON_ANODE), LED21.4 (COMMON_ANODE), LED37.4 (COMMON_ANODE), LED45.4 (COMMON_ANODE); also elsewhere on the board
CS31: LED6.4 (COMMON_ANODE), LED22.4 (COMMON_ANODE), LED38.4 (COMMON_ANODE), LED46.4 (COMMON_ANODE); also elsewhere on the board
CS32: LED7.4 (COMMON_ANODE), LED23.4 (COMMON_ANODE), LED39.4 (COMMON_ANODE), LED47.4 (COMMON_ANODE); also elsewhere on the board
SW1: LED96.2 (CATHODE_GREEN), LED97.2 (CATHODE_GREEN), LED98.2 (CATHODE_GREEN), LED99.2 (CATHODE_GREEN), LED100.2 (CATHODE_GREEN), LED101.2 (CATHODE_GREEN), LED102.2 (CATHODE_GREEN), LED103.2 (CATHODE_GREEN), LED104.2 (CATHODE_GREEN), LED105.2 (CATHODE_GREEN), LED106.2 (CATHODE_GREEN), LED107.2 (CATHODE_GREEN), LED108.2 (CATHODE_GREEN), LED109.2 (CATHODE_GREEN), LED110.2 (CATHODE_GREEN), LED111.2 (CATHODE_GREEN); also elsewhere on the board
SW2: LED96.3 (CATHODE_RED), LED97.3 (CATHODE_RED), LED98.3 (CATHODE_RED), LED99.3 (CATHODE_RED), LED100.3 (CATHODE_RED), LED101.3 (CATHODE_RED), LED102.3 (CATHODE_RED), LED103.3 (CATHODE_RED), LED104.3 (CATHODE_RED), LED105.3 (CATHODE_RED), LED106.3 (CATHODE_RED), LED107.3 (CATHODE_RED), LED108.3 (CATHODE_RED), LED109.3 (CATHODE_RED), LED110.3 (CATHODE_RED), LED111.3 (CATHODE_RED); also elsewhere on the board
SW3: LED96.1 (CATHODE_BLUE), LED97.1 (CATHODE_BLUE), LED98.1 (CATHODE_BLUE), LED99.1 (CATHODE_BLUE), LED100.1 (CATHODE_BLUE), LED101.1 (CATHODE_BLUE), LED102.1 (CATHODE_BLUE), LED103.1 (CATHODE_BLUE), LED104.1 (CATHODE_BLUE), LED105.1 (CATHODE_BLUE), LED106.1 (CATHODE_BLUE), LED107.1 (CATHODE_BLUE), LED108.1 (CATHODE_BLUE), LED109.1 (CATHODE_BLUE), LED110.1 (CATHODE_BLUE), LED111.1 (CATHODE_BLUE); also elsewhere on the board
SW4: LED80.2 (CATHODE_GREEN), LED81.2 (CATHODE_GREEN), LED82.2 (CATHODE_GREEN), LED83.2 (CATHODE_GREEN), LED84.2 (CATHODE_GREEN), LED85.2 (CATHODE_GREEN), LED86.2 (CATHODE_GREEN), LED87.2 (CATHODE_GREEN), LED88.2 (CATHODE_GREEN), LED89.2 (CATHODE_GREEN), LED90.2 (CATHODE_GREEN), LED91.2 (CATHODE_GREEN), LED92.2 (CATHODE_GREEN), LED93.2 (CATHODE_GREEN), LED94.2 (CATHODE_GREEN), LED95.2 (CATHODE_GREEN); also elsewhere on the board
SW5: LED80.3 (CATHODE_RED), LED81.3 (CATHODE_RED), LED82.3 (CATHODE_RED), LED83.3 (CATHODE_RED), LED84.3 (CATHODE_RED), LED85.3 (CATHODE_RED), LED86.3 (CATHODE_RED), LED87.3 (CATHODE_RED), LED88.3 (CATHODE_RED), LED89.3 (CATHODE_RED), LED90.3 (CATHODE_RED), LED91.3 (CATHODE_RED), LED92.3 (CATHODE_RED), LED93.3 (CATHODE_RED), LED94.3 (CATHODE_RED), LED95.3 (CATHODE_RED); also elsewhere on the board
SW6: LED80.1 (CATHODE_BLUE), LED81.1 (CATHODE_BLUE), LED82.1 (CATHODE_BLUE), LED83.1 (CATHODE_BLUE), LED84.1 (CATHODE_BLUE), LED85.1 (CATHODE_BLUE), LED86.1 (CATHODE_BLUE), LED87.1 (CATHODE_BLUE), LED88.1 (CATHODE_BLUE), LED89.1 (CATHODE_BLUE), LED90.1 (CATHODE_BLUE), LED91.1 (CATHODE_BLUE), LED92.1 (CATHODE_BLUE), LED93.1 (CATHODE_BLUE), LED94.1 (CATHODE_BLUE), LED95.1 (CATHODE_BLUE); also elsewhere on the board
SW7: LED64.2 (CATHODE_GREEN), LED65.2 (CATHODE_GREEN), LED66.2 (CATHODE_GREEN), LED67.2 (CATHODE_GREEN), LED68.2 (CATHODE_GREEN), LED69.2 (CATHODE_GREEN), LED70.2 (CATHODE_GREEN), LED71.2 (CATHODE_GREEN), LED72.2 (CATHODE_GREEN), LED73.2 (CATHODE_GREEN), LED74.2 (CATHODE_GREEN), LED75.2 (CATHODE_GREEN), LED76.2 (CATHODE_GREEN), LED77.2 (CATHODE_GREEN), LED78.2 (CATHODE_GREEN), LED79.2 (CATHODE_GREEN); also elsewhere on the board
SW8: LED64.3 (CATHODE_RED), LED65.3 (CATHODE_RED), LED66.3 (CATHODE_RED), LED67.3 (CATHODE_RED), LED68.3 (CATHODE_RED), LED69.3 (CATHODE_RED), LED70.3 (CATHODE_RED), LED71.3 (CATHODE_RED), LED72.3 (CATHODE_RED), LED73.3 (CATHODE_RED), LED74.3 (CATHODE_RED), LED75.3 (CATHODE_RED), LED76.3 (CATHODE_RED), LED77.3 (CATHODE_RED), LED78.3 (CATHODE_RED), LED79.3 (CATHODE_RED); also elsewhere on the board
SW9: LED64.1 (CATHODE_BLUE), LED65.1 (CATHODE_BLUE), LED66.1 (CATHODE_BLUE), LED67.1 (CATHODE_BLUE), LED68.1 (CATHODE_BLUE), LED69.1 (CATHODE_BLUE), LED70.1 (CATHODE_BLUE), LED71.1 (CATHODE_BLUE), LED72.1 (CATHODE_BLUE), LED73.1 (CATHODE_BLUE), LED74.1 (CATHODE_BLUE), LED75.1 (CATHODE_BLUE), LED76.1 (CATHODE_BLUE), LED77.1 (CATHODE_BLUE), LED78.1 (CATHODE_BLUE), LED79.1 (CATHODE_BLUE); also elsewhere on the board
SW10: LED48.2 (CATHODE_GREEN), LED49.2 (CATHODE_GREEN), LED50.2 (CATHODE_GREEN), LED51.2 (CATHODE_GREEN), LED52.2 (CATHODE_GREEN), LED53.2 (CATHODE_GREEN), LED54.2 (CATHODE_GREEN), LED55.2 (CATHODE_GREEN), LED56.2 (CATHODE_GREEN), LED57.2 (CATHODE_GREEN), LED58.2 (CATHODE_GREEN), LED59.2 (CATHODE_GREEN), LED60.2 (CATHODE_GREEN), LED61.2 (CATHODE_GREEN), LED62.2 (CATHODE_GREEN), LED63.2 (CATHODE_GREEN); also elsewhere on the board
SW11: LED48.3 (CATHODE_RED), LED49.3 (CATHODE_RED), LED50.3 (CATHODE_RED), LED51.3 (CATHODE_RED), LED52.3 (CATHODE_RED), LED53.3 (CATHODE_RED), LED54.3 (CATHODE_RED), LED55.3 (CATHODE_RED), LED56.3 (CATHODE_RED), LED57.3 (CATHODE_RED), LED58.3 (CATHODE_RED), LED59.3 (CATHODE_RED), LED60.3 (CATHODE_RED), LED61.3 (CATHODE_RED), LED62.3 (CATHODE_RED), LED63.3 (CATHODE_RED); also elsewhere on the board
SW12: LED48.1 (CATHODE_BLUE), LED49.1 (CATHODE_BLUE), LED50.1 (CATHODE_BLUE), LED51.1 (CATHODE_BLUE), LED52.1 (CATHODE_BLUE), LED53.1 (CATHODE_BLUE), LED54.1 (CATHODE_BLUE), LED55.1 (CATHODE_BLUE), LED56.1 (CATHODE_BLUE), LED57.1 (CATHODE_BLUE), LED58.1 (CATHODE_BLUE), LED59.1 (CATHODE_BLUE), LED60.1 (CATHODE_BLUE), LED61.1 (CATHODE_BLUE), LED62.1 (CATHODE_BLUE), LED63.1 (CATHODE_BLUE); also elsewhere on the board
SW13: LED40.2 (CATHODE_GREEN), LED41.2 (CATHODE_GREEN), LED42.2 (CATHODE_GREEN), LED43.2 (CATHODE_GREEN), LED44.2 (CATHODE_GREEN), LED45.2 (CATHODE_GREEN), LED46.2 (CATHODE_GREEN), LED47.2 (CATHODE_GREEN); also elsewhere on the board
SW14: LED40.3 (CATHODE_RED), LED41.3 (CATHODE_RED), LED42.3 (CATHODE_RED), LED43.3 (CATHODE_RED), LED44.3 (CATHODE_RED), LED45.3 (CATHODE_RED), LED46.3 (CATHODE_RED), LED47.3 (CATHODE_RED); also elsewhere on the board
SW15: LED40.1 (CATHODE_BLUE), LED41.1 (CATHODE_BLUE), LED42.1 (CATHODE_BLUE), LED43.1 (CATHODE_BLUE), LED44.1 (CATHODE_BLUE), LED45.1 (CATHODE_BLUE), LED46.1 (CATHODE_BLUE), LED47.1 (CATHODE_BLUE); also elsewhere on the board
SW16: LED24.2 (CATHODE_GREEN), LED25.2 (CATHODE_GREEN), LED26.2 (CATHODE_GREEN), LED27.2 (CATHODE_GREEN), LED28.2 (CATHODE_GREEN), LED29.2 (CATHODE_GREEN), LED30.2 (CATHODE_GREEN), LED31.2 (CATHODE_GREEN), LED32.2 (CATHODE_GREEN), LED33.2 (CATHODE_GREEN), LED34.2 (CATHODE_GREEN), LED35.2 (CATHODE_GREEN), LED36.2 (CATHODE_GREEN), LED37.2 (CATHODE_GREEN), LED38.2 (CATHODE_GREEN), LED39.2 (CATHODE_GREEN); also elsewhere on the board
SW17: LED24.3 (CATHODE_RED), LED25.3 (CATHODE_RED), LED26.3 (CATHODE_RED), LED27.3 (CATHODE_RED), LED28.3 (CATHODE_RED), LED29.3 (CATHODE_RED), LED30.3 (CATHODE_RED), LED31.3 (CATHODE_RED), LED32.3 (CATHODE_RED), LED33.3 (CATHODE_RED), LED34.3 (CATHODE_RED), LED35.3 (CATHODE_RED), LED36.3 (CATHODE_RED), LED37.3 (CATHODE_RED), LED38.3 (CATHODE_RED), LED39.3 (CATHODE_RED); also elsewhere on the board
SW18: LED24.1 (CATHODE_BLUE), LED25.1 (CATHODE_BLUE), LED26.1 (CATHODE_BLUE), LED27.1 (CATHODE_BLUE), LED28.1 (CATHODE_BLUE), LED29.1 (CATHODE_BLUE), LED30.1 (CATHODE_BLUE), LED31.1 (CATHODE_BLUE), LED32.1 (CATHODE_BLUE), LED33.1 (CATHODE_BLUE), LED34.1 (CATHODE_BLUE), LED35.1 (CATHODE_BLUE), LED36.1 (CATHODE_BLUE), LED37.1 (CATHODE_BLUE), LED38.1 (CATHODE_BLUE), LED39.1 (CATHODE_BLUE); also elsewhere on the board
SW19: LED8.2 (CATHODE_GREEN), LED9.2 (CATHODE_GREEN), LED10.2 (CATHODE_GREEN), LED11.2 (CATHODE_GREEN), LED12.2 (CATHODE_GREEN), LED13.2 (CATHODE_GREEN), LED14.2 (CATHODE_GREEN), LED15.2 (CATHODE_GREEN), LED16.2 (CATHODE_GREEN), LED17.2 (CATHODE_GREEN), LED18.2 (CATHODE_GREEN), LED19.2 (CATHODE_GREEN), LED20.2 (CATHODE_GREEN), LED21.2 (CATHODE_GREEN), LED22.2 (CATHODE_GREEN), LED23.2 (CATHODE_GREEN); also elsewhere on the board
SW20: LED8.3 (CATHODE_RED), LED9.3 (CATHODE_RED), LED10.3 (CATHODE_RED), LED11.3 (CATHODE_RED), LED12.3 (CATHODE_RED), LED13.3 (CATHODE_RED), LED14.3 (CATHODE_RED), LED15.3 (CATHODE_RED), LED16.3 (CATHODE_RED), LED17.3 (CATHODE_RED), LED18.3 (CATHODE_RED), LED19.3 (CATHODE_RED), LED20.3 (CATHODE_RED), LED21.3 (CATHODE_RED), LED22.3 (CATHODE_RED), LED23.3 (CATHODE_RED); also elsewhere on the board
SW21: LED8.1 (CATHODE_BLUE), LED9.1 (CATHODE_BLUE), LED10.1 (CATHODE_BLUE), LED11.1 (CATHODE_BLUE), LED12.1 (CATHODE_BLUE), LED13.1 (CATHODE_BLUE), LED14.1 (CATHODE_BLUE), LED15.1 (CATHODE_BLUE), LED16.1 (CATHODE_BLUE), LED17.1 (CATHODE_BLUE), LED18.1 (CATHODE_BLUE), LED19.1 (CATHODE_BLUE), LED20.1 (CATHODE_BLUE), LED21.1 (CATHODE_BLUE), LED22.1 (CATHODE_BLUE), LED23.1 (CATHODE_BLUE); also elsewhere on the board
SW22: LED1.2 (CATHODE_GREEN), LED2.2 (CATHODE_GREEN), LED3.2 (CATHODE_GREEN), LED4.2 (CATHODE_GREEN), LED5.2 (CATHODE_GREEN), LED6.2 (CATHODE_GREEN), LED7.2 (CATHODE_GREEN); also elsewhere on the board
SW23: LED1.3 (CATHODE_RED), LED2.3 (CATHODE_RED), LED3.3 (CATHODE_RED), LED4.3 (CATHODE_RED), LED5.3 (CATHODE_RED), LED6.3 (CATHODE_RED), LED7.3 (CATHODE_RED); also elsewhere on the board
SW24: LED1.1 (CATHODE_BLUE), LED2.1 (CATHODE_BLUE), LED3.1 (CATHODE_BLUE), LED4.1 (CATHODE_BLUE), LED5.1 (CATHODE_BLUE), LED6.1 (CATHODE_BLUE), LED7.1 (CATHODE_BLUE); also elsewhere on the board
