pesantsi/CustomPcbs/TooManyKeys/KiCad/TooManyKeys.kicad_pcb

## KiCad design TooManyKeys/KiCad/TooManyKeys.kicad_pcb (continued)

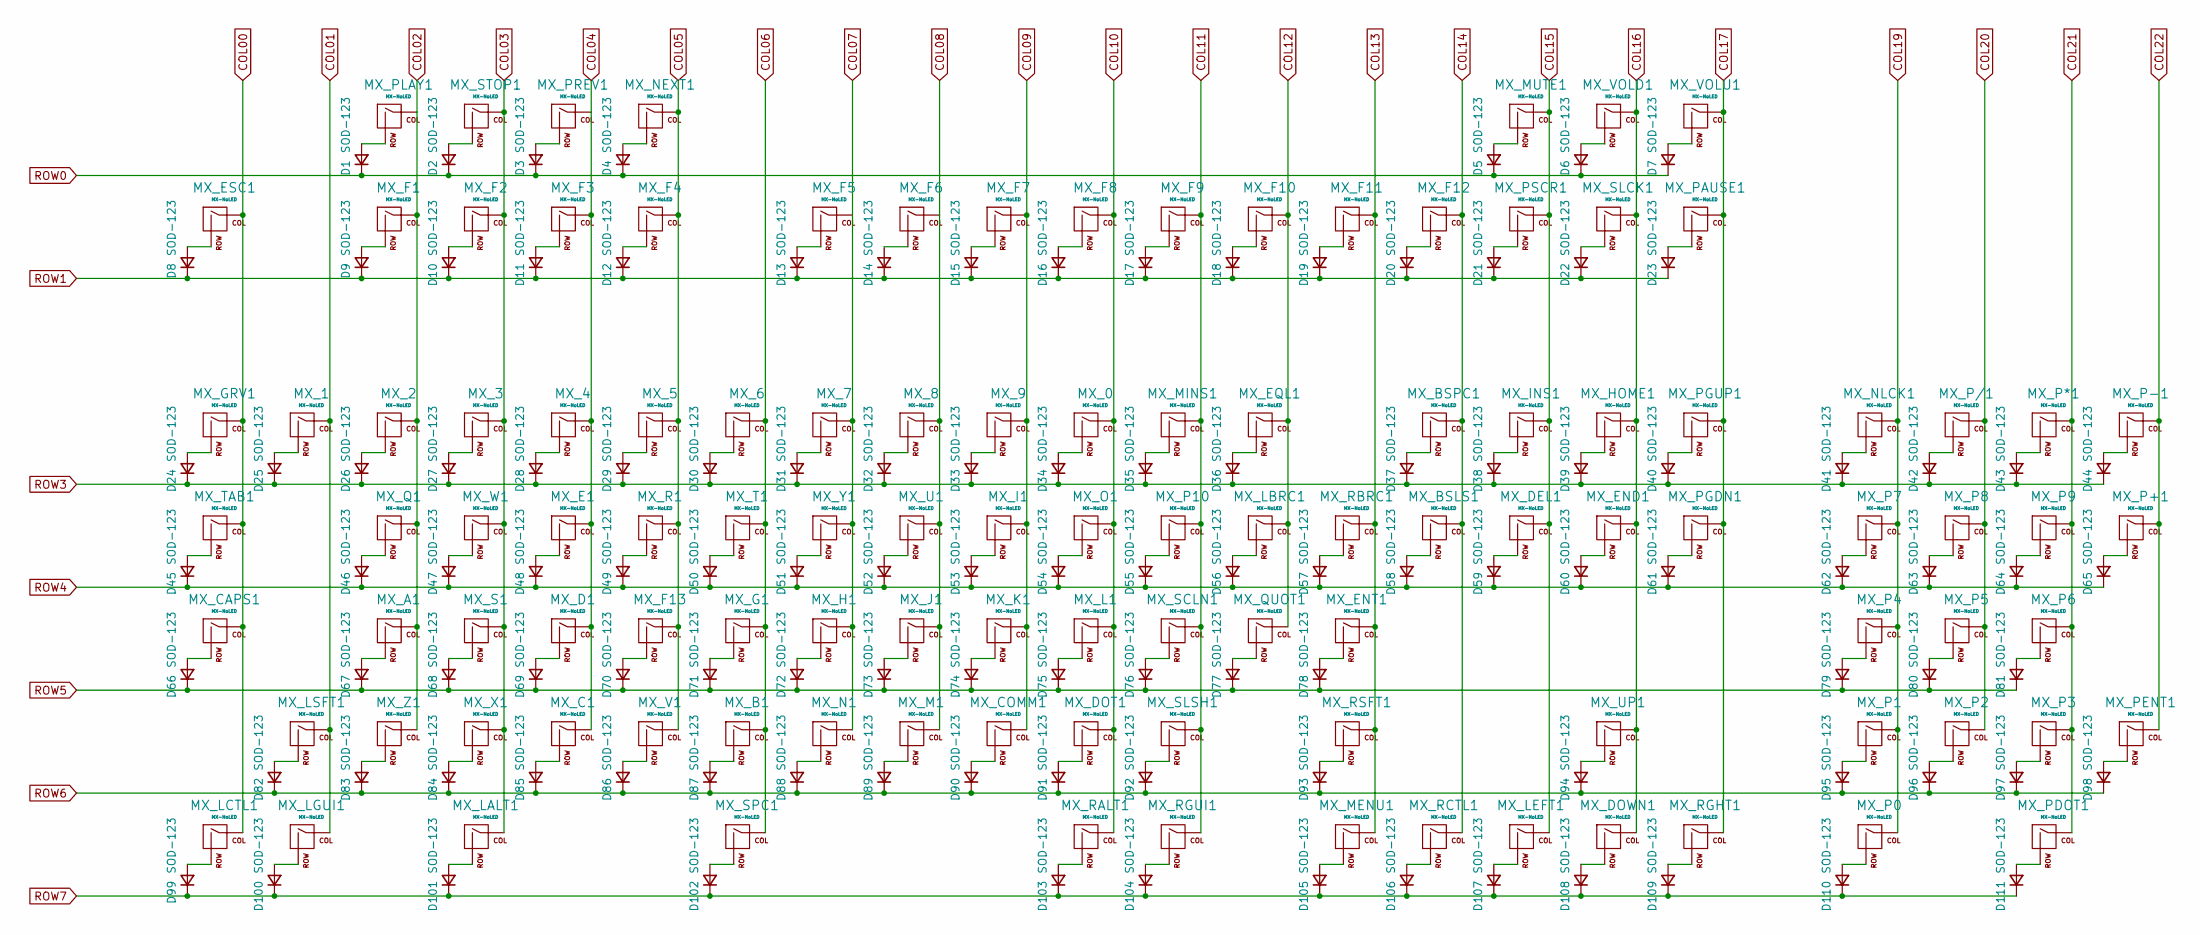
[picture p34: schematic Matrix.sch]

Parts:
D1, D2, D3, D4, D5, D6, D7, D8, D9, D10, D11, D12, D13, D14, D15, D16, D17, D18, D19, D20, D21, D22, D23, D24, D25, D26, D27, D28, D29, D30, D31, D32, D33, D34, D35, D36, D37, D38, D39, D40, D41, D42, D43, D44, D45, D46, D47, D48, D49, D50, D51, D52, D53, D54, D55, D56, D57, D58, D59, D60, D61, D62, D63, D64, D65, D66, D67, D68, D69, D70, D71, D72, D73, D74, D75, D76, D77, D78, D79, D80, D81, D82, D83, D84, D85, D86, D87, D88, D89, D90, D91, D92, D93, D94, D95, D96, D97, D98, D99, D100, D101, D102, D103, D104, D105, D106, D107, D108, D109, D110, D111: SOD-123; D_SOD-123
MX_0, MX_1, MX_2, MX_3, MX_4, MX_5, MX_6, MX_7, MX_8, MX_9: MX-NoLED; MXOnly-1U-NoLED
MX_A1: MX-NoLED; MXOnly-1U-NoLED
MX_B1: MX-NoLED; MXOnly-1U-NoLED
MX_BSLS1: MX-NoLED; MXOnly-1.5U-NoLED
MX_BSPC1: MX-NoLED; MXOnly-2U-NoLED
MX_C1: MX-NoLED; MXOnly-1U-NoLED
MX_CAPS1: MX-NoLED; MXOnly-1.75U-NoLED
MX_COMM1: MX-NoLED; MXOnly-1U-NoLED
MX_D1: MX-NoLED; MXOnly-1U-NoLED
MX_DEL1: MX-NoLED; MXOnly-1U-NoLED
MX_DOT1: MX-NoLED; MXOnly-1U-NoLED
MX_DOWN1: MX-NoLED; MXOnly-1U-NoLED
MX_E1: MX-NoLED; MXOnly-1U-NoLED
MX_END1: MX-NoLED; MXOnly-1U-NoLED
MX_ENT1: MX-NoLED; MXOnly-2.25U-NoLED
MX_EQL1: MX-NoLED; MXOnly-1U-NoLED
MX_ESC1: MX-NoLED; MXOnly-1U-NoLED
MX_F1, MX_F2, MX_F3, MX_F4, MX_F5, MX_F6, MX_F7, MX_F8, MX_F9, MX_F10, MX_F11, MX_F12, MX_F13: MX-NoLED; MXOnly-1U-NoLED
MX_G1: MX-NoLED; MXOnly-1U-NoLED
MX_GRV1: MX-NoLED; MXOnly-1U-NoLED
MX_H1: MX-NoLED; MXOnly-1U-NoLED
MX_HOME1: MX-NoLED; MXOnly-1U-NoLED
MX_I1: MX-NoLED; MXOnly-1U-NoLED
MX_INS1: MX-NoLED; MXOnly-1U-NoLED
MX_J1: MX-NoLED; MXOnly-1U-NoLED
MX_K1: MX-NoLED; MXOnly-1U-NoLED
MX_L1: MX-NoLED; MXOnly-1U-NoLED
MX_LALT1: MX-NoLED; MXOnly-1.25U-NoLED
MX_LBRC1: MX-NoLED; MXOnly-1U-NoLED
MX_LCTL1: MX-NoLED; MXOnly-1.25U-NoLED
MX_LEFT1: MX-NoLED; MXOnly-1U-NoLED
MX_LGUI1: MX-NoLED; MXOnly-1.25U-NoLED
MX_LSFT1: MX-NoLED; MXOnly-2.25U-NoLED
MX_M1: MX-NoLED; MXOnly-1U-NoLED
MX_MENU1: MX-NoLED; MXOnly-1.25U-NoLED
MX_MINS1: MX-NoLED; MXOnly-1U-NoLED
MX_MUTE1: MX-NoLED; MXOnly-1U-NoLED
MX_N1: MX-NoLED; MXOnly-1U-NoLED
MX_NEXT1: MX-NoLED; MXOnly-1U-NoLED
MX_NLCK1: MX-NoLED; MXOnly-1U-NoLED
MX_O1: MX-NoLED; MXOnly-1U-NoLED
MX_P0: MX-NoLED; MXOnly-2U-NoLED
MX_P1, MX_P2, MX_P3, MX_P4, MX_P5, MX_P6, MX_P7, MX_P8, MX_P9, MX_P10: MX-NoLED; MXOnly-1U-NoLED
MX_P*1: MX-NoLED; MXOnly-1U-NoLED
MX_P+1: MX-NoLED; MXOnly-2U-NoLED_Vertical
MX_P-1: MX-NoLED; MXOnly-1U-NoLED
MX_P/1: MX-NoLED; MXOnly-1U-NoLED
MX_PAUSE1: MX-NoLED; MXOnly-1U-NoLED
MX_PDOT1: MX-NoLED; MXOnly-1U-NoLED
MX_PENT1: MX-NoLED; MXOnly-2U-NoLED_Vertical
MX_PGDN1: MX-NoLED; MXOnly-1U-NoLED
MX_PGUP1: MX-NoLED; MXOnly-1U-NoLED
MX_PLAY1: MX-NoLED; MXOnly-1U-NoLED
MX_PREV1: MX-NoLED; MXOnly-1U-NoLED
MX_PSCR1: MX-NoLED; MXOnly-1U-NoLED
MX_Q1: MX-NoLED; MXOnly-1U-NoLED
MX_QUOT1: MX-NoLED; MXOnly-1U-NoLED
MX_R1: MX-NoLED; MXOnly-1U-NoLED
MX_RALT1: MX-NoLED; MXOnly-1.25U-NoLED
MX_RBRC1: MX-NoLED; MXOnly-1U-NoLED
MX_RCTL1: MX-NoLED; MXOnly-1.25U-NoLED
MX_RGHT1: MX-NoLED; MXOnly-1U-NoLED
MX_RGUI1: MX-NoLED; MXOnly-1.25U-NoLED
MX_RSFT1: MX-NoLED; MXOnly-2.75U-NoLED
MX_S1: MX-NoLED; MXOnly-1U-NoLED
MX_SCLN1: MX-NoLED; MXOnly-1U-NoLED
MX_SLCK1: MX-NoLED; MXOnly-1U-NoLED
MX_SLSH1: MX-NoLED; MXOnly-1U-NoLED
MX_SPC1: MX-NoLED; MXOnly-6.25U-NoLED
MX_STOP1: MX-NoLED; MXOnly-1U-NoLED
MX_T1: MX-NoLED; MXOnly-1U-NoLED
MX_TAB1: MX-NoLED; MXOnly-1.5U-NoLED
MX_U1: MX-NoLED; MXOnly-1U-NoLED
MX_UP1: MX-NoLED; MXOnly-1U-NoLED
MX_V1: MX-NoLED; MXOnly-1U-NoLED
MX_VOLD1: MX-NoLED; MXOnly-1U-NoLED
MX_VOLU1: MX-NoLED; MXOnly-1U-NoLED
MX_W1: MX-NoLED; MXOnly-1U-NoLED
MX_X1: MX-NoLED; MXOnly-1U-NoLED
MX_Y1: MX-NoLED; MXOnly-1U-NoLED
MX_Z1: MX-NoLED; MXOnly-1U-NoLED

Connections:
COL00: MX_CAPS1.1 (COL), MX_ESC1.1 (COL), MX_GRV1.1 (COL), MX_LCTL1.1 (COL), MX_TAB1.1 (COL); also elsewhere on the board
COL01: MX_1.1 (COL), MX_LGUI1.1 (COL), MX_LSFT1.1 (COL); also elsewhere on the board
COL02: MX_2.1 (COL), MX_A1.1 (COL), MX_F1.1 (COL), MX_PLAY1.1 (COL), MX_Q1.1 (COL), MX_Z1.1 (COL); also elsewhere on the board
COL03: MX_3.1 (COL), MX_F2.1 (COL), MX_LALT1.1 (COL), MX_S1.1 (COL), MX_STOP1.1 (COL), MX_W1.1 (COL), MX_X1.1 (COL); also elsewhere on the board
COL04: MX_4.1 (COL), MX_C1.1 (COL), MX_D1.1 (COL), MX_E1.1 (COL), MX_F3.1 (COL), MX_PREV1.1 (COL); also elsewhere on the board
COL05: MX_5.1 (COL), MX_F4.1 (COL), MX_F13.1 (COL), MX_NEXT1.1 (COL), MX_R1.1 (COL), MX_V1.1 (COL); also elsewhere on the board
COL06: MX_6.1 (COL), MX_B1.1 (COL), MX_G1.1 (COL), MX_SPC1.1 (COL), MX_T1.1 (COL); also elsewhere on the board
COL07: MX_7.1 (COL), MX_F5.1 (COL), MX_H1.1 (COL), MX_N1.1 (COL), MX_Y1.1 (COL); also elsewhere on the board
COL08: MX_8.1 (COL), MX_F6.1 (COL), MX_J1.1 (COL), MX_M1.1 (COL), MX_U1.1 (COL); also elsewhere on the board
COL09: MX_9.1 (COL), MX_COMM1.1 (COL), MX_F7.1 (COL), MX_I1.1 (COL), MX_K1.1 (COL); also elsewhere on the board
COL10: MX_0.1 (COL), MX_DOT1.1 (COL), MX_F8.1 (COL), MX_L1.1 (COL), MX_O1.1 (COL), MX_RALT1.1 (COL); also elsewhere on the board
COL11: MX_F9.1 (COL), MX_MINS1.1 (COL), MX_P10.1 (COL), MX_RGUI1.1 (COL), MX_SCLN1.1 (COL), MX_SLSH1.1 (COL); also elsewhere on the board
COL12: MX_EQL1.1 (COL), MX_F10.1 (COL), MX_LBRC1.1 (COL), MX_QUOT1.1 (COL); also elsewhere on the board
COL13: MX_ENT1.1 (COL), MX_F11.1 (COL), MX_MENU1.1 (COL), MX_RBRC1.1 (COL), MX_RSFT1.1 (COL); also elsewhere on the board
COL14: MX_BSLS1.1 (COL), MX_BSPC1.1 (COL), MX_F12.1 (COL), MX_RCTL1.1 (COL); also elsewhere on the board
COL15: MX_DEL1.1 (COL), MX_INS1.1 (COL), MX_LEFT1.1 (COL), MX_MUTE1.1 (COL), MX_PSCR1.1 (COL); also elsewhere on the board
COL16: MX_DOWN1.1 (COL), MX_END1.1 (COL), MX_HOME1.1 (COL), MX_SLCK1.1 (COL), MX_UP1.1 (COL), MX_VOLD1.1 (COL); also elsewhere on the board
COL17: MX_PAUSE1.1 (COL), MX_PGDN1.1 (COL), MX_PGUP1.1 (COL), MX_RGHT1.1 (COL), MX_VOLU1.1 (COL); also elsewhere on the board
COL19: MX_NLCK1.1 (COL), MX_P0.1 (COL), MX_P1.1 (COL), MX_P4.1 (COL), MX_P7.1 (COL); also elsewhere on the board
COL20: MX_P2.1 (COL), MX_P5.1 (COL), MX_P8.1 (COL), MX_P/1.1 (COL); also elsewhere on the board
COL21: MX_P3.1 (COL), MX_P6.1 (COL), MX_P9.1 (COL), MX_P*1.1 (COL), MX_PDOT1.1 (COL); also elsewhere on the board
COL22: MX_P+1.1 (COL), MX_P-1.1 (COL), MX_PENT1.1 (COL); also elsewhere on the board
unnamed: D1.2 (A), MX_PLAY1.2 (ROW)
unnamed: D2.2 (A), MX_STOP1.2 (ROW)
unnamed: D3.2 (A), MX_PREV1.2 (ROW)
unnamed: D4.2 (A), MX_NEXT1.2 (ROW)
unnamed: D5.2 (A), MX_MUTE1.2 (ROW)
unnamed: D6.2 (A), MX_VOLD1.2 (ROW)
unnamed: D7.2 (A), MX_VOLU1.2 (ROW)
unnamed: D8.2 (A), MX_ESC1.2 (ROW)
unnamed: D9.2 (A), MX_F1.2 (ROW)
unnamed: D10.2 (A), MX_F2.2 (ROW)
unnamed: D11.2 (A), MX_F3.2 (ROW)
unnamed: D12.2 (A), MX_F4.2 (ROW)
unnamed: D13.2 (A), MX_F5.2 (ROW)
unnamed: D14.2 (A), MX_F6.2 (ROW)
unnamed: D15.2 (A), MX_F7.2 (ROW)
unnamed: D16.2 (A), MX_F8.2 (ROW)
unnamed: D17.2 (A), MX_F9.2 (ROW)
unnamed: D18.2 (A), MX_F10.2 (ROW)
unnamed: D19.2 (A), MX_F11.2 (ROW)
unnamed: D20.2 (A), MX_F12.2 (ROW)
unnamed: D21.2 (A), MX_PSCR1.2 (ROW)
unnamed: D22.2 (A), MX_SLCK1.2 (ROW)
unnamed: D23.2 (A), MX_PAUSE1.2 (ROW)
unnamed: D24.2 (A), MX_GRV1.2 (ROW)
unnamed: D25.2 (A), MX_1.2 (ROW)
unnamed: D26.2 (A), MX_2.2 (ROW)
unnamed: D27.2 (A), MX_3.2 (ROW)
unnamed: D28.2 (A), MX_4.2 (ROW)
unnamed: D29.2 (A), MX_5.2 (ROW)
unnamed: D30.2 (A), MX_6.2 (ROW)
unnamed: D31.2 (A), MX_7.2 (ROW)
unnamed: D32.2 (A), MX_8.2 (ROW)
unnamed: D33.2 (A), MX_9.2 (ROW)
unnamed: D34.2 (A), MX_0.2 (ROW)
unnamed: D35.2 (A), MX_MINS1.2 (ROW)
unnamed: D36.2 (A), MX_EQL1.2 (ROW)
unnamed: D37.2 (A), MX_BSPC1.2 (ROW)
unnamed: D38.2 (A), MX_INS1.2 (ROW)
unnamed: D39.2 (A), MX_HOME1.2 (ROW)
unnamed: D40.2 (A), MX_PGUP1.2 (ROW)
unnamed: D41.2 (A), MX_NLCK1.2 (ROW)
unnamed: D42.2 (A), MX_P/1.2 (ROW)
unnamed: D43.2 (A), MX_P*1.2 (ROW)
unnamed: D44.2 (A), MX_P-1.2 (ROW)
unnamed: D45.2 (A), MX_TAB1.2 (ROW)
unnamed: D46.2 (A), MX_Q1.2 (ROW)
unnamed: D47.2 (A), MX_W1.2 (ROW)
unnamed: D48.2 (A), MX_E1.2 (ROW)
unnamed: D49.2 (A), MX_R1.2 (ROW)
unnamed: D50.2 (A), MX_T1.2 (ROW)
unnamed: D51.2 (A), MX_Y1.2 (ROW)
unnamed: D52.2 (A), MX_U1.2 (ROW)
unnamed: D53.2 (A), MX_I1.2 (ROW)
unnamed: D54.2 (A), MX_O1.2 (ROW)
unnamed: D55.2 (A), MX_P10.2 (ROW)
unnamed: D56.2 (A), MX_LBRC1.2 (ROW)
unnamed: D57.2 (A), MX_RBRC1.2 (ROW)
unnamed: D58.2 (A), MX_BSLS1.2 (ROW)
unnamed: D59.2 (A), MX_DEL1.2 (ROW)
unnamed: D60.2 (A), MX_END1.2 (ROW)
unnamed: D61.2 (A), MX_PGDN1.2 (ROW)
unnamed: D62.2 (A), MX_P7.2 (ROW)
unnamed: D63.2 (A), MX_P8.2 (ROW)
unnamed: D64.2 (A), MX_P9.2 (ROW)
unnamed: D65.2 (A), MX_P+1.2 (ROW)
unnamed: D66.2 (A), MX_CAPS1.2 (ROW)
unnamed: D67.2 (A), MX_A1.2 (ROW)
unnamed: D68.2 (A), MX_S1.2 (ROW)
unnamed: D69.2 (A), MX_D1.2 (ROW)
unnamed: D70.2 (A), MX_F13.2 (ROW)
unnamed: D71.2 (A), MX_G1.2 (ROW)
unnamed: D72.2 (A), MX_H1.2 (ROW)
unnamed: D73.2 (A), MX_J1.2 (ROW)
unnamed: D74.2 (A), MX_K1.2 (ROW)
unnamed: D75.2 (A), MX_L1.2 (ROW)
unnamed: D76.2 (A), MX_SCLN1.2 (ROW)
unnamed: D77.2 (A), MX_QUOT1.2 (ROW)
unnamed: D78.2 (A), MX_ENT1.2 (ROW)
unnamed: D79.2 (A), MX_P4.2 (ROW)
unnamed: D80.2 (A), MX_P5.2 (ROW)
unnamed: D81.2 (A), MX_P6.2 (ROW)
unnamed: D82.2 (A), MX_LSFT1.2 (ROW)
unnamed: D83.2 (A), MX_Z1.2 (ROW)
unnamed: D84.2 (A), MX_X1.2 (ROW)
unnamed: D85.2 (A), MX_C1.2 (ROW)
unnamed: D86.2 (A), MX_V1.2 (ROW)
unnamed: D87.2 (A), MX_B1.2 (ROW)
unnamed: D88.2 (A), MX_N1.2 (ROW)
unnamed: D89.2 (A), MX_M1.2 (ROW)
unnamed: D90.2 (A), MX_COMM1.2 (ROW)
unnamed: D91.2 (A), MX_DOT1.2 (ROW)
unnamed: D92.2 (A), MX_SLSH1.2 (ROW)
unnamed: D93.2 (A), MX_RSFT1.2 (ROW)
unnamed: D94.2 (A), MX_UP1.2 (ROW)
unnamed: D95.2 (A), MX_P1.2 (ROW)
unnamed: D96.2 (A), MX_P2.2 (ROW)
unnamed: D97.2 (A), MX_P3.2 (ROW)
unnamed: D98.2 (A), MX_PENT1.2 (ROW)
unnamed: D99.2 (A), MX_LCTL1.2 (ROW)
unnamed: D100.2 (A), MX_LGUI1.2 (ROW)
unnamed: D101.2 (A), MX_LALT1.2 (ROW)
unnamed: D102.2 (A), MX_SPC1.2 (ROW)
unnamed: D103.2 (A), MX_RALT1.2 (ROW)
unnamed: D104.2 (A), MX_RGUI1.2 (ROW)
unnamed: D105.2 (A), MX_MENU1.2 (ROW)
unnamed: D106.2 (A), MX_RCTL1.2 (ROW)
unnamed: D107.2 (A), MX_LEFT1.2 (ROW)
unnamed: D108.2 (A), MX_DOWN1.2 (ROW)
unnamed: D109.2 (A), MX_RGHT1.2 (ROW)
unnamed: D110.2 (A), MX_P0.2 (ROW)
unnamed: D111.2 (A), MX_PDOT1.2 (ROW)
ROW0: D1.1 (K), D2.1 (K), D3.1 (K), D4.1 (K), D5.1 (K), D6.1 (K), D7.1 (K); also elsewhere on the board
ROW1: D8.1 (K), D9.1 (K), D10.1 (K), D11.1 (K), D12.1 (K), D13.1 (K), D14.1 (K), D15.1 (K), D16.1 (K), D17.1 (K), D18.1 (K), D19.1 (K), D20.1 (K), D21.1 (K), D22.1 (K), D23.1 (K); also elsewhere on the board
ROW3: D24.1 (K), D25.1 (K), D26.1 (K), D27.1 (K), D28.1 (K), D29.1 (K), D30.1 (K), D31.1 (K), D32.1 (K), D33.1 (K), D34.1 (K), D35.1 (K), D36.1 (K), D37.1 (K), D38.1 (K), D39.1 (K), D40.1 (K), D41.1 (K), D42.1 (K), D43.1 (K), D44.1 (K); also elsewhere on the board
ROW4: D45.1 (K), D46.1 (K), D47.1 (K), D48.1 (K), D49.1 (K), D50.1 (K), D51.1 (K), D52.1 (K), D53.1 (K), D54.1 (K), D55.1 (K), D56.1 (K), D57.1 (K), D58.1 (K), D59.1 (K), D60.1 (K), D61.1 (K), D62.1 (K), D63.1 (K), D64.1 (K), D65.1 (K); also elsewhere on the board
ROW5: D66.1 (K), D67.1 (K), D68.1 (K), D69.1 (K), D70.1 (K), D71.1 (K), D72.1 (K), D73.1 (K), D74.1 (K), D75.1 (K), D76.1 (K), D77.1 (K), D78.1 (K), D79.1 (K), D80.1 (K), D81.1 (K); also elsewhere on the board
ROW6: D82.1 (K), D83.1 (K), D84.1 (K), D85.1 (K), D86.1 (K), D87.1 (K), D88.1 (K), D89.1 (K), D90.1 (K), D91.1 (K), D92.1 (K), D93.1 (K), D94.1 (K), D95.1 (K), D96.1 (K), D97.1 (K), D98.1 (K); also elsewhere on the board
ROW7: D99.1 (K), D100.1 (K), D101.1 (K), D102.1 (K), D103.1 (K), D104.1 (K), D105.1 (K), D106.1 (K), D107.1 (K), D108.1 (K), D109.1 (K), D110.1 (K), D111.1 (K); also elsewhere on the board

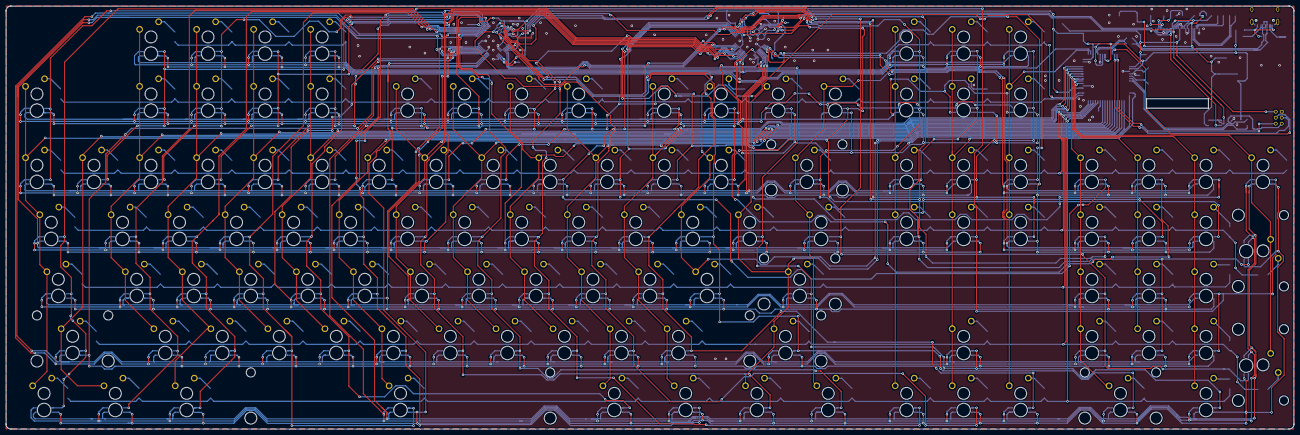
[picture p35: board TooManyKeys.kicad_pcb from above]

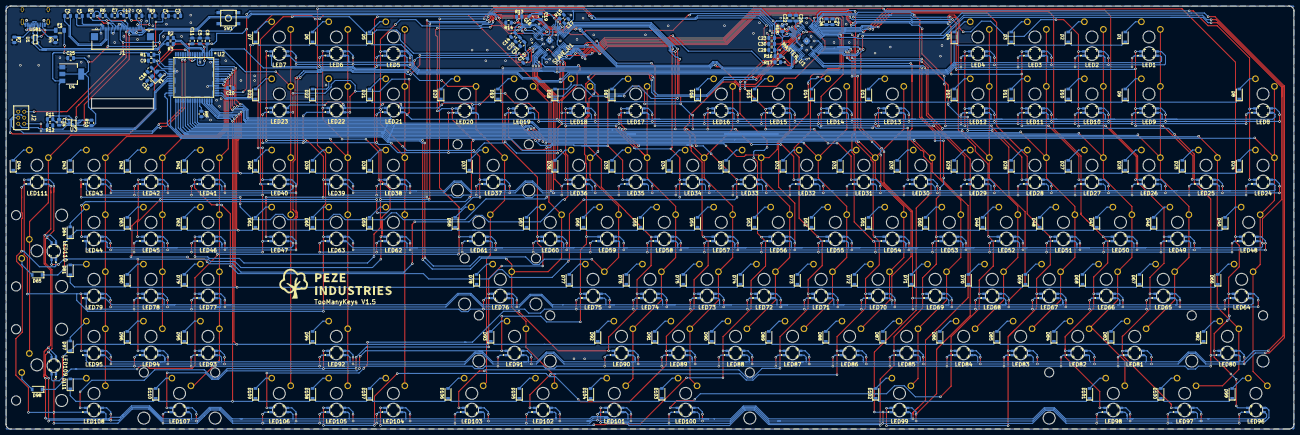
[picture p36: board TooManyKeys.kicad_pcb from below]

Board: 2 copper layers, 430.2 x 141.3 mm, 393 parts (282 on the bottom side), 233 nets.
