pesantsi/CustomPcbs/Voyager104/Voyager104.kicad_pcb

## KiCad design Voyager104/Voyager104.kicad_pcb (2020-03-06)

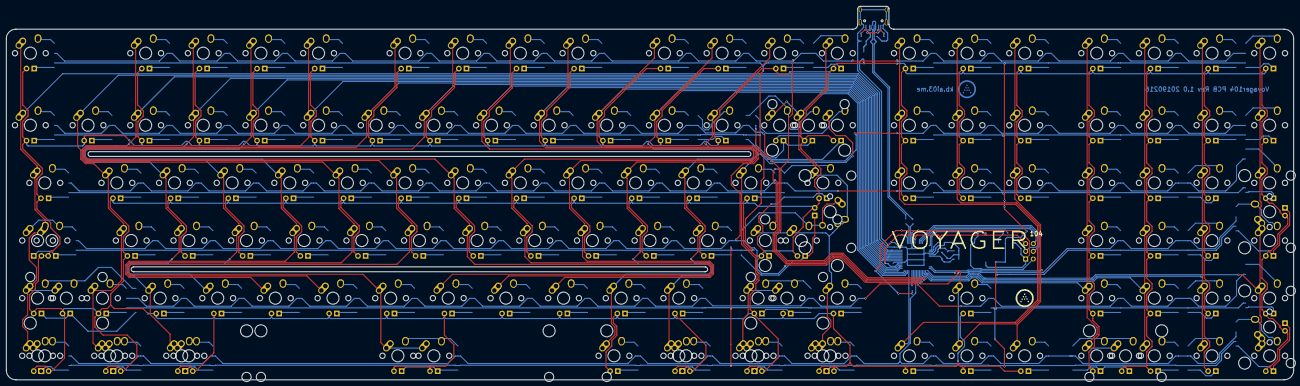
[picture p37: board Voyager104.kicad_pcb from above]

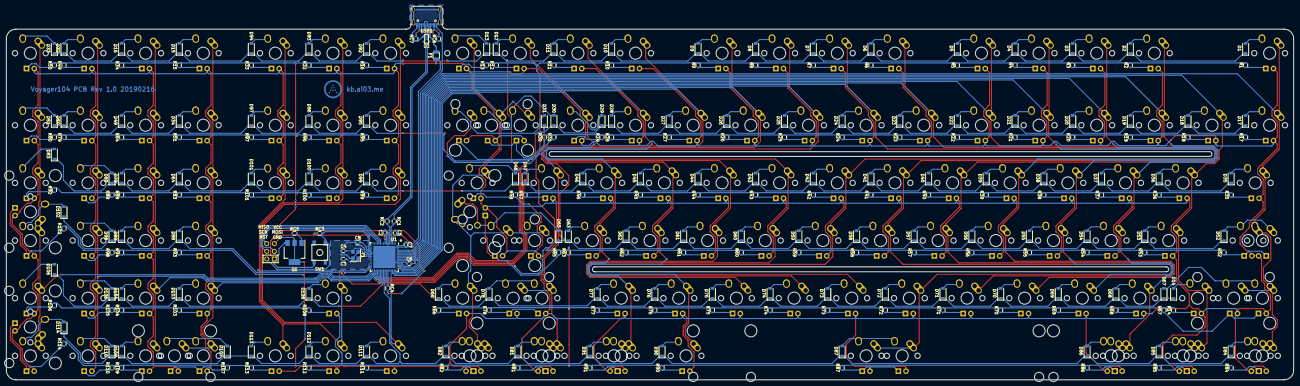
[picture p38: board Voyager104.kicad_pcb from below]

Board: 2 copper layers, 425.4 x 123.4 mm, 380 parts (250 on the bottom side), 275 nets.

Parts:
C2, C5: 1uF; C_0603
C3, C4: 22pF; C_0603
C6, C7, C8: 0.1uF; C_0603
D1, D2, D3, D4, D5, D6, D7, D8, D9, D10, D11, D12, D13, D14, D15, D16, D17, D18, D19, D20, D21, D22, D23, D24, D25, D26, D27, D28, D29, D30, D31, D32, D33, D34, D35, D36, D37, D38, D39, D40, D41, D42, D43, D44, D45, D46, D47, D48, D49, D50, D51, D52, D53, D54, D55, D56, D57, D58, D59, D60, D61, D62, D63, D64, D65, D66, D67, D68, D69, D70, D71, D72, D73, D74, D75, D76, D77, D78, D79, D80, D81, D82, D83, D84, D85, D86, D87, D88, D89, D90, D91, D92, D93, D94, D95, D96, D97, D98, D99, D100, D101, D102, D103, D104, D105, D106, D107, D108, D109, D110, D111, D112, D113, D114: SOD-323; D_SOD-123
F1: 500mA; Fuse_SMD1206_Reflow
J1: AVR-ISP-6; Reset_Pretty-Mask
MX_#0_1, MX_#1, MX_#2, MX_#3, MX_#4, MX_#5, MX_#6, MX_#7, MX_#8, MX_#9: MX-1U
MX_'1: MX-1U
MX_,1: MX-1U
MX_-1: MX-1U
MX_.1: MX-1U
MX_/1: MX-1U
MX_;1: MX-1U
MX_=1: MX-1U
MX_A1: MX-1U
MX_B1: MX-1U
MX_BACK1: MX-2U
MX_BACK2, MX_BACK3: MX-1U
MX_C1: MX-1U
MX_CLOCK1: MX-1.75U
MX_CLOCK2: MX-1.25U; MX-1.25U-FLIPPED
MX_D1: MX-1U
MX_DEL1: MX-1U
MX_DN1: MX-1U
MX_E1: MX-1U
MX_END1: MX-1U
MX_ESC1: MX-1U
MX_F1: MX-1U
MX_FN1, MX_FN2, MX_FN3, MX_FN4, MX_FN5, MX_FN6, MX_FN7, MX_FN8, MX_FN9, MX_FN10, MX_FN11, MX_FN12: MX-1U
MX_G1: MX-1U
MX_H1: MX-1U
MX_HOME1: MX-1U
MX_I1: MX-1U
MX_INS1: MX-1U
MX_J1: MX-1U
MX_K1: MX-1U
MX_L1: MX-1U
MX_LALT1: MX-1.25U
MX_LALT2: MX-1.5U; MX-1.5U-FLIPPED
MX_LCTRL1: MX-1.25U
MX_LCTRL2: MX-1.5U; MX-1.5U-FLIPPED
MX_LFT1: MX-1U
MX_LGUI1: MX-1.25U
MX_LGUI2: MX-1U; MX-1U-FLIPPED
MX_LSHIFT1: MX-2.25U
MX_LSHIFT2: MX-1.25U
MX_LSHIFT3: MX-1U
MX_M1: MX-1U
MX_N1: MX-1U
MX_NUM1, MX_NUM2, MX_NUM3, MX_NUM4, MX_NUM5, MX_NUM6, MX_NUM7, MX_NUM8, MX_NUM9, MX_NUM10, MX_NUM11, MX_NUM12, MX_NUM13, MX_NUM14, MX_NUM15, MX_NUM16, MX_NUM17, MX_NUM18, MX_NUM19, MX_NUM20, MX_NUM21, MX_NUM22, MX_NUM23, MX_NUM24: MX-1U
MX_NUM_EX1, MX_NUM_EX2, MX_NUM_EX3: MX-2U; MX-2U-ReversedStabilizers
MX_O1: MX-1U
MX_P1: MX-1U
MX_PAUSE1: MX-1U
MX_PGDN1: MX-1U
MX_PGUP1: MX-1U
MX_PRINT1: MX-1U
MX_Q1: MX-1U
MX_R1: MX-1U
MX_RALT1: MX-1.25U
MX_RALT2: MX-1.5U
MX_RCTRL1: MX-1.25U; MX-1.25U-FLIPPED
MX_RCTRL2: MX-1.5U
MX_RETURN1: MX-2.25U
MX_RETURN2: MX-ISO; MX-ISO-ReversedStabilizers
MX_RGUI1: MX-1.25U; MX-1.25U-FLIPPED
MX_RGUI2: MX-1U
MX_RMENU1: MX-1.25U; MX-1.25U-FLIPPED
MX_RSHIFT1: MX-2.75U
MX_RSHIFT2: MX-1.75U
MX_RSHIFT3: MX-1U
MX_RT1: MX-1U
MX_S1: MX-1U
MX_SLOCK1: MX-1U
MX_SP1: MX-6.25U; MX-6.25U-ReversedStabilizers
MX_SP2: MX-7U; MX-7U-ReversedStabilizers
MX_T1: MX-1U
MX_TAB1: MX-1.5U
MX_U1: MX-1U
MX_UP1: MX-1U
MX_V1: MX-1U
MX_W1: MX-1U
MX_X1: MX-1U
MX_Y1: MX-1U
MX_Z1: MX-1U
MX_[1: MX-1U
MX_\1: MX-1.5U
MX_\2: MX-1U
MX_]1: MX-1U
MX_`1: MX-1U
Q1: DSS60601MZ4-13; SOT-223-3_TabPin2
R1, R2, R3, R4, R5, R6, R7, R8, R9, R10, R11, R12, R13, R14, R15, R16, R17, R18, R19, R20, R21, R22, R23, R24, R25, R26, R27, R28, R29, R30, R31, R32, R33, R34, R35, R36, R37, R38, R39, R40, R41, R42, R43, R44, R45, R46, R47, R48, R49, R50, R51, R52, R53, R54, R55, R56, R57, R58, R59, R60, R61, R62, R63, R64, R65, R66, R67, R68, R69, R70, R71, R72, R73, R74, R75, R76, R77, R78, R79, R80, R81, R82, R83, R84, R85, R86, R87, R88, R89, R90, R91, R92, R93, R94, R95, R96, R97, R98, R99, R100, R101, R102, R103, R104, R105, R106, R107, R108, R109, R110, R111, R112, R113, R114: 1k; R_0603
RC1, RC2: 22; R_0603
RC3: 10k; R_0603
RC4: 1k; R_0603
RC5: 1.5k; R_0603
RC6, RC7: 5k1; R_0603
SW1: SW_Push; SKQG-1155865
U1: AT90USB1286-AU; QFN-64-1EP_9x9mm_Pitch0.5mm
U2: PRTR5V0U2X; SOT143B
USB1: HRO-TYPE-C-31-M-12; HRO-TYPE-C-31-M-12-Assembly
Y1: 16MHz; Crystal_SMD_3225-4pin_3.2x2.5mm

Connections:
+5V: C5.2, C6.2, C7.2, C8.2, F1.1, J1.2, MX_#0_1.3, MX_#1.3, MX_#2.3, MX_#3.3, MX_#4.3, MX_#5.3, MX_#6.3, MX_#7.3, MX_#8.3, MX_#9.3, MX_'1.3, MX_,1.3, MX_-1.3, MX_.1.3, MX_/1.3, MX_;1.3, MX_=1.3, MX_A1.3, MX_B1.3, MX_BACK1.3, MX_BACK2.3, MX_BACK3.3, MX_C1.3, MX_CLOCK1.3, MX_CLOCK2.3, MX_D1.3, MX_DEL1.3, MX_DN1.3, MX_E1.3, MX_END1.3, MX_ESC1.3, MX_F1.3, MX_FN1.3, MX_FN2.3, MX_FN3.3, MX_FN4.3, MX_FN5.3, MX_FN6.3, MX_FN7.3, MX_FN8.3, MX_FN9.3, MX_FN10.3, MX_FN11.3, MX_FN12.3, MX_G1.3, MX_H1.3, MX_HOME1.3, MX_I1.3, MX_INS1.3, MX_J1.3, MX_K1.3, MX_L1.3, MX_LALT1.3, MX_LALT2.3, MX_LCTRL1.3, MX_LCTRL2.3, MX_LFT1.3, MX_LGUI1.3, MX_LGUI2.3, MX_LSHIFT1.3, MX_LSHIFT2.3, MX_LSHIFT3.3, MX_M1.3, MX_N1.3, MX_NUM1.3, MX_NUM2.3, MX_NUM3.3, MX_NUM4.3, MX_NUM5.3, MX_NUM6.3, MX_NUM7.3, MX_NUM8.3, MX_NUM9.3, MX_NUM10.3, MX_NUM11.3, MX_NUM12.3, MX_NUM13.3, MX_NUM14.3, MX_NUM15.3, MX_NUM16.3, MX_NUM17.3, MX_NUM18.3, MX_NUM19.3, MX_NUM20.3, MX_NUM21.3, MX_NUM22.3, MX_NUM23.3, MX_NUM24.3, MX_NUM_EX1.3, MX_NUM_EX2.3, MX_NUM_EX3.3, MX_O1.3, MX_P1.3, MX_PAUSE1.3, MX_PGDN1.3, MX_PGUP1.3, MX_PRINT1.3, MX_Q1.3, MX_R1.3, MX_RALT1.3, MX_RALT2.3, MX_RCTRL1.3, MX_RCTRL2.3, MX_RETURN1.3, MX_RETURN2.3, MX_RGUI1.3, MX_RGUI2.3, MX_RMENU1.3, MX_RSHIFT1.3, MX_RSHIFT2.3, MX_RSHIFT3.3, MX_RT1.3, MX_S1.3, MX_SLOCK1.3, MX_SP1.3, MX_SP2.3, MX_T1.3, MX_TAB1.3, MX_U1.3, MX_UP1.3, MX_V1.3, MX_W1.3, MX_X1.3, MX_Y1.3, MX_Z1.3, MX_[1.3, MX_\1.3, MX_\2.3, MX_]1.3, MX_`1.3, RC3.1, U1.3, U1.8, U1.21, U1.52, U1.64
COL0: MX_CLOCK1.1, MX_CLOCK2.2, MX_ESC1.1, MX_LCTRL1.1, MX_LCTRL2.1, MX_LSHIFT1.1, MX_LSHIFT2.1, MX_TAB1.1, MX_`1.1, U1.61
COL1: MX_#1.1, MX_A1.1, MX_LGUI1.1, MX_LGUI2.1, MX_LSHIFT3.1, MX_Q1.1, U1.60
COL2: MX_#2.1, MX_FN1.1, MX_LALT1.1, MX_LALT2.1, MX_S1.1, MX_W1.1, MX_Z1.1, U1.59
COL3: MX_#3.1, MX_D1.1, MX_E1.1, MX_FN2.1, MX_X1.1, U1.58
COL4: MX_#4.1, MX_C1.1, MX_F1.1, MX_FN3.1, MX_R1.1, U1.57
COL5: MX_#5.1, MX_FN4.1, MX_G1.1, MX_T1.1, MX_V1.1, U1.56
COL6: MX_#6.1, MX_B1.1, MX_FN5.1, MX_H1.1, MX_SP1.1, MX_SP2.1, MX_Y1.1, U1.55
COL7: MX_#7.1, MX_FN6.1, MX_J1.1, MX_N1.1, MX_U1.1, U1.54
COL8: MX_#8.1, MX_FN7.1, MX_I1.1, MX_K1.1, MX_M1.1, U1.51
COL9: MX_#9.1, MX_,1.1, MX_FN8.1, MX_L1.1, MX_O1.1, U1.50
COL10: MX_#0_1.1, MX_.1.1, MX_;1.1, MX_FN9.1, MX_P1.1, MX_RALT1.1, U1.49
COL11: MX_'1.1, MX_-1.1, MX_/1.1, MX_FN10.1, MX_RALT2.1, MX_RGUI1.1, MX_[1.1, U1.48
COL12: MX_=1.1, MX_BACK3.1, MX_FN11.1, MX_RGUI2.1, MX_RMENU1.1, MX_RSHIFT1.1, MX_RSHIFT2.1, MX_]1.1, U1.47
COL13: MX_BACK1.1, MX_BACK2.1, MX_FN12.1, MX_RCTRL1.1, MX_RCTRL2.1, MX_RETURN1.1, MX_RETURN2.1, MX_RSHIFT3.1, MX_\1.1, MX_\2.1, U1.46
COL14: MX_DEL1.1, MX_INS1.1, MX_LFT1.1, MX_PRINT1.1, U1.45
COL15: MX_DN1.1, MX_END1.1, MX_HOME1.1, MX_SLOCK1.1, MX_UP1.1, U1.32
COL16: MX_PAUSE1.1, MX_PGDN1.1, MX_PGUP1.1, MX_RT1.1, U1.31
COL17: MX_NUM1.1, MX_NUM5.1, MX_NUM9.1, MX_NUM13.1, MX_NUM17.1, MX_NUM21.1, MX_NUM_EX3.1, U1.36
COL18: MX_NUM2.1, MX_NUM6.1, MX_NUM10.1, MX_NUM14.1, MX_NUM18.1, MX_NUM22.1, U1.35
COL19: MX_NUM3.1, MX_NUM7.1, MX_NUM11.1, MX_NUM15.1, MX_NUM19.1, MX_NUM23.1, U1.34
COL20: MX_NUM4.1, MX_NUM8.1, MX_NUM12.1, MX_NUM16.1, MX_NUM20.1, MX_NUM24.1, MX_NUM_EX1.1, MX_NUM_EX2.1, U1.33
D+: RC2.2, U1.5
D-: RC1.1, U1.4
GND: C2.2, C3.2, C4.2, C5.1, C6.1, C7.1, C8.1, J1.6, Q1.3, RC4.2, RC6.1, RC7.1, SW1.1, U1.6, U1.22, U1.53, U1.63, U1.65, U2.1, USB1.1, USB1.12, USB1.13, Y1.2, Y1.4
LEDGND: Q1.2, R1.2, R2.2, R3.2, R4.2, R5.2, R6.2, R7.2, R8.2, R9.2, R10.2, R11.2, R12.2, R13.2, R14.2, R15.2, R16.2, R17.2, R18.2, R19.2, R20.2, R21.2, R22.2, R23.2, R24.2, R25.2, R26.2, R27.2, R28.2, R29.2, R30.2, R31.2, R32.2, R33.2, R34.2, R35.2, R36.2, R37.2, R38.2, R39.2, R40.2, R41.2, R42.2, R43.2, R44.2, R45.2, R46.2, R47.2, R48.2, R49.2, R50.2, R51.2, R52.2, R53.2, R54.2, R55.2, R56.2, R57.2, R58.2, R59.2, R60.2, R61.2, R62.2, R63.2, R64.2, R65.2, R66.2, R67.2, R68.2, R69.2, R70.2, R71.2, R72.2, R73.2, R74.2, R75.2, R76.2, R77.2, R78.2, R79.2, R80.2, R81.2, R82.2, R83.2, R84.2, R85.2, R86.2, R87.2, R88.2, R89.2, R90.2, R91.2, R92.2, R93.2, R94.2, R95.2, R96.2, R97.2, R98.2, R99.2, R100.2, R101.2, R102.2, R103.2, R104.2, R105.2, R106.2, R107.2, R108.2, R109.2, R110.2, R111.2, R112.2, R113.2, R114.2
MISO: J1.1, U1.13
MOSI: J1.4, U1.12
unnamed: C2.1, U1.7
unnamed: D1.2, MX_ESC1.2
unnamed: D2.2, MX_FN1.2
unnamed: D3.2, MX_FN2.2
unnamed: D4.2, MX_FN3.2
unnamed: D5.2, MX_FN4.2
unnamed: D6.2, MX_FN5.2
unnamed: D7.2, MX_FN6.2
unnamed: D8.2, MX_FN7.2
unnamed: D9.2, MX_FN8.2
unnamed: D10.2, MX_FN9.2
unnamed: D11.2, MX_FN10.2
unnamed: D12.2, MX_FN11.2
unnamed: D13.2, MX_FN12.2
unnamed: D14.2, MX_LSHIFT3.2
unnamed: D15.2, MX_NUM1.2
unnamed: D16.2, MX_NUM2.2
unnamed: D17.2, MX_`1.2
unnamed: D18.2, MX_#1.2
unnamed: D19.2, MX_#2.2
unnamed: D20.2, MX_#3.2
unnamed: D21.2, MX_#4.2
unnamed: D22.2, MX_#5.2
unnamed: D23.2, MX_#6.2
unnamed: D24.2, MX_#7.2
unnamed: D25.2, MX_#8.2
unnamed: D26.2, MX_#9.2
unnamed: D27.2, MX_#0_1.2
unnamed: D28.2, MX_-1.2
unnamed: D29.2, MX_=1.2
unnamed: D30.2, MX_BACK1.2, MX_BACK2.2
unnamed: D31.2, MX_BACK3.2
unnamed: D32.2, MX_NUM3.2
unnamed: D33.2, MX_NUM4.2
unnamed: D34.2, MX_NUM5.2
unnamed: D35.2, MX_TAB1.2
unnamed: D36.2, MX_Q1.2
unnamed: D37.2, MX_W1.2
unnamed: D38.2, MX_E1.2
unnamed: D39.2, MX_R1.2
unnamed: D40.2, MX_T1.2
unnamed: D41.2, MX_Y1.2
unnamed: D42.2, MX_U1.2
unnamed: D43.2, MX_I1.2
unnamed: D44.2, MX_O1.2
unnamed: D45.2, MX_P1.2
unnamed: D46.2, MX_[1.2
unnamed: D47.2, MX_]1.2
unnamed: D48.2, MX_\1.2, MX_\2.2
unnamed: D49.2, MX_NUM6.2
unnamed: D50.2, MX_NUM7.2
unnamed: D51.2, MX_NUM8.2
unnamed: D52.2, MX_CLOCK1.2, MX_CLOCK2.1
unnamed: D53.2, MX_A1.2
unnamed: D54.2, MX_S1.2
unnamed: D55.2, MX_D1.2
unnamed: D56.2, MX_F1.2
unnamed: D57.2, MX_G1.2
unnamed: D58.2, MX_H1.2
unnamed: D59.2, MX_J1.2
unnamed: D60.2, MX_K1.2
unnamed: D61.2, MX_L1.2
unnamed: D62.2, MX_;1.2
unnamed: D63.2, MX_'1.2
unnamed: D64.2, MX_NUM9.2
unnamed: D65.2, MX_RETURN1.2, MX_RETURN2.2
unnamed: D66.2, MX_RSHIFT3.2
unnamed: D67.2, MX_LSHIFT1.2, MX_LSHIFT2.2
unnamed: D68.2, MX_Z1.2
unnamed: D69.2, MX_X1.2
unnamed: D70.2, MX_C1.2
unnamed: D71.2, MX_V1.2
unnamed: D72.2, MX_B1.2
unnamed: D73.2, MX_N1.2
unnamed: D74.2, MX_M1.2
unnamed: D75.2, MX_,1.2
unnamed: D76.2, MX_.1.2
unnamed: D77.2, MX_/1.2
unnamed: D78.2, MX_RSHIFT1.2, MX_RSHIFT2.2
unnamed: D79.2, MX_NUM10.2
unnamed: D80.2, MX_NUM11.2
unnamed: D81.2, MX_RGUI2.2, MX_RMENU1.2
unnamed: D82.2, MX_RCTRL1.2, MX_RCTRL2.2
unnamed: D83.2, MX_NUM12.2
unnamed: D84.2, MX_LCTRL1.2, MX_LCTRL2.2
unnamed: D85.2, MX_LGUI1.2, MX_LGUI2.2
unnamed: D86.2, MX_LALT1.2, MX_LALT2.2
unnamed: D87.2, MX_SP1.2, MX_SP2.2
unnamed: D88.2, MX_NUM13.2
unnamed: D89.2, MX_NUM14.2
unnamed: D90.2, MX_RALT1.2
unnamed: D91.2, MX_RALT2.2, MX_RGUI1.2
unnamed: D92.2, MX_PRINT1.2
unnamed: D93.2, MX_SLOCK1.2
unnamed: D94.2, MX_PAUSE1.2
unnamed: D95.2, MX_INS1.2
unnamed: D96.2, MX_HOME1.2
unnamed: D97.2, MX_PGUP1.2
unnamed: D98.2, MX_NUM15.2
unnamed: D99.2, MX_DEL1.2
unnamed: D100.2, MX_END1.2
unnamed: D101.2, MX_PGDN1.2
unnamed: D102.2, MX_NUM16.2, MX_NUM_EX1.2
unnamed: D103.2, MX_NUM17.2
unnamed: D104.2, MX_NUM18.2
unnamed: D105.2, MX_NUM19.2
unnamed: D106.2, MX_NUM20.2
unnamed: D107.2, MX_NUM21.2, MX_NUM_EX3.2
unnamed: D108.2, MX_UP1.2
unnamed: D109.2, MX_NUM22.2
unnamed: D110.2, MX_NUM23.2
unnamed: D111.2, MX_LFT1.2
unnamed: D112.2, MX_DN1.2
unnamed: D113.2, MX_RT1.2
unnamed: D114.2, MX_NUM24.2, MX_NUM_EX2.2
unnamed: MX_#0_1.4, R27.1
unnamed: MX_#1.4, R18.1
unnamed: MX_#2.4, R19.1
unnamed: MX_#3.4, R20.1
unnamed: MX_#4.4, R21.1
unnamed: MX_#5.4, R22.1
unnamed: MX_#6.4, R23.1
unnamed: MX_#7.4, R24.1
unnamed: MX_#8.4, R25.1
unnamed: MX_#9.4, R26.1
unnamed: MX_'1.4, R63.1
unnamed: MX_,1.4, R75.1
unnamed: MX_-1.4, R28.1
unnamed: MX_.1.4, R76.1
unnamed: MX_/1.4, R77.1
unnamed: MX_;1.4, R62.1
unnamed: MX_=1.4, R29.1
unnamed: MX_A1.4, R53.1
unnamed: MX_B1.4, R72.1
unnamed: MX_BACK1.4, MX_BACK2.4, R30.1
unnamed: MX_BACK3.4, R31.1
unnamed: MX_C1.4, R70.1
unnamed: MX_CLOCK1.4, MX_CLOCK2.4, R52.1
unnamed: MX_D1.4, R55.1
unnamed: MX_DEL1.4, R99.1
unnamed: MX_DN1.4, R112.1
unnamed: MX_E1.4, R38.1
unnamed: MX_END1.4, R100.1
unnamed: MX_ESC1.4, R1.1
unnamed: MX_F1.4, R56.1
unnamed: MX_FN1.4, R2.1
unnamed: MX_FN2.4, R3.1
unnamed: MX_FN3.4, R4.1
unnamed: MX_FN4.4, R5.1
unnamed: MX_FN5.4, R6.1
unnamed: MX_FN6.4, R7.1
unnamed: MX_FN7.4, R8.1
unnamed: MX_FN8.4, R9.1
unnamed: MX_FN9.4, R10.1
unnamed: MX_FN10.4, R11.1
unnamed: MX_FN11.4, R12.1
unnamed: MX_FN12.4, R13.1
unnamed: MX_G1.4, R57.1
unnamed: MX_H1.4, R58.1
unnamed: MX_HOME1.4, R96.1
unnamed: MX_I1.4, R43.1
unnamed: MX_INS1.4, R95.1
unnamed: MX_J1.4, R59.1
unnamed: MX_K1.4, R60.1
unnamed: MX_L1.4, R61.1
unnamed: MX_LALT1.4, MX_LALT2.4, R86.1
unnamed: MX_LCTRL1.4, MX_LCTRL2.4, R84.1
unnamed: MX_LFT1.4, R111.1
unnamed: MX_LGUI1.4, MX_LGUI2.4, R85.1
unnamed: MX_LSHIFT1.4, MX_LSHIFT2.4, R67.1
unnamed: MX_LSHIFT3.4, R14.1
unnamed: MX_M1.4, R74.1
unnamed: MX_N1.4, R73.1
unnamed: MX_NUM1.4, R15.1
unnamed: MX_NUM2.4, R34.1
unnamed: MX_NUM3.4, R49.1
unnamed: MX_NUM4.4, R50.1
unnamed: MX_NUM5.4, R51.1
unnamed: MX_NUM6.4, R64.1
unnamed: MX_NUM7.4, R79.1
unnamed: MX_NUM8.4, R80.1
unnamed: MX_NUM9.4, R83.1
unnamed: MX_NUM10.4, R88.1
unnamed: MX_NUM11.4, R89.1
unnamed: MX_NUM12.4, R92.1
unnamed: MX_NUM13.4, R93.1
unnamed: MX_NUM14.4, R94.1
unnamed: MX_NUM15.4, R98.1
unnamed: MX_NUM16.4, MX_NUM_EX1.4, R102.1
unnamed: MX_NUM17.4, R103.1
unnamed: MX_NUM18.4, R104.1
unnamed: MX_NUM19.4, R105.1
unnamed: MX_NUM20.4, R106.1
unnamed: MX_NUM21.4, MX_NUM_EX3.4, R107.1
unnamed: MX_NUM22.4, R109.1
unnamed: MX_NUM23.4, R110.1
unnamed: MX_NUM24.4, MX_NUM_EX2.4, R114.1
unnamed: MX_O1.4, R44.1
unnamed: MX_P1.4, R45.1
unnamed: MX_PAUSE1.4, R33.1
unnamed: MX_PGDN1.4, R101.1
unnamed: MX_PGUP1.4, R97.1
unnamed: MX_PRINT1.4, R16.1
unnamed: MX_Q1.4, R36.1
unnamed: MX_R1.4, R39.1
unnamed: MX_RALT1.4, R90.1
unnamed: MX_RALT2.4, MX_RGUI1.4, R91.1
unnamed: MX_RCTRL1.4, MX_RCTRL2.4, R82.1
unnamed: MX_RETURN1.4, MX_RETURN2.4, R65.1
unnamed: MX_RGUI2.4, MX_RMENU1.4, R81.1
unnamed: MX_RSHIFT1.4, MX_RSHIFT2.4, R78.1
unnamed: MX_RSHIFT3.4, R66.1
unnamed: MX_RT1.4, R113.1
unnamed: MX_S1.4, R54.1
unnamed: MX_SLOCK1.4, R32.1
unnamed: MX_SP1.4, MX_SP2.4, R87.1
unnamed: MX_T1.4, R40.1
unnamed: MX_TAB1.4, R35.1
unnamed: MX_U1.4, R42.1
unnamed: MX_UP1.4, R108.1
unnamed: MX_V1.4, R71.1
unnamed: MX_W1.4, R37.1
unnamed: MX_X1.4, R69.1
unnamed: MX_Y1.4, R41.1
unnamed: MX_Z1.4, R68.1
unnamed: MX_[1.4, R46.1
unnamed: MX_\1.4, MX_\2.4, R48.1
unnamed: MX_]1.4, R47.1
unnamed: MX_`1.4, R17.1
unnamed: Q1.1, RC5.2
unnamed: RC1.2, U2.3, USB1.5, USB1.7
unnamed: RC2.1, U2.2, USB1.6, USB1.8
unnamed: RC4.1, U1.43
unnamed: RC5.1, U1.17
unnamed: RC6.2, USB1.4
unnamed: RC7.2, USB1.10
RESET: J1.5, RC3.2, SW1.2, U1.20
ROW0: D1.1, D2.1, D3.1, D4.1, D5.1, D6.1, D7.1, D8.1, D9.1, D10.1, D11.1, D12.1, D13.1, D15.1, D16.1, D32.1, D33.1, D92.1, D93.1, D94.1, U1.37
ROW1: D17.1, D18.1, D19.1, D20.1, D21.1, D22.1, D23.1, D24.1, D25.1, D26.1, D27.1, D28.1, D29.1, D30.1, D34.1, D49.1, D50.1, D51.1, D95.1, D96.1, D97.1, U1.38
ROW2: D35.1, D36.1, D37.1, D38.1, D39.1, D40.1, D41.1, D42.1, D43.1, D44.1, D45.1, D46.1, D47.1, D48.1, D64.1, D79.1, D80.1, D83.1, D99.1, D100.1, D101.1, U1.39
ROW3: D31.1, D52.1, D53.1, D54.1, D55.1, D56.1, D57.1, D58.1, D59.1, D60.1, D61.1, D62.1, D63.1, D65.1, D88.1, D89.1, D98.1, D102.1, U1.40
ROW4: D14.1, D66.1, D67.1, D68.1, D69.1, D70.1, D71.1, D72.1, D73.1, D74.1, D75.1, D76.1, D77.1, D78.1, D103.1, D104.1, D105.1, D106.1, D108.1, U1.41
ROW5: D81.1, D82.1, D84.1, D85.1, D86.1, D87.1, D90.1, D91.1, D107.1, D109.1, D110.1, D111.1, D112.1, D113.1, D114.1, U1.42
SCK: J1.3, U1.11
VCC: F1.2, U2.4, USB1.2, USB1.11
XTAL1: C3.1, U1.24, Y1.1
XTAL2: C4.1, U1.23, Y1.3
