pesantsi/CustomPcbs/(commit log)

2020-03-02 Init pcb's
    [Ansi111.kicad_pcb, Ansi111.sch]
2020-03-05 Adding Matrix Schema
    [Matrix.sch]
2020-03-06 Adding Voyager104
    [Voyager104-B.Cu.gbl, Voyager104-B.Mask.gbs, Voyager104-B.Paste.gbp, Voyager104-B.SilkS.gbo, Voyager104-Edge.Cuts.gm1, Voyager104-F.Cu.gtl, Voyager104-F.Mask.gts, Voyager104-F.Paste.gtp]
2020-03-30 Adding TooManykeys
    [TooManyKeys.kicad_pcb, TooManyKeys.sch]
2020-03-31 Matrix sch finished
    [Matrix.sch, TooManyKeys.sch]
2020-04-01 adding voltage controller and i2c controller
    [Led.sch, Matrix.sch, TooManyKeys.sch, duckypad_v2_bom.xlsx]
2020-04-01 finish work on matrix
    [Matrix.sch]
2020-04-03 adding IS31FL3733-TQ to led sch
    [Led.sch, TooManyKeys.sch]
2020-04-10 led work
    [Led.sch]
2020-12-21 Adding led matrix
    [Led.sch, TooManyKeys.sch]
2020-12-21 V1 Schematics
    [Led.sch, TooManyKeys.sch]
2020-12-21 WIP pcb
    [Led.sch, Matrix.sch, TooManyKeys.sch]
2020-12-22 WIP pcb 2
    [TooManyKeys.kicad_pcb]
2020-12-24 changes made to schematics following upwork
    [TooManyKeys.kicad_pcb, TooManyKeys.sch]
2020-12-29 Final Schematic version, starting work on pcb
    [Led.sch, Matrix.sch, TooManyKeys.kicad_pcb, TooManyKeys.sch]
2021-01-01 V1 New Led Positions
    [TooManyKeys.kicad_pcb]
2021-01-01 Led alignment
    [TooManyKeys.kicad_pcb]
2021-01-02 Partial Routing
    [TooManyKeys.kicad_pcb]
2021-01-13 New footprint, pcb key matrix completed
    [Led.sch, Matrix.sch, TooManyKeys.kicad_pcb, TooManyKeys.sch]
2021-01-17 Before changing to new led and moving mcu caps and usb resistors
    [TooManyKeys.kicad_pcb, TooManyKeys.sch]
2021-01-17 New led symbols and footprint
    [TooManyKeys.sch]
2021-01-18 RBG Led replaced
    [Led.sch, TooManyKeys.kicad_pcb, TooManyKeys.sch]
2021-01-20 Updated RGB Led footprint and more routing
    [TooManyKeys.kicad_pcb]
2021-01-22 Almost done, some routing left
    [TooManyKeys.kicad_pcb]
2021-01-27 switch plate
    [4840ab9af1085f85478faeb8f759408f03c61fd2_switch.dxf, TooManyKeys.csv]
2021-01-28 plate and board diagrams
    [4840ab9af1085f85478faeb8f759408f03c61fd2_switch.dxf, board_switch.dxf]
2021-01-28 Folder Updates
    [Led.sch, Matrix.sch, TooManyKeys.kicad_pcb, TooManyKeys.sch, duckypad_v2_bom.xlsx]
2021-01-28 Initial commit for driver
2021-01-29 After extensive work
    [Led.sch, TooManyKeys.kicad_pcb]
2021-01-29 Updated Logo
    [TooManyKeys.kicad_pcb]
2021-01-30 Missing F10 key
    [TooManyKeys.kicad_pcb]
2021-02-01 switch plate diagrams
    [board_switch_R14.dxf]
2021-02-01 Final Version of Schematic and PCB
    [TooManyKeys.kicad_pcb, TooManyKeys.sch, TooManyKeys2.html.xlsx]
2021-02-01 Gerber Files
    [TooManyKeys-B_Cu.gbl, TooManyKeys-B_Mask.gbs, TooManyKeys-B_Paste.gbp, TooManyKeys-B_SilkS.gbo, TooManyKeys-Edge_Cuts.gm1, TooManyKeys-F_Cu.gtl, TooManyKeys-F_Mask.gts, TooManyKeys-F_Paste.gtp]
2021-02-02 Update for solder mask IC pins of 0.22mm
    [TooManyKeys.kicad_pcb]
2021-02-02 Diagrams V2 and gerber files updated
    [TooManyKeys-B_Cu.gbl, TooManyKeys-B_Mask.gbs, TooManyKeys-B_Paste.gbp, TooManyKeys-B_SilkS.gbo, TooManyKeys-Edge_Cuts.gm1, TooManyKeys-F_Cu.gtl, TooManyKeys-F_Mask.gts, TooManyKeys-F_Paste.gtp]
2021-02-02 Working version of Driver Update
2021-02-05 Update files for manufacturing
    [Updated T-1N2W367723A-W367723AS1N1-1sets-TooManyKeys2.html 2021-2-5.xlsx]
2021-02-05 Final version of switch plate
    [4840ab9af1085f85478faeb8f759408f03c61fd2_switch_V2.dxf, AnyConv.com__44eeba771a5b6c852af2286e39a3858f011b3c9f_switch_v2.dxf, TooManyKeys2.html.xlsx, board_switch_v3.dxf]
2021-02-05 useless file
    [AnyConv.com__44eeba771a5b6c852af2286e39a3858f011b3c9f_switch_v2.dxf]
2021-02-24 Adding PCBWay pics
2021-04-23 Update LED footprint, missing SMT assembly property
    [TooManyKeys.kicad_pcb]
2021-05-14 Flip Led Footprint
    Added version 1.5 to pcb
    Added version 1.2 to sch
    Added proper Level Shifter to BOM
    [Led.sch, Matrix.sch, TooManyKeys.kicad_pcb, TooManyKeys.sch, Updated T-1N2W367723A-W367723AS1N1-1sets-TooManyKeys2.html 2021-2-5.xlsx]
2021-05-14 Finished work on new led footprint, need to double check
    [TooManyKeys.kicad_pcb]
2021-05-17 Set Led footprint text position
    Renaming items in footprint library
    [TooManyKeys.kicad_pcb, TooManyKeys.sch]
2021-05-17 Updating pcb with IS31FL3733-TQLS4 footprint
    [TooManyKeys.kicad_pcb]
2021-05-18 All designator are properly placed
    [TooManyKeys.kicad_pcb]
2021-05-19 Missing Shift key + routing
    [TooManyKeys.kicad_pcb]
2021-05-19 Missing Shift key + routing save
    [TooManyKeys.kicad_pcb]
2021-05-19 + Routing
    [TooManyKeys.kicad_pcb]
2021-05-20 Final routing + properly saved 3 pins footprint
    [TooManyKeys.kicad_pcb]
2021-05-20 Final fill ground plane
    [TooManyKeys.kicad_pcb]
2021-05-20 V1.5 Gerber files
    [TooManyKeys-B_Cu.gbl, TooManyKeys-B_Mask.gbs, TooManyKeys-B_Paste.gbp, TooManyKeys-B_SilkS.gbo, TooManyKeys-Edge_Cuts.gm1, TooManyKeys-F_Cu.gtl, TooManyKeys-F_Mask.gts, TooManyKeys-F_Paste.gtp]
2021-06-26 Changes following contractor review( ressources / Schematic Review.docx )
    [TooManyKeys.sch]
2021-07-21 Creating Proto for TooManyKeys
    [ProtoTooManyKeys.kicad_pcb, ProtoTooManyKeys.sch]
2021-07-21 Routing finished
    [ProtoTooManyKeys.kicad_pcb, ProtoTooManyKeys.sch]
2021-07-22 Final touches on Proto and added a missing capacitor
    [ProtoTooManyKeys-B_Cu.gbl, ProtoTooManyKeys-B_Mask.gbs, ProtoTooManyKeys-B_Paste.gbp, ProtoTooManyKeys-B_SilkS.gbo, ProtoTooManyKeys-Edge_Cuts.gm1, ProtoTooManyKeys-F_Cu.gtl, ProtoTooManyKeys-F_Mask.gts, ProtoTooManyKeys-F_Paste.gtp]
2021-07-22 routing fixes, new gerber files
    [ProtoTooManyKeys-B_Cu.gbl, ProtoTooManyKeys-B_Mask.gbs, ProtoTooManyKeys-B_Paste.gbp, ProtoTooManyKeys-B_SilkS.gbo, ProtoTooManyKeys-Edge_Cuts.gm1, ProtoTooManyKeys-F_Cu.gtl, ProtoTooManyKeys-F_Mask.gts, ProtoTooManyKeys-F_Paste.gtp]
2021-07-22 updated gerber files + latest bom
    [ProtoTooManyKeys.xlsx, Updated T-1N2W367723A-W367723AS1N1-1sets-TooManyKeys2.html 2021-2-5 (2).xlsx]
2021-07-23 updated gerber files
    [ProtoTooManyKeys-B_Cu.gbl, ProtoTooManyKeys-B_Mask.gbs, ProtoTooManyKeys-B_Paste.gbp, ProtoTooManyKeys-B_SilkS.gbo, ProtoTooManyKeys-Edge_Cuts.gm1, ProtoTooManyKeys-F_Cu.gtl, ProtoTooManyKeys-F_Mask.gts, ProtoTooManyKeys-F_Paste.gtp]
2022-01-21 NextPCB Bom
    [P-5PCS-ProtoTooManyKeys-7-26.xlsx]
